mruggia/momav/README.md

# MOMAV

Codebase of the MOMAV omnidirectional drone. Further information can be found on the project website: 

[https://marcoruggia.ch/home?projects_momav](https://marcoruggia.ch/home?projects_momav)
