mruggia/momav/5_test/1_flight/overview.xlsx

date | place | type | nr | result | bag | prm | vid | changes | result
06.05.2022 | tivoli7 | static | 001 |  |  |  |  | with weights on legs, go to theoretical hover throttle and back | SUCCESS
 |  |  | 002 |  |  |  |  | with weights on legs, at min throttle, send all x,y,r,p,y commands, then do the same at hover throttle | SUCCESS
09.05.2022 | fhgr | manual | 003 |  |  |  |  | throttle up, no inputs | drifted -x +y
 |  |  | 004 |  |  |  |  | full stick +y,+x | drifted (y stick is flipped)
 |  |  | 005 |  |  |  |  | same as 004 | reacts to inputs
 |  |  | 006 |  |  |  |  | x+50%, y-50% trim | drift +y
 |  |  | 007 |  |  |  |  | x+50%, y-100% trim, flip y on remote | drift roughly correct
 |  |  | 008 |  |  |  |  | P_rot=0.4 | drift +y
 |  |  | 009 |  |  |  |  | y stick correction | SUCCESS
 |  |  | 010 |  |  |  |  | set ofset in remote instead of trim x:12,y:30, P_rot=0.6 | drift +y
 |  |  | 011 |  |  |  |  | remote offset y:-35 | ok, attitude not great
 |  |  | 012 |  |  |  |  | remote offset y:-30, P_rot=0.7,D_rot=0.1 | success?
 |  |  | 013 |  |  |  |  | P_rot=1.2,D_rot=0.15 | heavy oscilaltion at start but files ok
 |  |  | 014 |  |  |  |  | P_rot=2.0 | roll oscillations
 |  |  | 015 |  |  |  |  | P_rot=1.6,D_rot=0.2 | failed to save chages, redo
 |  |  | 016 |  |  |  |  | redo of 015 | slightly oscillating
 |  |  | 017 |  |  |  |  | P_rot=1.2,D_rot=0.15 | PD tuning "good"
 |  |  | 018 |  |  |  |  | try roll offset on remote | roll:-80 seems good
 |  |  | 019 |  |  |  |  | pretty flight for video | SUCCESS
16.05.2022 | fhgr | manual | 020 |  |  |  |  | redo previous, p=1.2,d=0.15 | SUCCESS
 |  |  | 021 |  |  |  |  | p=2.0,d=0.2 | oscillatin worse?
 |  |  | 022 | !! |  |  |  | p=4.0, d=0.4 | CRASH
27.06.2022 | fhgr | manual | 023 |  |  |  |  | p=1.2, d=0.15 | ok, not much drift
 |  |  | 024 |  |  |  |  | same, move roll setp | ok (pulled on tether)
 |  |  | 025 |  |  |  |  | same, move pitch setp | ok (pulled on tether)
 |  |  | 026 |  |  |  |  | p=1.6, d=0.15 | same?
 |  |  | 027 |  |  |  |  | p=1.6, d=0.10 | worse
 |  |  | 028 |  |  |  |  | p=1.2, d=0.20 | better, CRASH
 |  |  | 029 |  |  |  |  | p=1.2, d=0.25 | heavy drift from crash
 |  |  | 030 |  |  |  |  | p=1.2, d=0.15 | confirm heavy drift + fix arm up by eye
 |  |  | 031 |  |  |  |  | P=1.2, d=0.25 | better?
 |  |  | 032 |  |  |  |  | p=1.2, d=0.30 | same?
 |  |  | 033 |  |  |  |  | p=0.8, d=0.20 | worse
 |  |  | 034 |  |  |  |  | p=1.0, d=0.25 | better
 |  |  | 035 |  |  |  |  | same, move pitch setp | OK
19.11.2023 | tivoli11 | cam+man | 036 |  |  |  |  | state=cam, pos ctrl, ... | good, wobbly in orientation
 |  |  | 037 |  |  |  |  | d_rot=0.0 | unstable orientation
 |  |  | 038 |  |  |  |  | d_pos=0.0 | unstable position
 |  |  | 039 |  |  |  |  | d_rot=0.3 | feedback loop when on ground
 |  |  | 040 |  |  |  |  | p_rot=1.2 | better?
 |  |  | 041 |  |  |  |  | p_rot=1.5 | better
 |  |  | 042 |  |  |  |  | p_rot=1.8 | worse?
 |  |  | 043 |  |  |  |  | p_rot=2.2 | worse
 |  |  | 044 |  |  |  |  | p_rot=1.5 (keep), d_rot=0.25 | better, oscillation on ground
 |  |  | 045 |  |  |  |  | d_rot=0.3 + stable ground | sensible to oscillation
 |  |  | 046 |  |  |  |  | d_rot=0.25 (keep) + average cf,cm | hard to say
 |  |  | 047 |  |  |  |  | revert cf, cm | same
 |  |  | 048 |  |  |  |  | keep average cf,cm for simplicity p_rot=1.6 | worse
 |  |  | 049 |  |  |  |  | p_rot=1.4 | same?
 |  |  | 050 |  |  |  |  | p_rot=1.2 | sameish
 |  |  | 051 |  |  |  |  | p_rot=1.4 (keep), d_pos=10 | good
 |  | sim | 052 |  |  |  |  | state=sim | ok
 |  | cam+man | 053 |  |  |  |  | p_rot=1.4,d_rot=0.25,p_pos=50,d_pos=15 | ok
 |  |  | 054 |  |  |  |  | p_pos=60, d_pos=12 | too much oscillation
 |  |  | 055 |  |  |  |  | p_rot=1.4,d_rot=0.25, p_pos=40, d_pos=8 (keep) + fly xyz, rpy | GOOD
 |  |  | 056 |  |  |  |  | repeat | GOOD
 |  |  | 057 |  |  |  |  | check takeoff thrust | z_idle = -100mm, z_offset=-180mm
 |  |  | 058 |  |  |  |  | cf=18 | forgot to upload
 |  |  | 059 |  |  |  |  | cf=12 | forgot to upload
 |  |  | 060 |  |  |  |  | cf=14 repeat | better
 |  |  | 061 |  |  |  |  | cf=12 (keep) | no more z pos err
 |  |  | 062 |  |  |  |  | z_min=-0.1 avoid oscillation | wrench setpoint to high
 |  |  | 063 |  |  |  |  | arm_lim_fz=20, z_min=-0.25 | ok
 |  |  | 064 |  |  |  |  | i_pos=5, i_pos_lim=4 | OK
 |  |  | 065 |  |  |  |  | i_pos_lim=6 | no more pos static offset
 |  |  | 066 |  |  |  |  | i_rot=0.2, i_rot_lim=0.2 | still offset
 |  |  | 067 |  |  |  |  | i_rot_lim=0.5 | still offset
 |  |  | 068 |  |  |  |  | I_rot_lim=0.4 + fixed code bug | better
 |  |  | 069 |  |  |  |  | I_rot_lim=0.6, I_t_sat=5.0 | GOOD
 |  |  | 070 |  |  |  |  | repeat with moving setpoints | GOOD
 |  | sim | 071 |  |  |  |  | aph=6.28, state=sim | passed
 |  | cam+man | 072 |  |  |  |  | repeat irl | better?
 |  |  | 073 |  |  |  |  | aph=3.14 | works, maybe better..
 |  | slowmo | 074 |  |  |  |  | slow motion hover video | OK
 |  | free | 075 |  |  |  |  | tetherless | SUCCESS!
20.11.2023 | tivoli11 | cam+man | 076 |  |  |  |  | navigator acc/vel limit & aw=1e-4, apw=1e-2 | OK
 |  |  | 077 |  |  |  |  | repeat | OK
 |  |  | 078 |  |  |  |  | aw=1e-3, apw=1e-2 | weird thorttle spike heard. aborted.
 |  |  | 079 |  |  |  |  | vel_pos=0.6, acc_pos=0.3 | better
 |  |  | 080 |  |  |  |  | aw=5e-4, awp=5e-2 | same?
 |  |  | 081 |  |  |  |  | cm=0,0,0,... | same?
 |  |  | 082 |  |  |  |  | d_rot=0.3 | better
 |  |  | 083 |  |  |  |  | d_rot=0.35 | same?
 |  |  | 084 |  |  |  |  | d_rot=0.4 (keep) | same?
 |  |  | 085 |  |  |  |  | d_rot=0.5 | worse, twitchy on the ground
 |  |  | 086 |  |  |  |  | various pid params | better
 |  |  | 087 |  |  |  |  | hover screenshot | ok, but low battery
 |  |  | 088 |  |  |  |  | repeat with new battery | wobbly
 |  |  | 089 |  |  |  |  | revert to old pid | better?
 |  |  | 090 |  |  |  |  | back to new pid | worse
 |  |  | 091 |  |  |  |  | p_rot=1, d_rot=0.2 (weaken) | worse?
 |  |  | 092 |  |  |  |  | revert | ok
 |  |  | 093 |  |  |  |  | d_rot=0.3, d_pos=10 | worse?
 |  |  | 094 |  |  |  |  | revert | better
 |  |  | 095 |  |  |  |  | cf=14 | position offset
 |  |  | 096 |  |  |  |  | nice video | error on takeoff
 |  |  | 097 |  |  |  |  | nice video | OK
24.11.2023 | tivoli11 | cam+traj | 098 |  |  |  |  | test position setpoint trajectory for first time | wobbly orientation, aborted
 |  |  | 099 | ! |  |  |  | repeat | failed i2c error, aborted
 |  |  | 100 |  |  |  |  | repeat | success
 |  |  | 101 | ! |  |  |  | test orientation setpoint trajectory | wrench_controller failed. exceeded max iterations
 |  |  | 102 | ! |  |  |  | repeat | body_state_cam topic timed out
 |  |  | 103 | ! |  |  |  | repeat | wrench_controller failed. exceeded max iterations
 |  | cam+man | 104 |  |  |  |  | try manual setpoint changesn + more lights | OK (1x wrench_controller max iter.)
 |  | cam+traj | 105 | ! |  |  |  | orientation setpoint trajectory | oscillation + unstable before starting setpoint trajectory
 |  |  | 106 | ! |  |  |  | reset camera, max_iter=32 | at ~270° yaw: wrench_controller failed. exceeded max iterations
 |  | other | 107 |  |  |  |  | test spinning on chair | no problems
 |  | cam+traj | 108 |  |  |  |  | orientation setpoint trajectory (normalize quaternions in code) | oscillation again... abort
 |  |  | 109 | !! |  |  |  | reset camera + repeat | controller_wrench failed. throttle out of range -> broke landing gear
25.11.2023 | tivoli11 | cam+traj | 110 |  |  |  |  | fixed bugs -> redo pos. setp. traj. | oscillating
 |  |  | 111 |  |  |  |  | removed feedforward terms | same
 |  |  | 112 |  |  |  |  | try rot. set. traj. | no more crash! still oscillating
 |  |  | 113 |  |  |  |  | disable integral | still oscillating
 |  |  | 114 |  |  |  |  | p&d *0.75 | still oscillating
 |  | track+man | 115 | !! |  |  |  | try optitrack pose estim | same oscillation-> lost tracking -> CRASH
 |  |  | 116 | !! |  |  |  | repeat, hardcoded track hz | lost tracking, dropped packets -> CRASH
 |  | cam+man | 117 |  |  |  |  | revert back to camera, readjust motor zero | arm 6 not spinning -> defect brush ring!
 |  |  | 118 | ! |  |  |  | fixed brush ring | camera timeout -> CRASH
 |  |  | 119 |  |  |  |  | repeat | battery empty
 |  | cam+traj | 120 |  |  |  |  | pos. set. traj. | SUCCESS
 |  |  | 121 | !! |  |  |  | rot. set. traj. | noticed cam pos estim errors! i2c motor write/read error! -> CRASH
26.11.2023 | tivoli11 | cam+traj | 122 | !! |  |  |  | pos. set. traj. | arm 2 not spinning
 |  |  | 123 |  |  |  |  | repeat | arm 6 not spinning
 |  |  | 124 |  |  |  |  | repeat | SUCCESS
 |  |  | 125 |  |  |  |  | rot. set. traj. | SUCCESS
02.12.2023 | tivoli11 | cam+traj | 126 |  |  |  |  | pos. set. traj. + some bugfixes | ok, a bit wobbly
 |  |  | 127 |  |  |  |  | rot. set. traj. | ok, a bit wobbly + one motor starts spinning later than the others!
 |  | track | 128 |  |  |  |  | track without motors spinning | packet delays
 |  |  | 129 |  |  |  |  | repeat with code fixes | same. delay between camera and motive.
 |  |  | 130 |  |  |  |  | repeat with cameras on desk (shorter cables, official router) | same
 |  |  | 131 |  |  |  |  | fix code for mocap track (adds delay....) | same delay also on ros network packets...
 |  |  | 132 |  |  |  |  | repeat with laptop + momav_net hotspot | works. only minor packet delay/jitter
07.12.2023 | tivoli11 | track | 133 |  |  |  |  | new ground pc + marco_net: latency test | ok latency
 |  |  | 134 |  |  |  |  | new ground pc + drone_net hotspot 2.4ghz: latency test | spikes at end?
 |  |  | 135 |  |  |  |  | new ground pc + drone_net hotspot 5ghz: latency test | same, spikes at end -> ground pc hotspot no good!
11.12.2023 | tivoli11 | track+pos | 136 | !! |  |  |  | pos. set. traj with new ground pc & router | crash, lost wifi for 0.4sec
 |  |  | 137 |  |  |  |  | repeat, set wifi 2.5ghz | success, wobbly, body_setp_track timestamps offset!
 |  | track+rot | 138 |  |  |  |  | rot. set. traj. | aborted. weird sound, otherwise good start, still wobbly
 |  | track+pos | 139 |  |  |  |  | repeat set. traj with fixed timestamps | OK
 |  | track+rot | 140 |  |  |  |  | rot. set. traj. | remote_driver timeout?
 |  |  | 141 |  |  |  |  | repeat | OK
 |  |  | 142 |  |  |  |  | rever cf, cm to calibrated data (corrected for hover) | same
 |  |  | 143 |  |  |  |  | double integral I_pos=10, I_rot=0.4
 |  |  | 144 |  |  |  |  | increase integral I_pos=15, I_rot=0.6 (keep) | aborted. battery
 |  |  | 145 |  |  |  |  | repeat | slightly unstable
 |  |  | 146 | ! |  |  |  | increase derivative D_pos=10, D_rot=0.35 | oscillating in orientation, crash
 |  |  | 147 |  |  |  |  | D_pos=12, D_rot=0.25 (keep)
 |  |  | 148 |  |  |  |  | I_pos=20, I_rot=0.8 | better pos, oscillating a bit in rot
 |  |  | 149 |  |  |  |  | I_pos=30, I_rot=0.6
 |  |  | 150 |  |  |  |  | I_pos=40, I_rot=1.2
 |  |  | 151 |  |  |  |  | I_pos=60, I_rot=1.0
 |  |  | 152 |  |  |  |  | I_pos=80, I_rot=1.2
 |  |  | 153 |  |  |  |  | I_pos=100, I_rot=1.6 | loads of oscillation
 |  |  | 154 |  |  |  |  | I_pos=120, I_rot=1.0
 |  |  | 155 |  |  |  |  | I_pos=140, I_rot=0.8
 |  |  | 156 | ! |  |  |  | I_pos=120, I_rot=0.8, P_pos=60, D_pos=18 | crash
 |  |  | 157 |  |  |  |  | P_pos=60, D_pos=12 | ok, oscillation on ground, aborted for battery
 |  |  | 158 |  |  |  |  | P_pos=80 | oscillating
 |  | track+free | 159 |  |  |  |  | P_pos=100, D_pos=8 | oscillating heavily
 |  |  | 160 |  |  |  |  | P_pos=80, D_pos=8 | still oscillating in position
 |  | track+rot | 161 |  |  |  |  | P_pos=80, D_pos=12 (keep)
 |  |  | 162 |  |  |  |  | I_rot=1.2
 |  |  | 163 |  |  |  |  | I_rot=1.6, D_rot=0.20 | worse
 |  |  | 164 |  |  |  |  | ???
 |  |  | 165 |  |  |  |  | P_rot=1.4, I_rot=1.2, D_rot=0.3
 |  |  | 166 |  |  |  |  | P_rot=1.2
 |  |  | 167 |  |  |  |  | P_rot=1.0, D_rot=0.25
 |  |  | 168 |  |  |  |  | P_rot=1.2, D_rot=0.25
 |  |  | 169 |  |  |  |  | P_rot=1.4, D_rot=0.25
 |  |  | 170 |  |  |  |  | P_rot=1.6, D_rot=0.25
 |  |  | 171 |  |  |  |  | P_rot=1.6, D_rot=0.30
 |  |  | 172 |  |  |  |  | P_rot=1.4, D_rot=0.30
 |  |  | 173 |  |  |  |  | P_rot=1.4, D_rot=0.25 (keep)
 |  |  | 174 |  |  |  |  | I_rot=1.6 (keep) | battery empty
 |  |  | 175 | ! |  |  |  | upl=0.02, uph=0.98, aph=1.57 | crash
 |  |  | 176 |  |  |  |  | revert
 |  |  | 177 |  |  |  |  | repeat
 |  |  | 178 |  |  |  |  | repeat
 |  |  | 179 |  |  |  |  | upl=0.02, uph=0.98, aph=6.28
 |  |  | 180 |  |  |  |  | upl=0.5, uph=0.95
 |  |  | 181 |  |  |  |  | repeat
 |  | track+pos | 182 |  |  |  |  | track+pos (aph=3.14) | battery empty
 |  | track+rot | 183 |  |  |  |  | track+rot repeat | bad config at takeoff
 |  |  | 184 |  |  |  |  | repeat
 |  |  | 185 |  |  |  |  | D_rot=0.3 | worse, revert.
 |  |  | 186 |  |  |  |  | repeat, revert D_rot=0.25
 |  |  | 187 | ! |  |  |  | repeat
 |  | track+pos | 188 | ! |  |  |  | track+pos
 |  |  | 189 |  |  |  |  | repeat
 |  |  | 190 |  |  |  |  | repeat | battery empty
13.12.2023 | tivoli11 | track+rot | 191 |  |  |  |  | track+rot like before | ok
 |  |  | 192 |  |  |  |  | drive_track filter=0.15 | crash, lost tracking
 |  |  | 193 |  |  |  |  | repeat | much worse oscillation
 |  |  | 194 |  |  |  |  | drive_track filter=0.5 | very stable takeoff, then flips out, track cam 1 disconnected!
 |  |  | 195 |  |  |  |  | repeat | WAY WAY WAY less oscillation!!
 |  | track+free | 196 |  |  |  |  | move arround to test free mode | ok
 |  |  | 197 |  |  |  |  | vel_pos=1.0, acc_pos=0.5
 |  | cam+free | 198 |  |  |  |  |  | ok, position estimate juming, room dark?
14.12.2023 | fhgr | cam+free | 199 |  |  |  |  | demo | very jumpy + wobbly
 |  |  | 200 |  |  |  |  | D_rot=0.2 | very jumpy + wobbly
 |  |  | 201 |  |  |  |  | z_min=-0.05 to avoid oscillation.. | very jumpy + wobbly
 |  | cam+pos | 202 |  |  |  |  | pos traj | very jumpy + wobbly
 |  |  | 203 |  |  |  |  | pos traj + added more features on walls + covered windows | a bit better
 |  | cam+free | 204 |  |  |  |  | demo | ok, not great
 |  |  | 205 |  |  |  |  | demo | ok, not great
 |  |  | 206 |  |  |  |  | demo | ok, not great
17.12.2023 | tivoli11 | track+free | 207 | ! |  |  |  | test changes to driver_track (les latency?) | crash. unstable
 |  |  | 208 |  |  |  |  | D_rot=0.15, D_pos=8 | better
 |  |  | 209 |  |  |  |  | D_rot=0.20, D_pos=12 | worse. jerks
 |  |  | 210 |  |  |  |  | driver_track flt_lat=0.0 | better?
 |  |  | 211 |  |  |  |  | driver_track flt_lat=-0.005 | worse?
 |  |  | 212 |  |  |  |  | reorient axes in optitrack, flt_lat=0.0
 |  |  | 213 |  |  |  |  | d_rot=0.25 | too much oscillation
 |  |  | 214 | !! |  |  |  | d_rot=0.4 | crash
 |  |  | 215 |  |  |  |  | d_rot=0.2, d_pos=10 | ok, bit wobbly
 |  | track+rot | 216 |  |  |  |  | flt_win=12 | ok, wobbly in position
 |  |  | 217 |  |  |  |  | flt_win=24, bugfix driver_track | better?
 |  | track+free | 218 | !! |  |  |  | d_rot=0.25 | crash (ripped of antenna....)
 |  |  | 219 | ! |  |  |  | d_rot=0.2, d_pos=10, remove latency predict from driver_track | drift, uncontrolled??
 |  |  | 220 |  |  |  |  | retry | same
 |  |  | 221 |  |  |  |  | fix bug in driver_track | ok, wobbly in position
 |  |  | 222 |  |  |  |  | d_pos=8 | worse?
 |  |  | 223 |  |  |  |  | d_pos=6 | worse
 |  | track+pos | 224 |  |  |  |  | d_pos=16 | better. much better pos ctrl
 |  | track+rot | 225 |  |  |  |  | d_rot=0.25 (revert) | worse
 |  |  | 226 |  |  |  |  | p_rot=1.2 | worse
 |  |  | 227 | ! |  |  |  | p_rot=1.6 | worse. abort
 |  |  | 228 |  |  |  |  | d_rot=0.15 | wobbly
 |  |  | 229 |  |  |  |  | p_rot=1.2, d_rot=0.15 | wobbly
 |  |  | 230 |  |  |  |  | p_rot=1.4, d_rot=0.2 (original) | OK
 |  |  | 231 |  |  |  |  | p_rot=1.6, d_rot=0.25 | better. high freq wobble
 |  |  | 232 |  |  |  |  | i_rot=2.0 | better? more!
 |  |  | 233 |  |  |  |  | i_rot=3.0 | unstable
 |  |  | 234 |  |  |  |  | i_rot=2.4 | unstable
 |  |  | 235 |  |  |  |  | i_rot=2.0 | unstable??? was stable before.. cause: new battery?
 |  |  | 236 |  |  |  |  | i_rot=1.6 | still unstable. not the cause..
 |  |  | 237 |  |  |  |  | p_rot=1.4, d_rot=0.2 | OK
 |  |  | 238 |  |  |  |  | i_rot=3.0
 |  |  | 239 |  |  |  |  | i_rot=4.0
 |  |  | 240 |  |  |  |  | i_rot=6.0
 |  |  | 241 |  |  |  |  | i_rot=8.0, i_t_sat=3 | worse?
 |  |  | 242 |  |  |  |  | revert i_t_sat | takeoff problems
 |  |  | 243 |  |  |  |  | repeat | worse
 |  |  | 244 |  |  |  |  | i_rot=6.0 (repeat of 240) | OK
 |  |  | 245 |  |  |  |  | p_rot=1.6, d_rot=0.25 | battery empty, but worked!
 |  |  | 246 |  |  |  |  | cf=14, cm=0.21 | GOOD
 |  |  | 247 |  |  |  |  | cf=16 (revert) | invalid wrench setpoint
 |  |  | 248 |  |  |  |  | cm=0.31 | worse?
 |  |  | 249 |  |  |  |  | cm=0.15 | worse
 |  |  | 250 | ! |  |  |  | cm=0.22, d_rot=0.3 | invalid wrench setpoint
 |  |  | 251 |  |  |  |  | d_rot=0.25, p_rot=1.8 | ok
 |  |  | 252 |  |  |  |  | p_rot=2.0 | worse
 |  |  | 253 |  |  |  |  | I_t_sat=4.0, I_rot=8 (revert) | worse
 |  |  | 254 |  |  |  |  | p_pos=100, I_pos=150, d_pos=18 | invalid wrench setpoint
 |  |  | 255 |  |  |  |  | cf=13 | barely stable
 |  |  | 256 |  |  |  |  | d_rot=0.2 | worse
 |  |  | 257 |  |  |  |  | d_rot=0.25, p_rot=1.8 | GOOD
 |  |  | 258 | ! |  |  |  | p_rot=2.0 | unstable
 |  |  | 259 | ! |  |  |  | p_pos=120 | unstable
 |  |  | 260 |  |  |  |  | d_pos=20 | ok
 |  |  | 261 |  |  |  |  | p_pos=120, d_pos=20 | ok
 |  |  | 262 |  |  |  |  | i_pos=300 | battery empty. no change. i_t_sat limiting?
 |  |  | 263 |  |  |  |  | i_t_sat=4.0, I_rot=1.6, i_pos=120
 |  |  | 264 |  |  |  |  | var... integral
 |  |  | 265 |  |  |  |  | rot: 1.6, 3.6, 0.2 | more wobbly
 |  |  | 266 |  |  |  |  | rot: 1.9, 3.6, 0.25 | bit better
 |  |  | 267 |  |  |  |  | rot: 2.0, 3.6, 0.25 | unstable
 |  |  | 268 |  |  |  |  | rot:1.8,3.6,0.25 (standard) | GOOD
 |  | track+pos | 269 | rev1 |  |  |  | eval
 |  | track+rot | 270 |  |  |  |  | eval | battery empty
 |  |  | 271 |  |  |  |  | eval | a bit wobbly
 |  |  | 272 |  |  |  |  | eval | wobbly. incomplete
 |  |  | 273 |  |  |  |  | eval | wobbly. incomplete
 |  |  | 274 | rev1 |  |  |  | eval | GOOD
05.04.24 | tivoli11 | track+rot | 275 |  |  |  |  | first manual flight | verry wobbly..
 |  |  | 276 |  |  |  |  | contact cleaner on brushes -> repeat | same. possibly no video. crash. very laggy wifi....
 |  |  | 277 |  |  |  |  | changed some wifi settings to default -> repeat | less laggy wifi. same wobbly
 |  |  | 278 |  |  |  |  | cf=16 | better
 |  |  | 279 |  |  |  |  | cf=20 | invalid wrench setpoint
 |  |  | 280 |  |  |  |  | cf=18 | invalid wrench setpoint
 |  |  | 281 |  |  |  |  | cf=15 | ok
 |  |  | 282 |  |  |  |  | cf=15, cm=0.18, rot sweep | ok
 |  |  | 283 |  |  |  |  | continuous rotation | wrong rotation axis + invalid wrench setpoint
 |  | track+cnt | 284 |  |  |  |  | cf=14 + bugfix, continuous rotation | GOOD
 |  | track+rot | 285 |  |  |  |  | orientation sweep | GOOD
 |  |  | 286 |  |  |  |  | orientation sweep | VERY GOOD
 |  | track+cnt | 287 | rev2 |  |  |  | continuous rotation | GOOD
 |  | track+rot | 288 |  |  |  |  | aw=apw=aph=0, continuous rotation | better than with weights......
 |  | track+pos | 289 |  |  |  |  | position sweep | aborted. loose marker
 |  |  | 290 | rev2 |  |  |  | repeat | GOOD
 |  | track+rot | 291 |  |  |  |  | orientation sweep | controller_wrench failed
 |  |  | 292 |  |  |  |  | removed sqp entirely.. repeat | GOOD
 |  |  | 293 |  |  |  |  | cf=16, aw=1e-6,apw=1e-4,aph=2pi
 |  |  | 294 |  |  |  |  | aw=1e-5, I_pos=400 | worse
 |  |  | 295 |  |  |  |  | P_pos=50, I_pos=100 | worse pos, no improvement in rot
 |  |  | 296 |  |  |  |  | aw=1e-4, revert rest | crash, remote topic timed out.
 |  |  | 297 |  |  |  |  | aw=1e-5, apw=1e-3, aph=2pi,cf=14 | good pos, but still spikes
 |  |  | 298 |  |  |  |  | aph=pi | slightly shorter spikes?
 |  |  | 299 |  |  |  |  | apw=1e-2 | better?
 |  |  | 300 |  |  |  |  | repeat with fresh battery | no change?
 |  |  | 301 |  |  |  |  | apw=1e-1 | no change?
 |  |  | 302 |  |  |  |  | apw=1e1 | no change?
 |  |  | 303 |  |  |  |  | aw=1e-3, apw=1e1 | no changes still...
 |  |  | 304 |  |  |  |  | build clean, aw=1e-2, apw=1e2 | wrench control fails
 |  |  | 305 |  |  |  |  | aw=1e-3, apw=1e1 | wrench control fails
 |  |  | 306 |  |  |  |  | aw=1e-4, apw=1e0 | wrench control fails
 |  |  | 307 |  |  |  |  | aw=1e-5, apw=1e-1 | wrench control fails
 |  |  | 308 |  |  |  |  | aw=0 | wrench control fails... 293 to 308 sqp wrench controller was broken
06.04.2024 | tivoli11 | yes sqp | 309 |  |  |  |  | rese to 286 state | a bit wobbly. maybe high voltage?
 |  |  | 310 |  |  |  |  | cf=15 | worse
 |  |  | 311 |  |  |  |  | cf=13 | better
 |  |  | 312 |  |  |  |  | cf=12 | worse. abort
 |  |  | 313 |  |  |  |  | cf=13 repeat | GOOD
 |  |  | 314 |  |  |  |  | aw=0.5e-5, apw=0.5e-3 | remote topic timed out
 |  |  | 315 |  |  |  |  | repeat | motor 3 not spinning
 |  |  | 316 |  |  |  |  | repeat | motor 3 not spinning, repaired
 |  |  | 317 |  |  |  |  | repeat | GOOD, no more spikes!
 |  |  | 318 |  |  |  |  | aw=0.8e-5, apw=0.8e-3 | GOOD
 |  |  | 319 | ! |  |  |  | repeat with new battery | unstable?!
 |  |  | 320 |  |  |  |  | cf=14 | OK
 |  |  | 321 |  |  |  |  | cf,cm from calb. avg cf=14, km=0.013 | worse rot error
 |  |  | 322 |  |  |  |  | cf=13 | OK
 |  |  | 323 | ! |  |  |  | p_rot=2.15, d_rot=0.3 | unstable
 |  |  | 324 |  |  |  |  | p_rot=2.0, d_rot=0.25 | oscillating more in rot
 |  | no sqp | 325 |  |  |  |  | revert pid tuning, disable sqp | OK
 |  |  | 326 | rev2 |  |  |  | repeat | OK
 |  | yes sqp | 327 |  |  |  |  | enable sqp | aborted, low battery
 |  |  | 328 | ! |  |  |  | repeat with new battery | unstable
 |  |  | 329 |  |  |  |  | cf=15 | ok
 |  |  | 330 | ! |  |  |  | cf=14 | auto abort???!
 |  |  | 331 |  |  |  |  | repeat | ok
 |  |  | 332 |  |  |  |  | cf=13 | ok
 |  |  | 333 |  |  |  |  | repeat | ok
 |  |  | 334 |  |  |  |  | aw=0.6e-5, apw=0.6e-3 | ok
 |  |  | 335 |  |  |  |  | aw=0.5e-5, apw=0.5e-3 | ok
 |  |  | 336 |  |  |  |  | aw=0.4e-5, apw=0.4e-3 | low battery
 |  |  | 337 |  |  |  |  | aw=0.2e-5, apw=0.2e-3 | ok
 |  |  | 338 |  |  |  |  | aw=1e-6, apw=1e-4 | ok
 |  |  | 339 | rev2 |  |  |  | aw=5e-6, apw=5e-4 | ok. leave it like this ffs..
 |  | no sqp | 340 |  |  |  |  | no sqp | ok
 |  |  | 341 |  |  |  |  | repeat | abort, low bat
