mruggia/momav/9_docs/2_hardware/optitrack_13w/optitrack_latency.xlsx

 | https://docs.optitrack.com/developer-tools/natnet-sdk/latency-measurements
 | A->B | B->D | D->E | E'->E
0 | 4.52452 | 0.312532 | 0.223628 | 0.001
1 | 4.538164 | 0.334832 | 2.2831 | 6.262
2 | 4.53062 | 0.389632 | 0.136344 | 2.067
3 | 4.571808 | 0.375432 | 0.134356 | 4.191
4 | 4.500308 | 0.366232 | 0.057716 | 4.008
5 | 4.498864 | 0.329132 | 0.14972 | 4.22
6 | 4.529696 | 0.361832 | 0.140016 | 4.22
7 | 4.49952 | 0.287332 | 0.131284 | 4.053
8 | 4.512708 | 0.267232 | 0.125808 | 4.154
9 | 16.622352 | 0.373432 | 0.154392 | 16.411
10 | 13.01812 | 0.288632 | 0.135264 | 0.459
11 | 9.291264 | 0.299976 | 0.080364 | 0.396
12 | 5.62462 | 0.269276 | 0.193252 | 0.582
13 | 4.511664 | 0.327276 | 0.108964 | 3.026
14 | 4.512052 | 0.372532 | 0.13214 | 4.235
15 | 4.51112 | 0.309232 | 0.159052 | 4.129
16 | 4.50632 | 0.287576 | 0.129656 | 4.111
17 | 4.514164 | 0.344076 | 0.184664 | 4.285
18 | 4.525364 | 0.304632 | 0.133248 | 4.087
19 | 4.47062 | 0.300232 | 0.116572 | 4.09
20 | 4.51652 | 0.317132 | 0.12474 | 4.237
21 | 4.493864 | 0.318232 | 0.078368 | 4.098
22 | 4.51482 | 0.304032 | 0.085336 | 4.18
23 | 4.53562 | 0.290932 | 0.134888 | 4.209
24 | 4.500164 | 0.289376 | 0.07176 | 4.065
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
