mruggia/momav/9_docs/0_report/other/momav_old1.pdf

# MOMAV Marco’s Omnidirectional Micro Aerial Vehicle

Marco Ruggia

Abstract—This paper presents a number of developments related to omnidirectional aerial vehicles, meaning vehicles with decoupled translational and rotational dynamics. In particular it concerns itself with multicopters that actively rotate their arms to achieve omnidirectionality. Proposed are, a highly symmetrical placement of rotor-arms, a small-scale rotating arm assembly that allows for continuous rotation, and a SQP based control allocation algorithm. These approaches are implemented in a purpose-built drone and results of testflights are presented.

I. INTRODUCTION

Omnidirectional aerial vehicles are able to exert forces and torques independently, enabling them to decouple translational and rotational dynamics. This characteristic has been found to be particularly useful in the many manipulation tasks, when aerial vehicles need to be in contact with the environment [3, 7]. Less commonly they can also be used as an alternative to gimbals for visual inspection and surveying applications. Omnidirectional aerial vehicles are most commonly of the multicopter kind and come in mainly two designs. Fixed-tilt designs where the rotors are fixedly tilted in a nonparallel fashion [4, 5], and variable-tilt designs where the rotor arms can be actively rotated [2]. This paper proposes possible improvements to the existing variable-tilt designs. In particular three contributions are presented:
‚ A highly symmetrical rotor-arm configuration in the shape of an octahedron, including its practical implementation.
‚ A small-scale rotating arm assembly providing continuous rotation by use of a modified hobbyist servo motor and a custom slip ring.
‚ A control allocation algorithm based on Sequential Quadratic Programming (SQP), allowing for the use of easily tunable objective functions.
These contributions are implemented in a purpose-built drone (Fig. 1) and testflights are performed to showcase its capabilities. Since this is a hobbyist project, a special emphasis was placed on keeping overall cost of the drone low and on limiting the required tools and materials to commonly available ones. As a result, the drone is relatively simple and easy to build.

II. BODY GEOMETRY

One commonality of the current generation of variable-tilt omnidirectional aerial vehicles, is that they use rotating arms that are all coplanar. In this configuration the load carrying capacity and efficiency depend highly on the orientation,

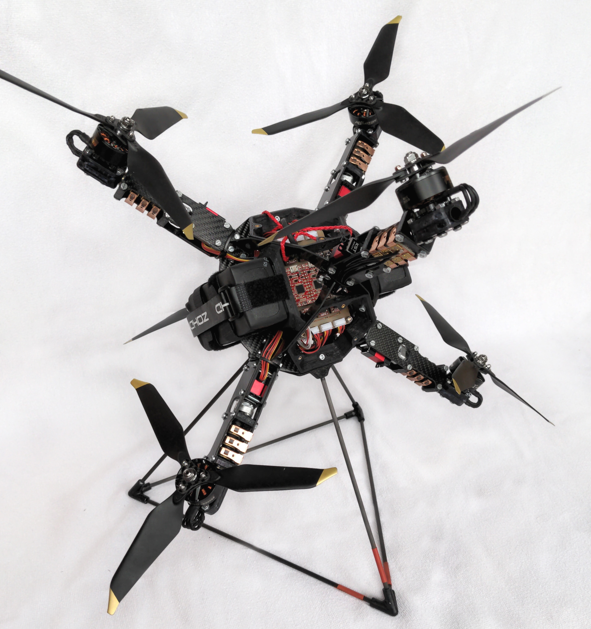
[picture p2: figure]

Fig. 1: Prototype drone MOMAV, used to evaluate proposals

which can be an undesirable trait. Instead, this project proposes a more symmetrical placement of the arms.
To compare various geometries, the maximum load carrying efficiency is used, meaning the fraction of total available thrust that can be applied upwards for any given orientation. This value is not a particularly good metric, as multicopter rarely operate at or near maximum load, but it’s thought to be roughly comparable to efficiency under more reasonable conditions.

xi

: rot. axis of arm i, q: body orientation

ni “ normalize p pqxi ˆ p0, 0, 1q

T
q ˆ qxi q

effic. “

1
N

ÿ

N

i“1

ni

¨ p0, 0, 1q

T
(1)

A natural starting point for choosing symmetrical arm placements are the vertices of the platonic solids. The options with a reasonable number of arms are: a tetrahedron (4), an octahedron (6) or a cube (8). All of these provide more than than the 6 degrees of freedom required for omnidirectionality, providing two per arm (angle & throttle). Out of these three the octahedron is chosen as a project specific trade-off between manufacturability, cost and efficiency (Fig. 2).

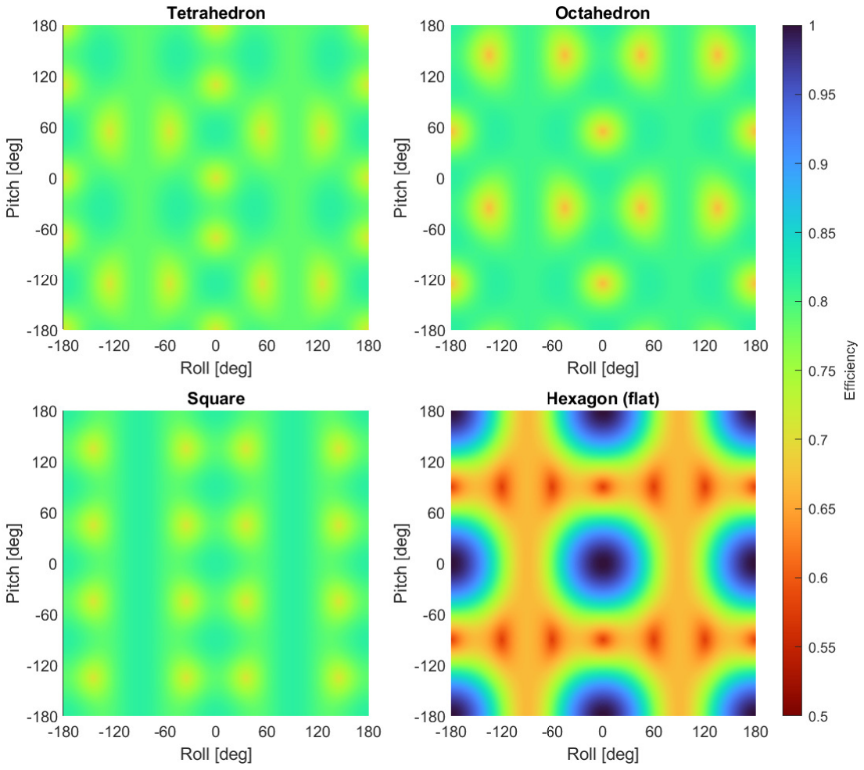
[picture p3: figure]

Fig. 2: Maximum load carrying efficiency vs. orientation

The octahedral body (Fig. 3) is constructed using six flat half-rings where each one follows two consecutive edges of the octahedron. Each vertex is then at a meeting point of one center and two ends of the half-rings. The arms are made with two parallel sheets placed perpendicularly to the passing half-ring at each vertex. Two halved joints on the passing half-ring prevent the arm from moving up-down, while the two half-ring ends prevent it from moving left-right. Twisting is addressed by connecting the three edges of each face of the octahedron with hexagons, creating a truncated octahedron shape. Relying mainly on interlocking contacts for connections instead of friction from screws was found to lead to a more rigid construction with no noticeable play.

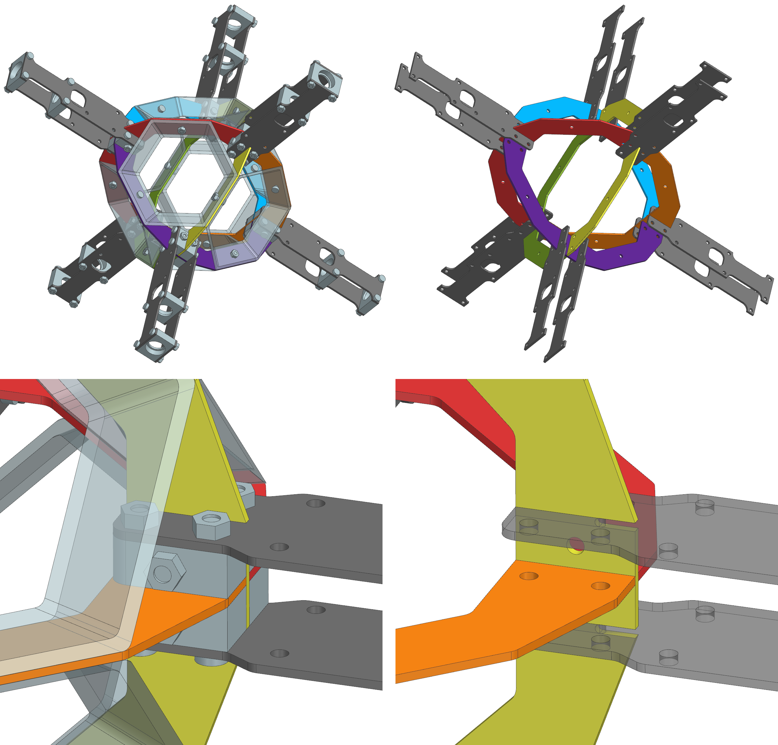
[picture p4: figure]

Fig. 3: Detailed views of the octahedral body implementation

III. ROTATING ARM ASSEMBLY
A second noteworthy part of this project is the rotating arm assembly. It’s function is to position the propellers at any given angle around the arms. To maintain the high degree of symmetry, a requirement of this assembly is to allow for continuous rotation. This decision has the added benefit of simplifying the flight controller. In return, two challenges appear. How can the continuous angular positioning be achieved and how can power then be transmitted to the propellers.
A. Arm Actuator
The proposed solution for the arm actuators is largely driven by the low-cost constraint. While suitable small-scale and high-accuracy actuators are available, none are particularly affordable. To overcome this challenge a ~100° limited servo,

commonly found in model aircraft, is modified to support continuous rotation.
The servo used is the KST MS325. Unlike most servos of this type it uses a magnetic encoder as feedback for position control, instead of a potentiometer. This gives the servo the mechanical ability to be rotated continuously. The encoder used is the AMS AS5600, configured by default to output an analog voltage emulating a potentiometer. The stock feedback control circuit is then the same as in potentiometer based servos. To achieve continuous rotation this control circuit is replaced by an ATSAMD21 microcontroller and a TI DRV8870 motor driver. The encoder is then connected trough its I2C interface, to unlock the full 360° measuring range and to provide the many well known advantages over an analog interface. Feedback control is implemented with a PID loop running on the microcontroller in a way that allows for setpoints outside the 0°-360° range. To avoid overshoots a proportional on measurement [1] approach is used. Tuning is performed manually by trial and error.

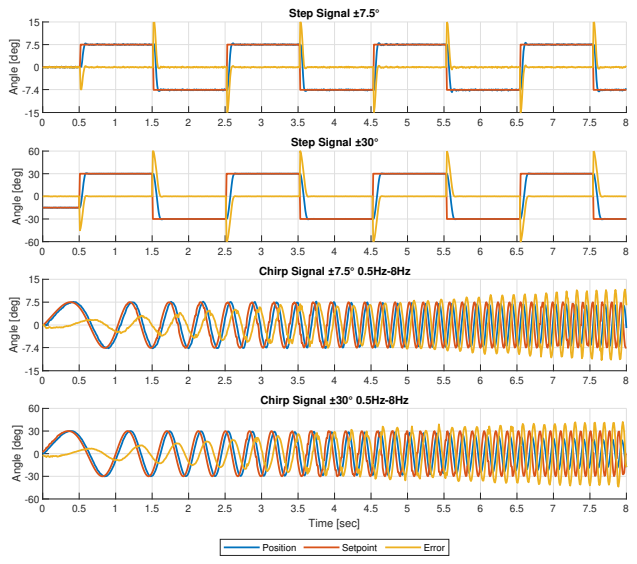
[picture p5: figure]
Angle [deg]; Step Signal ±7.5°; Step Signal ±30°; Chirp Signal ±7.5° 0.5Hz-8Hz; Time [sec]; Chirp Signal ±30° 0.5Hz-8Hz; Position; Setpoint; Error

Fig. 4: Servo arm responses to step and chirp signals with propeller spinning at 80% throttle (~15N thrust)

Parameter | Value
Proportional gain (on measurement) | 7.6 / rad
Integral gain | 220.0 / (rad¨sec)
Derivative gain | 0.05 / (rad/sec)
PID loop rate | 1 kHz
Encoder polling rate | 4 kHz
Encoder exp. smoothing constant | 0.2
Output range | ±1.0

TABLE I: Parameters of arm servo control loop

This approach to arm actuation has produced very satisfactory results, considering the relatively low cost and small size. Some key figures are a peak velocity of 2.5 rev/sec, peak torque of 0.51 Nm and the fast dynamic behaviour as shown in Figure 5. It appears that the main contributor to tracking error is the maximum velocity, as there are no significant time delays and the acceleration is comparatively fast.

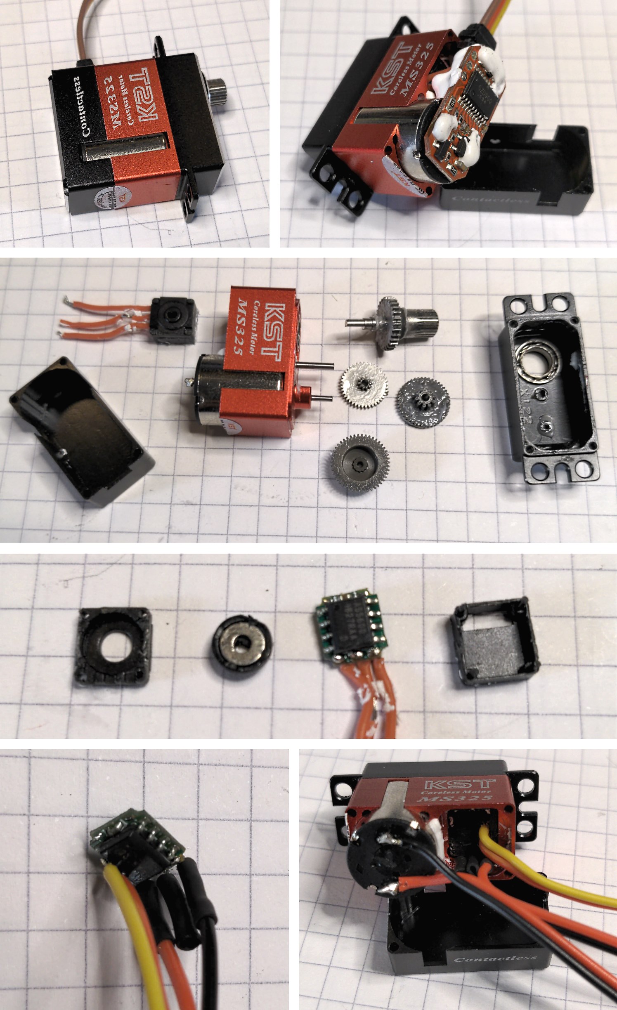
[picture p6: figure]

Fig. 5: Modification steps of the KST MS325 servo for continuous rotation, not including the new control board

B. Slip Ring
The other challenge of the rotating arm assembly is to transmit electrical power from the stationary part of the arm to the rotating part for the propeller motor. Such a component is commonly called a slip-ring. Like for the arm actuators, it is difficult to find one in the correct size, cost & power rating range. This project proposes a solution using brushes harvested from the ubiquitous RS550 DC motors (Fig. 6).

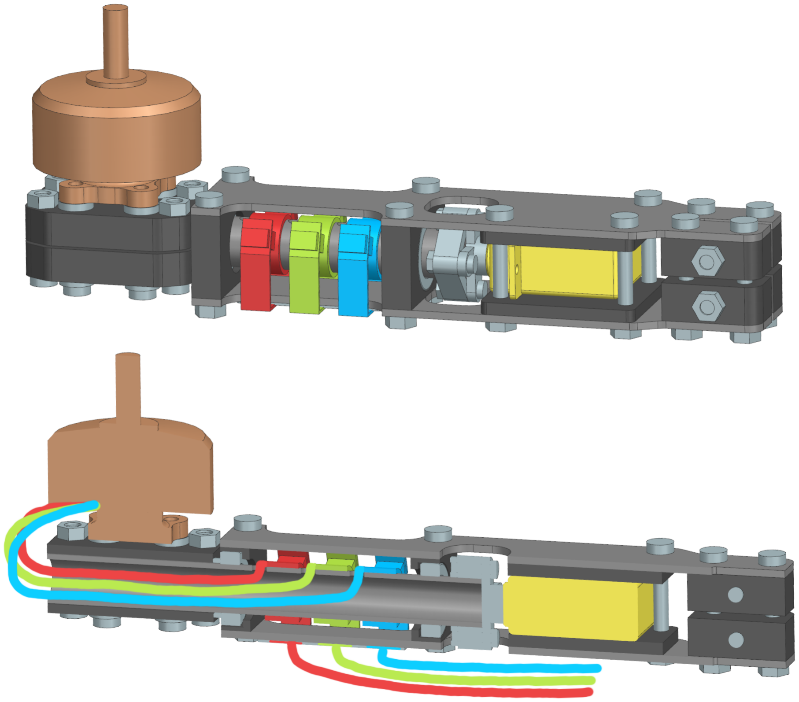
[picture p7: figure]

Fig. 6: Rotating arm assembly with a section view showing internal wiring of the slip-rings
In practice three slip-rings are built for each phase of the propeller motors, as this makes packaging easier than the alternative of having slip rings on the other side of the motor controllers. Each phase has two brushes soldered to a carrier circuit board such that their contacts push against a rotating tube. The tube is isolated by electrical tape and under the contact patches three copper rings are glued. Next to each ring a hole is drilled into the tube through which an electrical wire is routed and soldered to the side of the copper ring. These wires connect to the propeller motor, while the carrier board goes on to connects to the motor controller.
A test is performed to determine what the capabilities of this assembly are. For this purpose six slip-rings are individually subjected to constant currents ranging from 1 A to 5 A and the voltage drop-off is measured to calculate power loss. The low maximum tested current is due to limits of the used power supply. During all tests a small USB fan is used to cool the slip-rings, similarly to how the propeller would.
Results of these tests are plotted in Figure 7. For the here discussed drone, 5A current per motor is roughly what’s needed for hover. That current over two slip-rings at a time induces a loss of about 4 W, which is 3.2% of total power. This result is acceptable for the given drone, but is probably improvable with shorter brushes and more care in producing consistent contact patches.
Concerns on heat dissipation at higher currents are recognized but could not be easily tested.

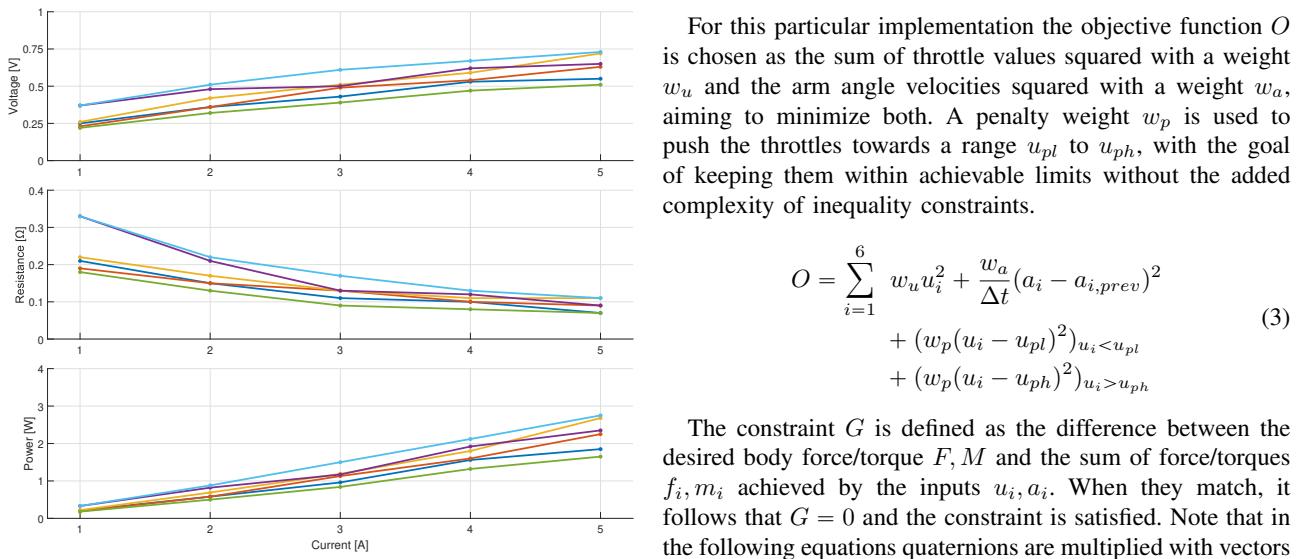
[picture p8: figure]
Voltage [V]; Current [A]; Power [W]; complexity of inequality constraints.; wuu; pai ´ ai,prevq; ` pwppui ´ uplq; quiăupl; ` pwppui ´ uphq; quiąuph; , mi achieved by the inputs ui; . When they match, it

Fig. 7: Results of the slip-ring power loss tests on six samples

IV. CONTROL ALLOCATION
The last aspect of this project that is presented is the control allocation algorithm. It’s goal is to calculate the target arm angles and throttle values, such that some total force and torque setpoint is met. This system is highly overactuated with 12 variables (6 arm angles & 6 throttles) and only 6 constraints (3 forces & 3 torques). For this reason a numerical optimization approach is use where the constraints have to be satisfied (G “ 0) and the remaining degrees of freedom are chosen such that they minimize some objective function (O).

pu

˚

, a˚
q “ argmin Opu, aq s.t. Gpu, a, q, F, Mq “ 0 (2)
Name | Description | Type

Inputs:
q | body orientation quaternion | P H
F | desired body force | P R
| | 3 ,rNs
M | desired body torque | P R
| | 3 ,rNms

Outputs:
ai | angle of arm i | P R,rrads
ui | motor throttle of arm i | P R,p0, 1q

Constants:
ri | arm endpoint | P R
| | 3 ,rms
xi | arm rotation axis | P R
| | 3 , ∥¨∥ “ 1
zi | arm zero angle thrust direction | P R
| | 3 , ∥¨∥ “ 1
si | motor spin direction | P t´1, 1u
µ | motor thrust constant | P R,rN{1s
τ | motor torque constant | P R,rNm{1s

Intermediaries:
ni | arm thrust direction | P R
| | 3 , ∥¨∥ “ 1
fi | arm force | P R
| | 3 ,rNs
mi | arm torque | P R
| | 3 ,rNms

TABLE II: Variable names and descriptions

For this particular implementation the objective function O is chosen as the sum of throttle values squared with a weight wu and the arm angle velocities squared with a weight wa, aiming to minimize both. A penalty weight wp is used to push the throttles towards a range upl to uph, with the goal of keeping them within achievable limits without the added

2

(3)

The constraint G is defined as the difference between the desired body force/torque F, M and the sum of force/torques

follows that G “ 0 and the constraint is satisfied. Note that in the following equations quaternions are multiplied with vectors and the result is defined to be the rotated vector.

ni “

„
sinpai{2q
xi cospai{2q

ȷ

PH

zi | (4)
fi “ µuini | (5)
mi “ µuipri ˆ niq ` τuisini | (6)

G “

„ ř6
i“1

pfiq ´ q

´1F
ř6
i“1

pmiq ´ q

´1M

ȷ
(7)

Now that the optimization problem is fully defined, a few characteristics can be noted:
‚ The problem is nonlinear due to the trigonometric functions in the constraint G, suggesting an iterative solving approach.
‚ The objective O is a convex function, meaning there is no risk of converging to a maximum instead of a minimum. ‚ The constraint G is not convex, meaning a solver could converge to a suboptimal solution that e.g. asks an arm to rotate more than half a turn. Sensibly limiting the stepsize is in practice enough to avoid this problem.
The method chosen to calculate an iterative improvement on u, a is sequential quadratic programming (SQP) [6]. In an effort to make the resulting equation more understandable, it is derived by applying Newton’s method to the optimality conditions, instead of directly trough the quadratic programming subproblem. These optimality conditions are the here relevant parts of the Karush-Kuhn-Tucker (KKT) conditions, namely: ‚ Primal Feasibility: G “ 0, stating that the constraint must be satisfied at the solution.
‚ Stationarity: ∇O `∇GT λ “ 0, stating that the gradient of the objective must be a linear combination of the gradients of every constraint at the solution. This ensures that there is no direction that is orthogonal to every constraint gradient and at the same time is not orthogonal to the objective gradient, which would allow the objective to be lowered while maintaining constraint satisfaction.

These two equations are packed into one and the derivatives split into parts with respect to u and a.
»
–

Ou ` Gu

T λ
Oa ` Ga

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
“ 0 | (8)

This equation is then solved iteratively with Newton’s method, by taking the linear approximation at the current best guess pu, a, λq to find an improvement step pδu, δa, δλq which solves the approximated equation.

H “

»
–

Ouu ` Guu : λ Oua ` Gua : λ Gu

T
Oau ` Gau : λ Oaa ` Gaa : λ Ga

T
Gu | Ga | 0

fi
fl (9)

p pG‹‚ : λqij “ pB²G{B ‹i B ‚j q

T λ q

K “

»
–

Ou ` Gu

T λ
Oa ` Ga

T λ
G

fi
fl | (10)

ë

»
–

δu
δa
δλ

fi
fl “ H´1K | (11)

Usually at this point a line-search method is required to determine how much of the step should be taken, as to not leave the region where the linear approximation is accurate. In this use-case it’s found to be sufficient to simply scale the step by α P p0, 1q such that no single angle nor throttle step exceeds a fixed limit.

α “ minp1.0,

δalim
maxpδaq

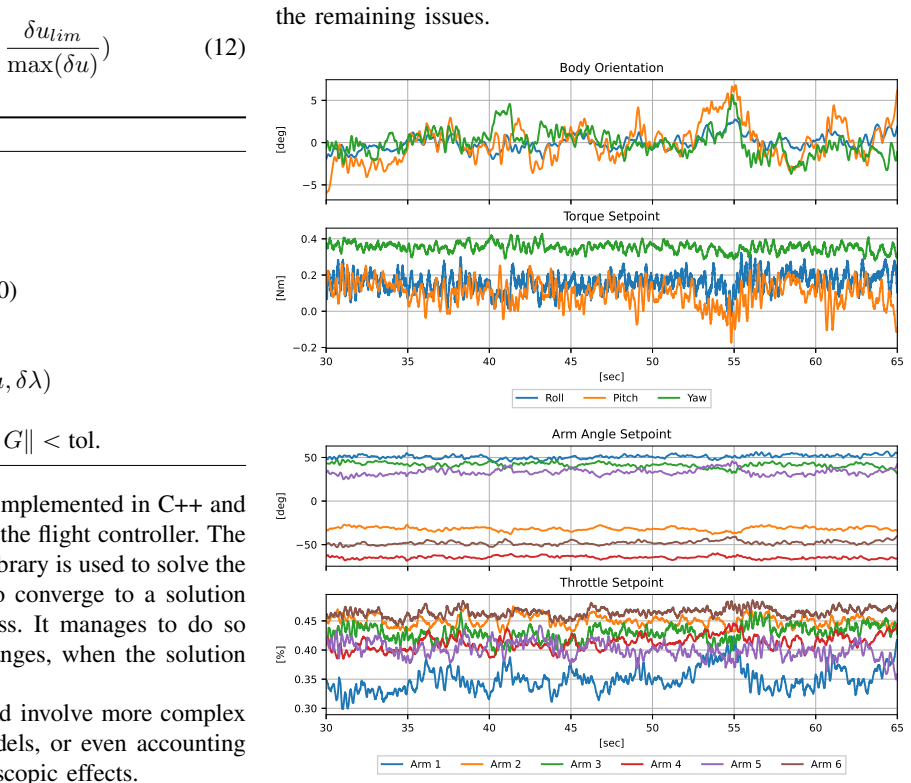
[picture p9: figure]
δulim maxpδuq; the remaining issues.

,

Algorithm 1 SQP algorithm
Input: q, F, M
Output: u, a, λ
u, a, λ Ð result from previous run repeat
H, K Ð calculate with (9), (10) pδu, δa, δλq Ð solve H´1K
α Ð calculate with (12)
pu, a, λq Ð pu, a, λq ` αpδu, δa, δλq
O, G Ð calculate with (3), (7)
until |O ´ Oprev| { O ă tol. and ∥G∥ ă tol.

In practice, the entire algorithm is implemented in C++ and run on a Raspberry Pi 4B, serving as the flight controller. The PartialPivLU solver from the Eigen library is used to solve the linear system. This setup manages to converge to a solution reliably within 5 ms (200 Hz) or less. It manages to do so even during very fast orientation changes, when the solution is furthest from the initial guess.
Proposed future developments could involve more complex objective terms, nonlinear motor models, or even accounting for arm & motor dynamics and gyroscopic effects.
V. TESTFLIGHTS
The three approaches presented in this paper are all tested together in a purpose built drone. The goal of the testflights is neither to quantify the effects of these approaches, nor to compare them to other existing solutions. Instead, the flights are simply used to show that these approaches can in principle produce a drone capable of stable flight. There are a few reasons for this very conservative objective. All are related to the inability of the author to continue working on this project. ‚ For safety reasons a tether is needed on the drone. It’s current implementation greatly limits the achievable orientations, as it would intersect the propellers. For this reason only level flight is tested.
‚ No high-level translation control is implemented, as the drone does not have any means to measure its position. Instead, translation is controlled manually with a RC radio transmitter acting directly on the force setpoint. This causes large drifts in position of 1-2 m.
‚ A simple PD controller is implemented for high-level orientation control, which uses the current/desired orientation to calculate a torque setpoint. A PID controller or other more sophisticated control methods could prove beneficial.
‚ A limited amount of effort is put into the tuning and identification of all the various parameters in the low and high-level controllers.
The results of a hover test (Fig. 8) show acceptable orientation tracking and stable flight. Concluding, the author hopes to soon be able to resume work on this project and to solve

Fig. 8: Results of a hover test flight

REFERENCES

[1] Brett | Beauregard. | Introducing | proportional | on
measurement. | http://brettbeauregard.com/blog/2017/
06/introducing-proportional-on-measurement/, (http://brettbeauregard.com/blog/2017/06/introducing-proportional-on-measurement/) 2017.
[2] Karen Bodie, Maximilian Brunner, Michael Pantic, Stefan Walser, Patrick Pfandler, Ueli Angst, Roland Siegwart, and ¨ Juan Nieto. Active interaction force control for contactbased inspection with a fully actuated aerial vehicle. IEEE Transactions on Robotics, 37(3):709–722, 2021. doi: 10. 1109/TRO.2020.3036623.
[3] Fabio Ruggiero, Vincenzo Lippiello, and Anibal Ollero. Aerial manipulation: A literature review. IEEE Robotics and Automation Letters, 3(3):1957–1964, 2018. doi: 10. 1109/LRA.2018.2808541.
[4] Marco Tognon, Hermes A. Tello Chavez, Enrico Gas- ´ parin, Quentin Sable, Davide Bicego, Anthony Mallet, ´ Marc Lany, Gilles Santi, Bernard Revaz, Juan Cortes, and ´ Antonio Franchi. A truly-redundant aerial manipulator system with application to push-and-slide inspection in industrial plants. IEEE Robotics and Automation Letters, 4(2):1846–1851, 2019. doi: 10.1109/LRA.2019.2895880.
[5] Miguel Angel Trujillo, Jose Ramiro Mart ´ | ´ınez-de Dios,
Carlos Mart´ın, Antidio Viguria, and An´ıbal Ollero. Novel aerial manipulator for accurate and robust industrial ndt contact inspection: A new tool for the oil and gas inspection industry. Sensors, 19(6), 2019. ISSN 1424-8220. doi: 10.3390/s19061305.
[6] Stephen Wright, Jorge Nocedal, et al. Numerical optimization. Springer Science, 35(67-68):7, 1999.
[7] DING Xilun, GUO Pin, XU Kun, and YU Yushu. A review of aerial manipulation of small-scale rotorcraft unmanned robotic systems. Chinese Journal of Aeronautics, 32(1):200–214, 2019.

APPENDIX

A. Drone Components

Core:
CPU | Raspberry Pi 4B
IMU | XSens MTi-3
Battery | 2x Swaytronic 6S 2800mAh

Arm Assembly:
Servo | KST MS325
MCU | Microchip ATSAMD21
H-Bridge | TI DRV8870
Brushes | RS550 DC Motor Brushes

Propulsion:
Motor | T-Motor F100
ESC | T-Motor MINI F45A 6S 4In1
Propeller | DJI Mavic Pro 8331 (3-blade-mod)

Structural:
Sheets | Swiss-Composite 1.5mm CFRP Sheet
Arm Tubes | Swiss-Composite 8x10mm CFRP Tube
3D Parts | Dutch Filament PET-G with Carbon
B. Drone Characteristics
Weight (with battery) | 2.35 kg
Weight (without battery) | 1.55 kg
Diagonal (with propellers) | 590 mm
Diagonal (without propellers) | 412 mm
Thrust (abs. max. up) | 8.21 kg
Flight Time (hover) | 14 min
C. Derivatives Required in SQP

BO
Bui

“ 2wuui ` 2wpppui ´ uplquiăupl ` pui ´ uphquiąuph q

B

2O
BuiBuj

B

2O
BuiBuj

B

2O
BuiBuj

“

i “ j : 2wu ` p2wpquiăupl ` p2wpquiąuph i ‰ j : 0

BO
Bai

“

2wa
∆t

pai ´ ai,prevq

B

| 2O
BaiBaj

B

| 2O
BaiBaj

B

| 2O
BaiBaj
| “
| i “ j :

2wa
∆t
| i ‰ j : 0
B

2O
BuiBaj

B

2O
BuiBaj

B

2O
BuiBaj

“

B

2O
BajBui

B

2O
BajBui

B

2O
BajBui

“ 0

BG
Bui

“

„
Bfi{Bui
Bmi{Bui

ȷ
B

2G
BuiBuj

B

2G
BuiBuj

B

2G
BuiBuj

“

$

’&

’%

i “ j :

«
B

2fi{Bui

2
B

2mi{Bui

2

ff

i ‰ j : 0

BG
Bai

“

„
Bfi{Bai
Bmi{Bai

ȷ
B

2G
BaiBaj

B

2G
BaiBaj

B

2G
BaiBaj

“

$

’&

’%

i “ j :

«
B

2fi{Bai

2
B

2mi{Bai

2

ff

i ‰ j : 0

B

2G
BuiBaj

B

2G
BuiBaj

B

2G
BuiBaj

“

B

2G
BajBui

B

2G
BajBui

B

2G
BajBui

“

$

’&

’%

i “ j :

«
B

2fi{BuiBai
B

2mi{BuiBai

ff

i ‰ j : 0

Bfi
Bui

Bfi
Bui

Bfi
Bui

“ µni

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
“ µui

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
“ µui

B

2ni
Bai

2

B

2fi
BuiBai

B

2fi
BuiBai

B

2fi
BuiBai

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
“ µpri ˆ niq ` τsini

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
“ µuipri ˆ

Bni
Bai

q ` τuisi

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
“ µuipri ˆ

B

2ni
Bai

2

q ` τuisi

B

2ni
Bai

2
B

2mi
BuiBai

B

2mi
BuiBai

B

2mi
BuiBai

“ µpri ˆ

Bni
Bai

q ` τsi

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
“ xi ˆ ni

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
“ xi ˆ pxi ˆ niq
