mruggia/momav/5_test/2_arms/0_old/old_wrench_calib/overview.xlsx

date | type | nr | info
23.05.2022 | static | 001 | static: throttle 10:10:40 -> OK, 0.6 delay too short?
 | gyro | 002 | gyro: throttle 40, rpm 2 -> OK
 | static | 003 | static: throttle 10:20:70 -> ABORT, vibrations
 | static | 004 | static: throttle 50:0:50, delay 1.2s -> FAIL, wrong prop dir mounted
 | static | 005 | redo of 004 -> OK
 | gyro | 006 | gyro: throttle 50, rpm 2 -> OK
 | vicon | 007 | no throttle, move drone to compare imu to vicon -> vicon data did not record..
13.06.2022 | cont | 008 | cont: throttle 30 -> OK
 | cont | 009 | cont: throttle 50 -> OK
 | cont | 010 | cont: throttle 70 -> OK
 | cont | 011 | cont: throttle 30 -> OK
 | cont | 012 | cont: throttle 50 -> OK
 | cont | 013 | cont: throttle 70 -> OK
