mruggia/momav/5_test/2_arms/0_old/old_slipring_test_1/overview_slipring.xlsx

5sec per measurement
1C has copper paste!
id | phase1 | phase2 | current
001 | 1A | 1B | 2
002 | 1B | 1C | 2
003 | 1C | 1A | 2
004 | 1A | 1B | 4
005 | 1B | 1C | 4
006 | 1C | 1A | 4
007 | 1A | 1B | 6
008 | 1B | 1C | 6
009 | 1C | 1A | 6
010 | 1A | 1B | 8
011 | 1B | 1C | 8
012 | 1C | 1A | 8
013 | 1A | 1B | 10
014 | 1B | 1C | 10
015 | 1C | 1A | 10
016 | 1A | 1B | 12
017 | 1B | 1C | 12
018 | 1C | 1A | 12
019 | 1A | 1B | 14
020 | 1B | 1C | 14
021 | 1C | 1A | 14
022 | 1A | 1B | 16 | brush damage on 1B
023 | 1B | 1C | 16
024 | 1C | 1A | 16
025 | 1A | 1B | 18
026 | 1B | 1C | 18
027 | 1C | 1A | 18
028 | 1A | 1B | 20
029 | 1B | 1C | 20
030 | 1C | 1A | 20
031 | 1A | 1B | 22 | smoke brush 1A
032 | 1B | 1C | 22
033 | 1C | 1A | 22 | more smoke 1A, brush broke
034 | 1A | 1B | 24
035 | 1B | 1C | 24
036 | 1C | 1A | 24
