mruggia/momav/2_pcb/servo/info/mcu_info.png

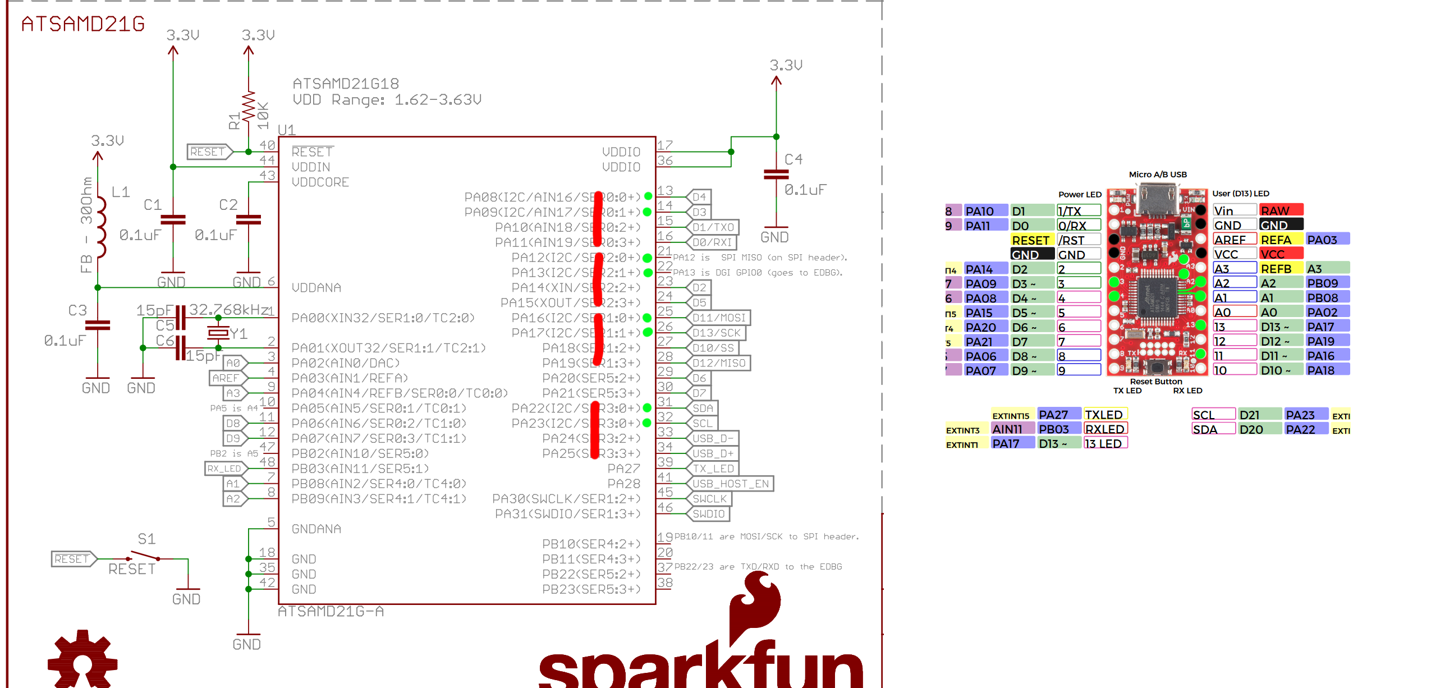
2_pcb/servo/info/mcu_info.png
