mruggia/momav/8_img/fhgr_flight_2022/20220627_114851.jpg

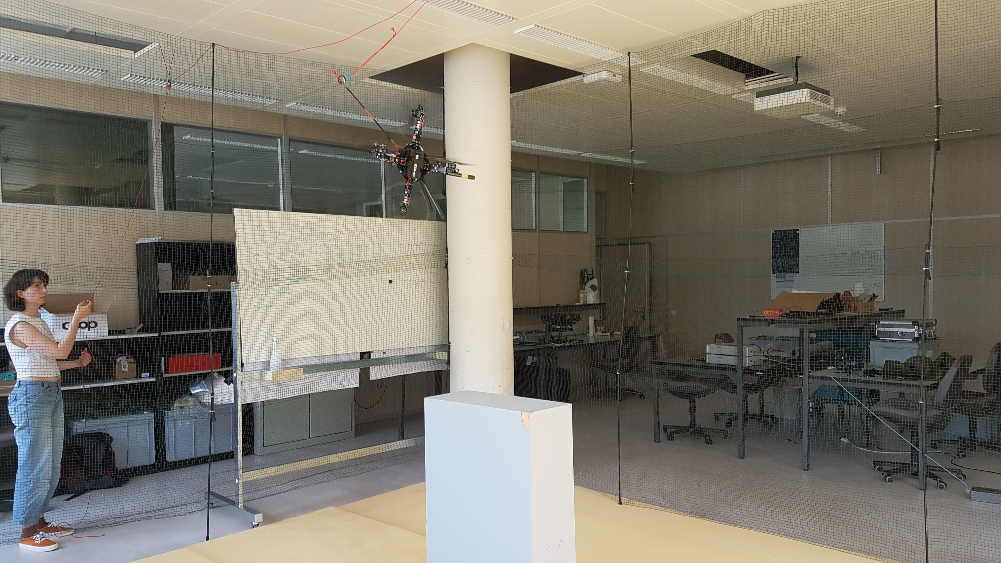
8_img/fhgr_flight_2022/20220627_114851.jpg
