mruggia/momav/8_img/fhgr_flight_2022/20220627_114907.jpg

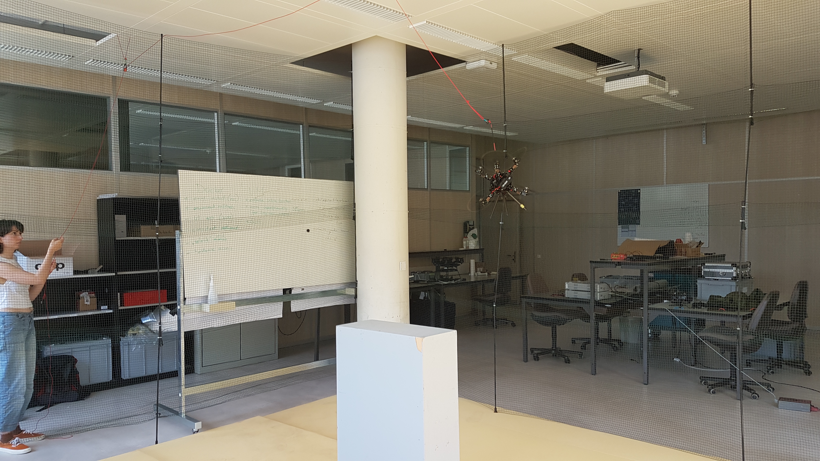
8_img/fhgr_flight_2022/20220627_114907.jpg
