mruggia/momav/8_img/final/1_orig/IMG_20220430_091835.jpg

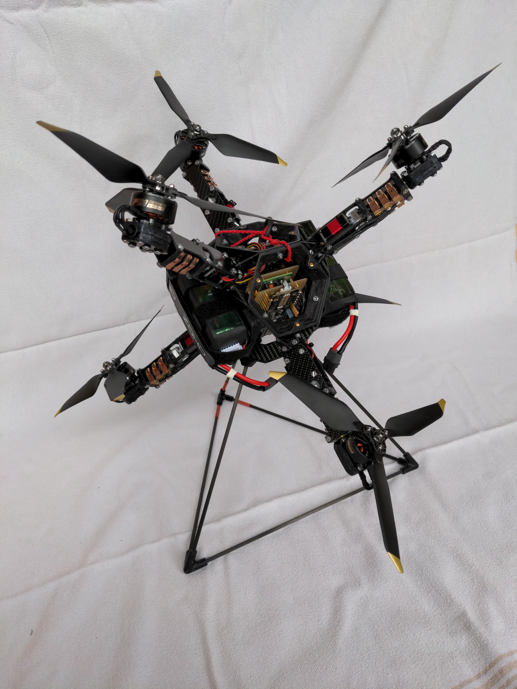
8_img/final/1_orig/IMG_20220430_091835.jpg
