mruggia/momav/8_img/final/IMG_20220430_091742.jpg

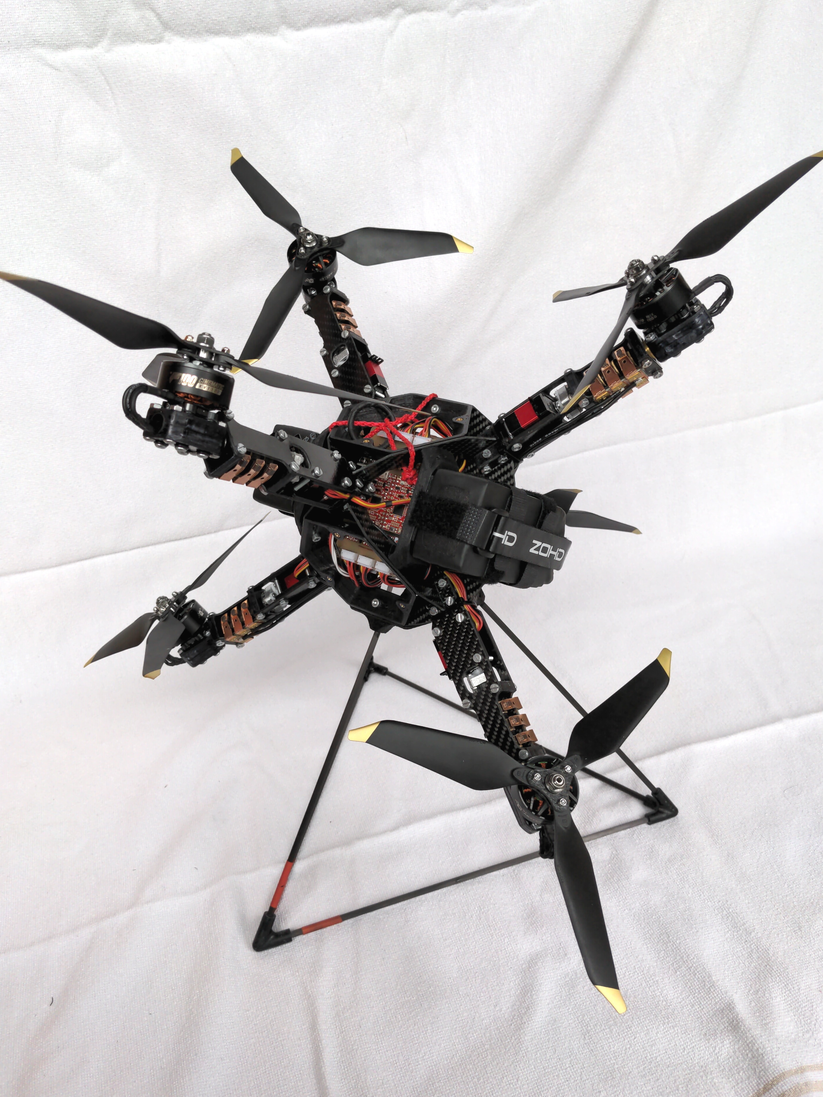
8_img/final/IMG_20220430_091742.jpg
