mruggia/momav/8_img/final/IMG_20220430_092001.jpg

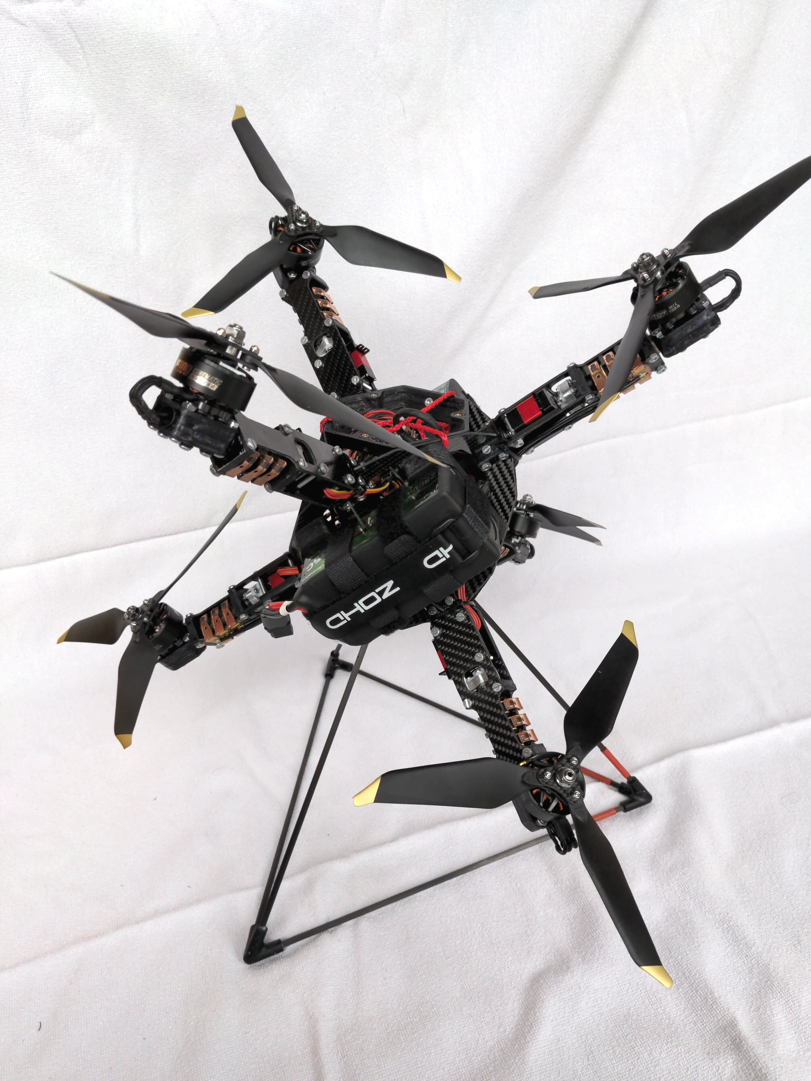
8_img/final/IMG_20220430_092001.jpg
