mruggia/momav/8_img/final/IMG_20220430_092405.jpg

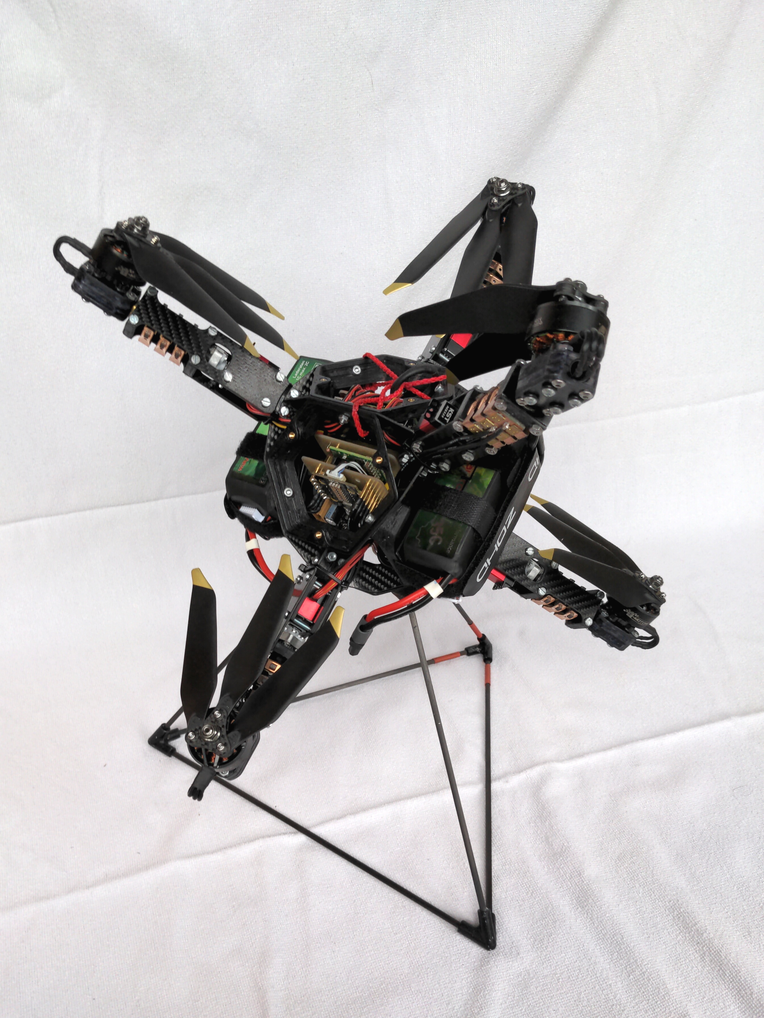
8_img/final/IMG_20220430_092405.jpg
