mruggia/momav/8_img/final/IMG_20220430_092442.jpg

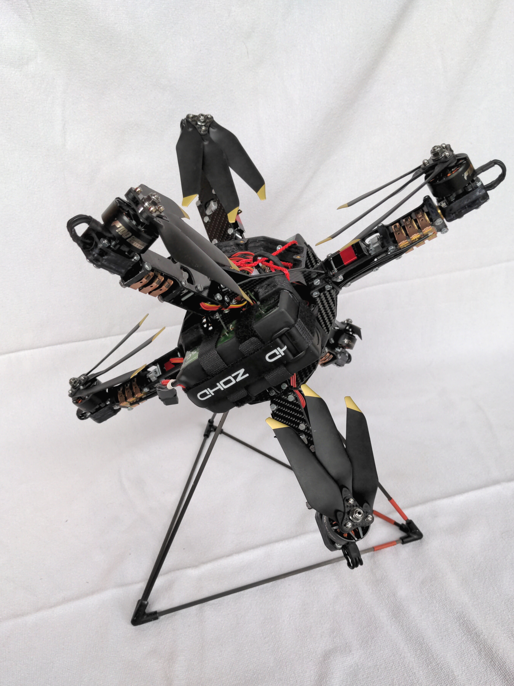
8_img/final/IMG_20220430_092442.jpg
