mruggia/momav/8_img/final/IMG_20220430_092842.jpg

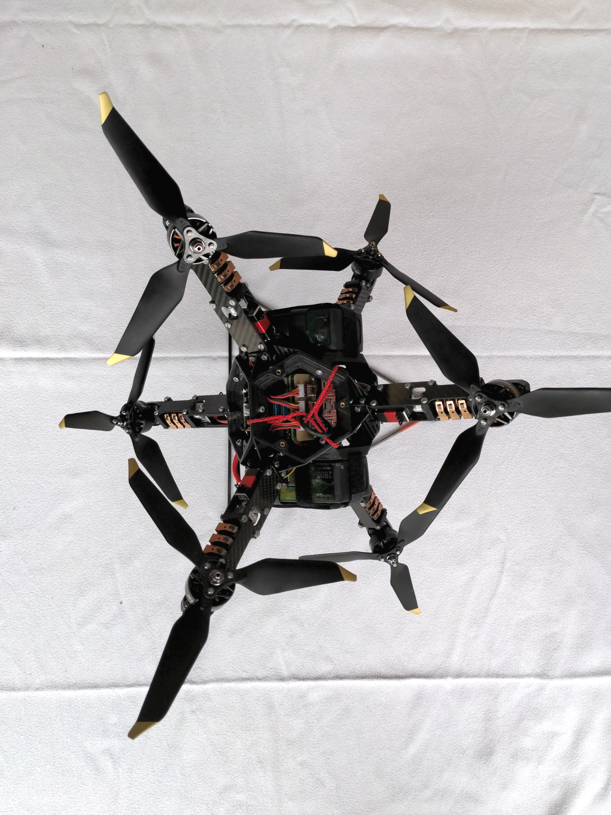
8_img/final/IMG_20220430_092842.jpg
