mruggia/momav/8_img/IMG_20220205_150917.jpg

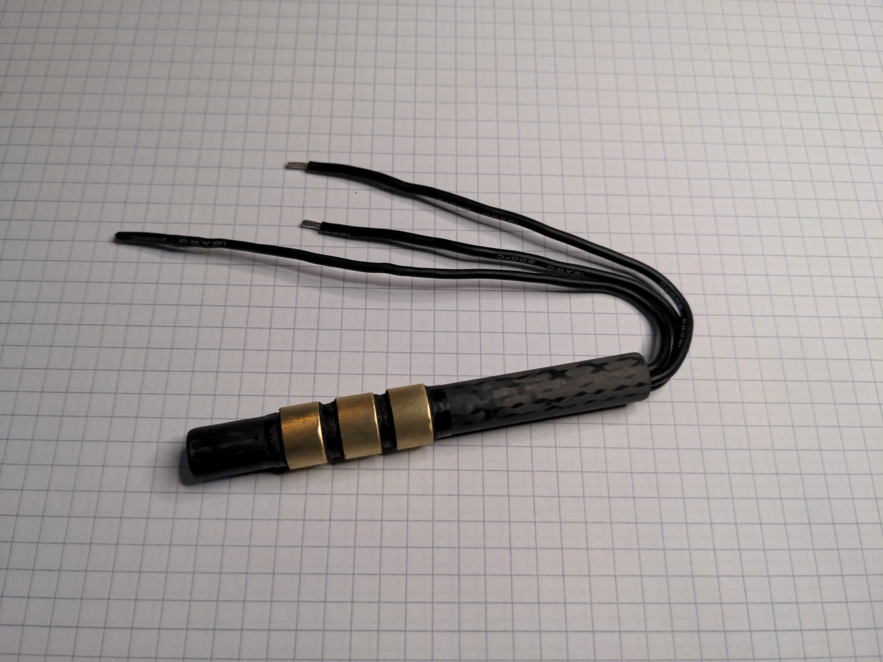
8_img/IMG_20220205_150917.jpg
