mruggia/momav/8_img/IMG_20220205_150944.jpg

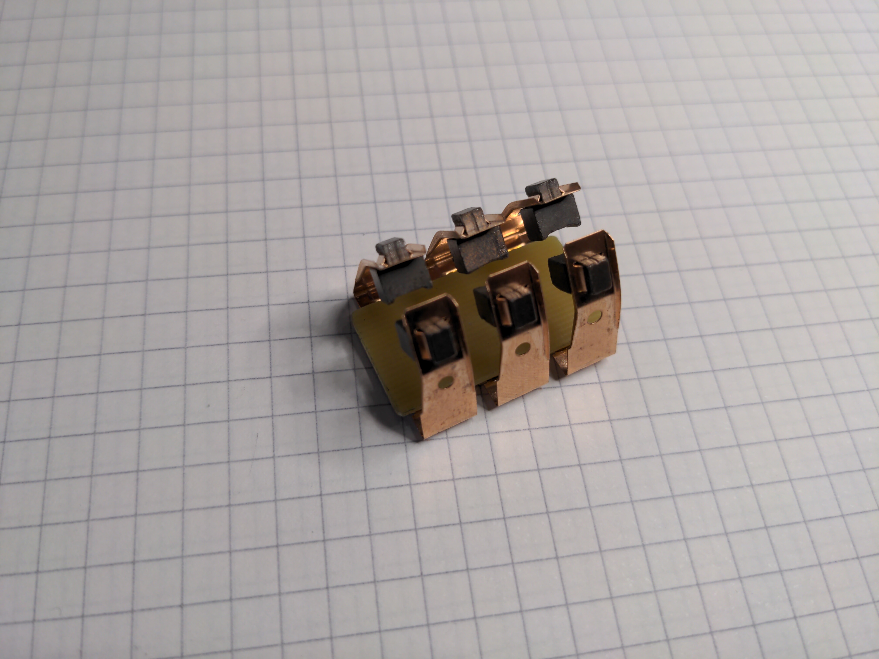
8_img/IMG_20220205_150944.jpg
