mruggia/momav/8_img/IMG_20220205_151724.jpg

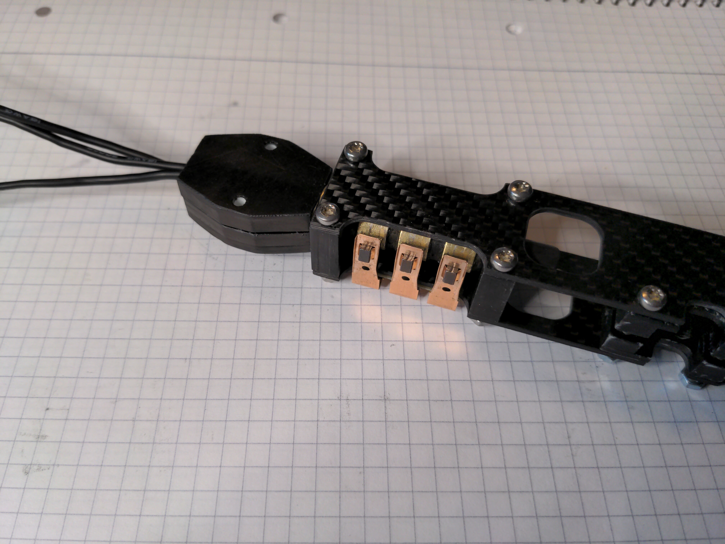
8_img/IMG_20220205_151724.jpg
