mruggia/momav/8_img/IMG_20220207_182706.jpg

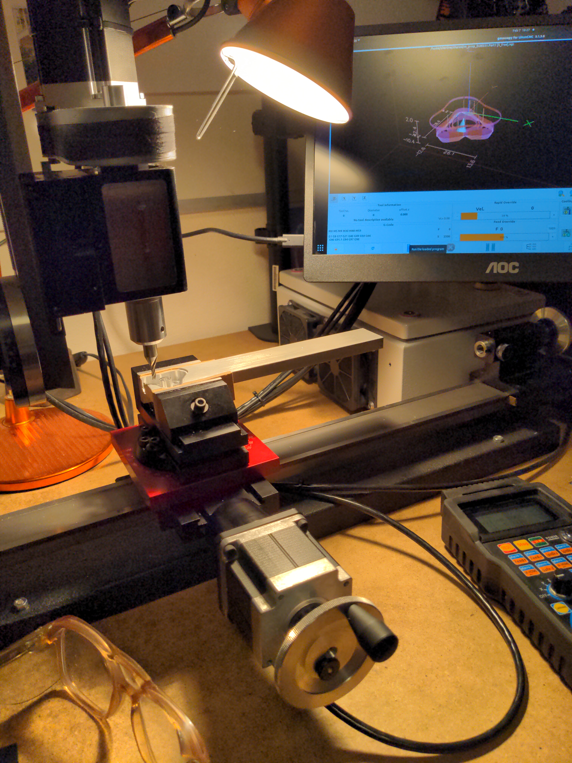
8_img/IMG_20220207_182706.jpg
