mruggia/momav/8_img/IMG_20220207_202255.jpg

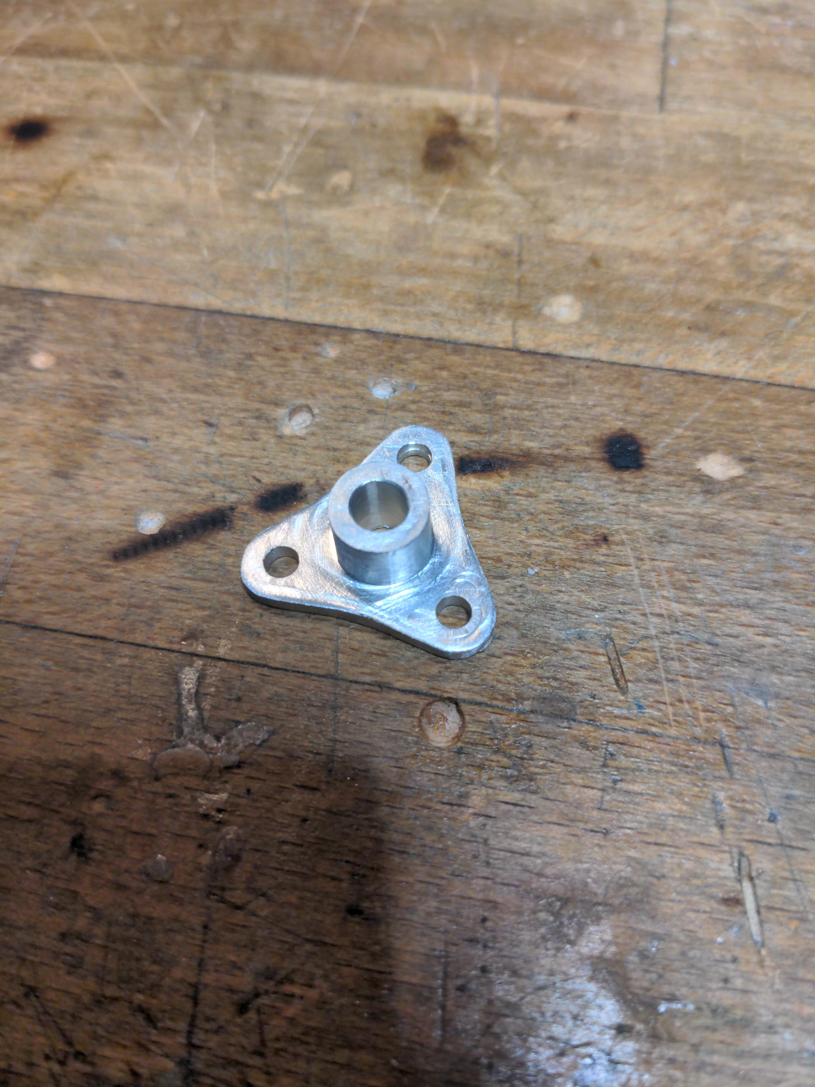
8_img/IMG_20220207_202255.jpg
