mruggia/momav/8_img/IMG_20220210_200233.jpg

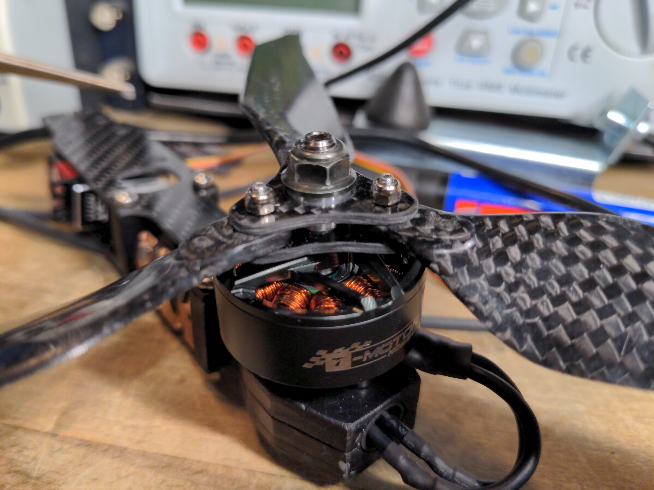
8_img/IMG_20220210_200233.jpg
