mruggia/momav/8_img/IMG_20220222_192517.jpg

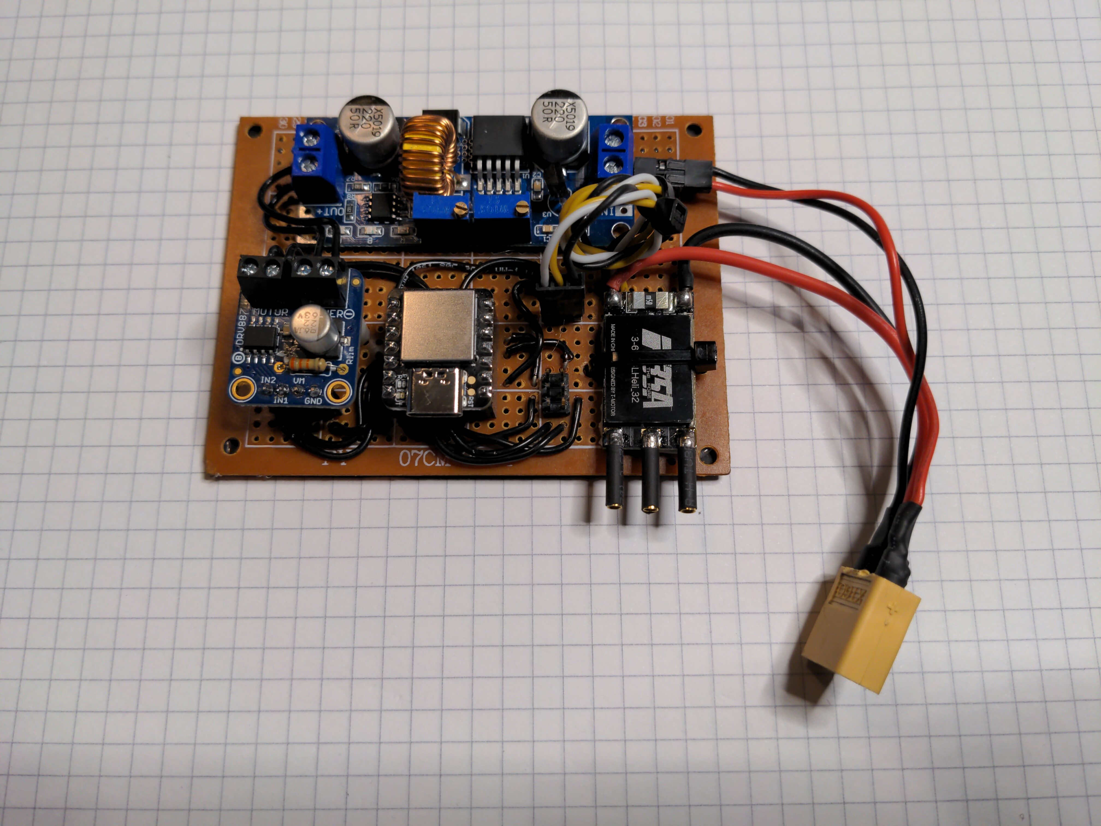
8_img/IMG_20220222_192517.jpg
