mruggia/momav/8_img/IMG_20220303_152858.jpg

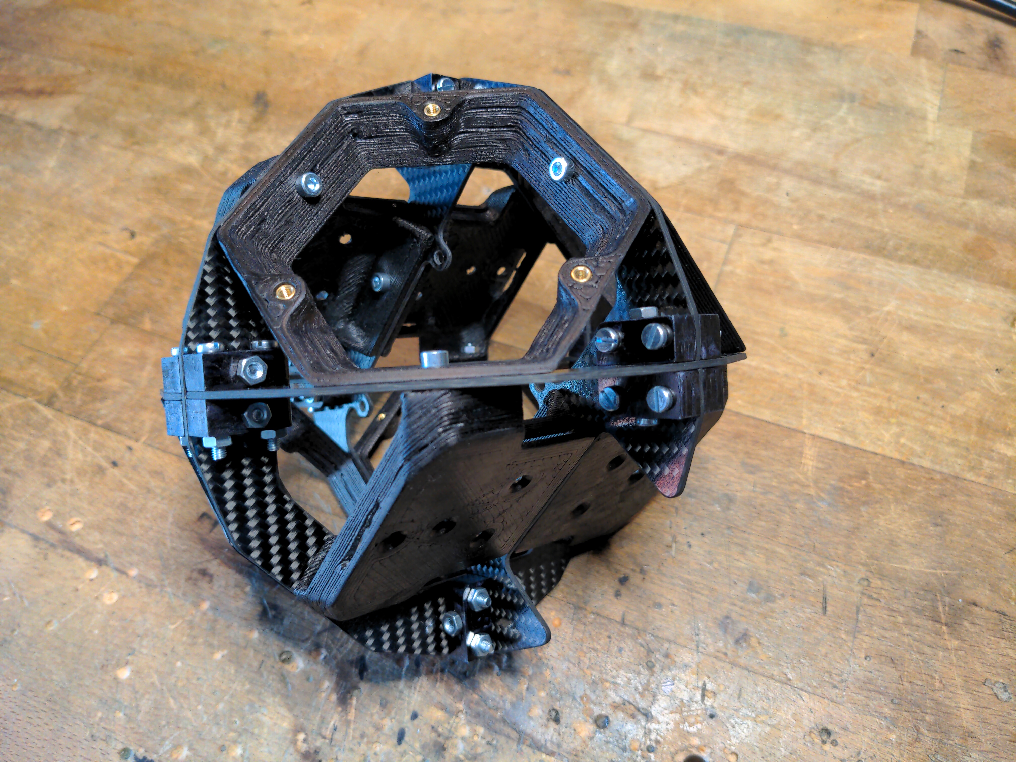
8_img/IMG_20220303_152858.jpg
