mruggia/momav/8_img/IMG_20220316_203056.jpg

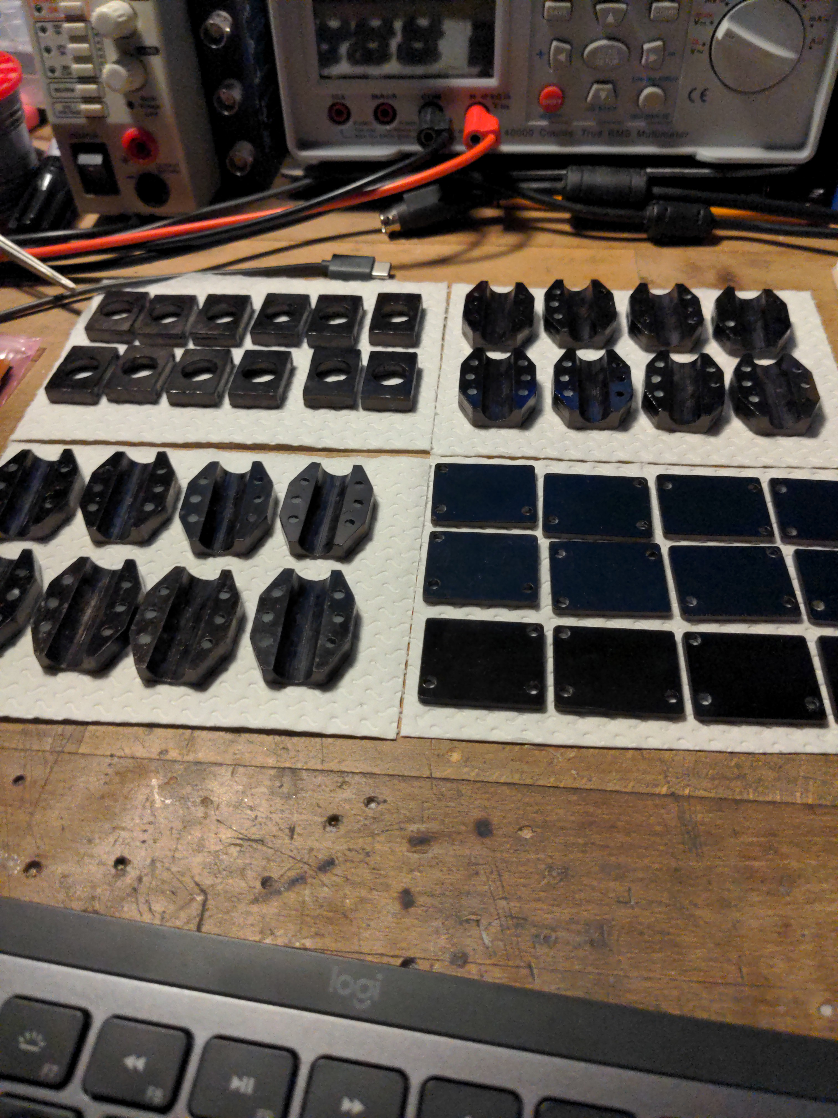
8_img/IMG_20220316_203056.jpg
