mruggia/momav/8_img/IMG_20220322_084927.jpg

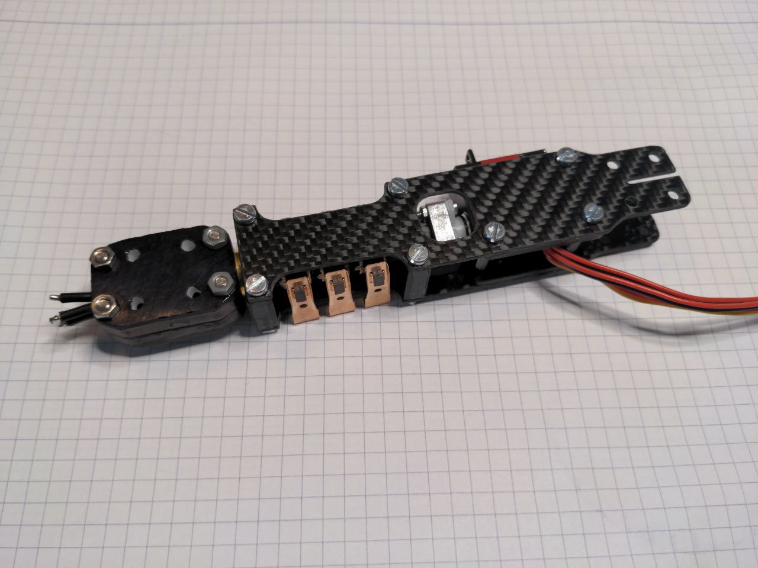
8_img/IMG_20220322_084927.jpg
