mruggia/momav/8_img/IMG_20220325_144005.jpg

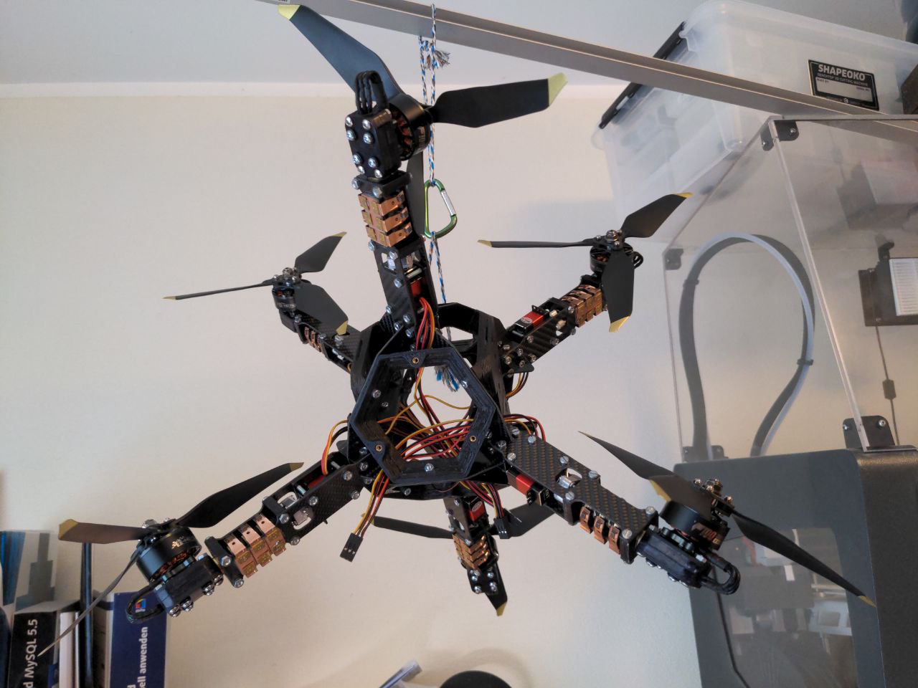
8_img/IMG_20220325_144005.jpg
