mruggia/momav/8_img/IMG_20220326_113754.jpg

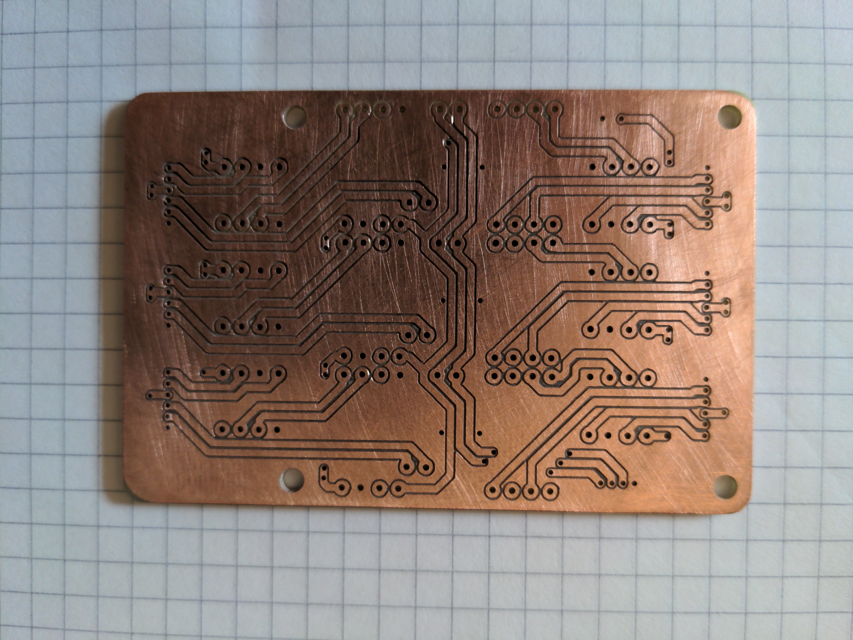
8_img/IMG_20220326_113754.jpg
