mruggia/momav/8_img/IMG_20220406_103548.jpg

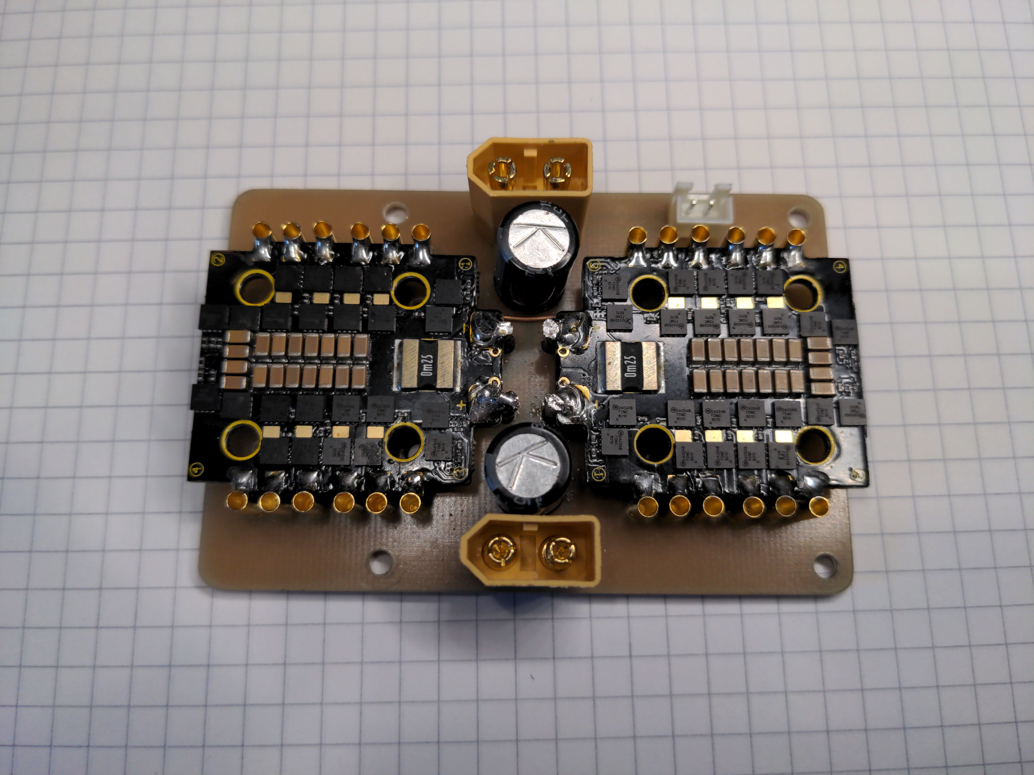
8_img/IMG_20220406_103548.jpg
