mruggia/momav/8_img/IMG_20220406_103754.jpg

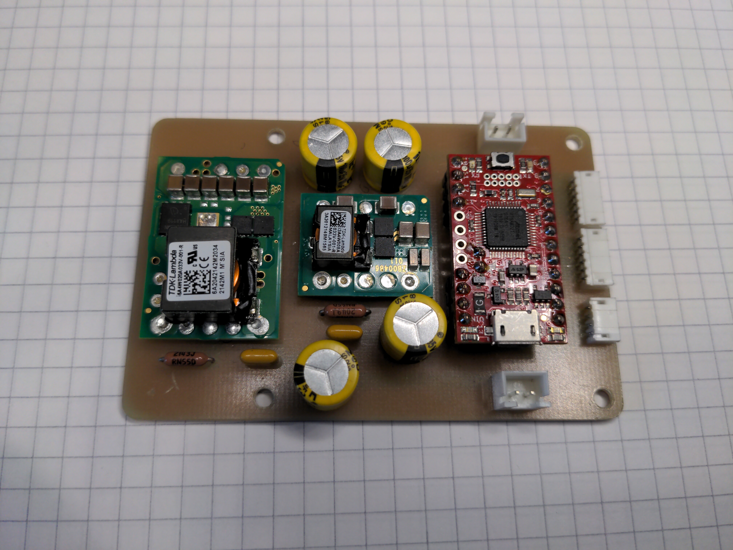
8_img/IMG_20220406_103754.jpg
