mruggia/momav/8_img/IMG_20220407_085721.jpg

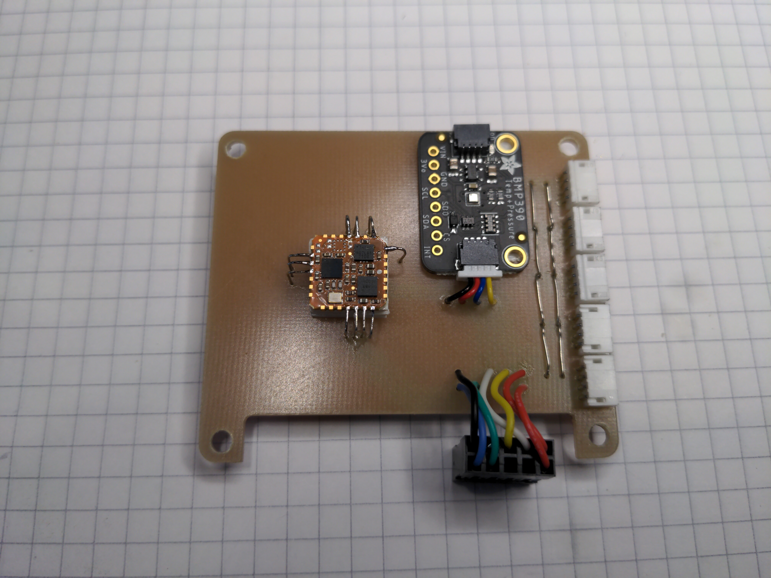
8_img/IMG_20220407_085721.jpg
