mruggia/momav/8_img/IMG_20220408_195018.jpg

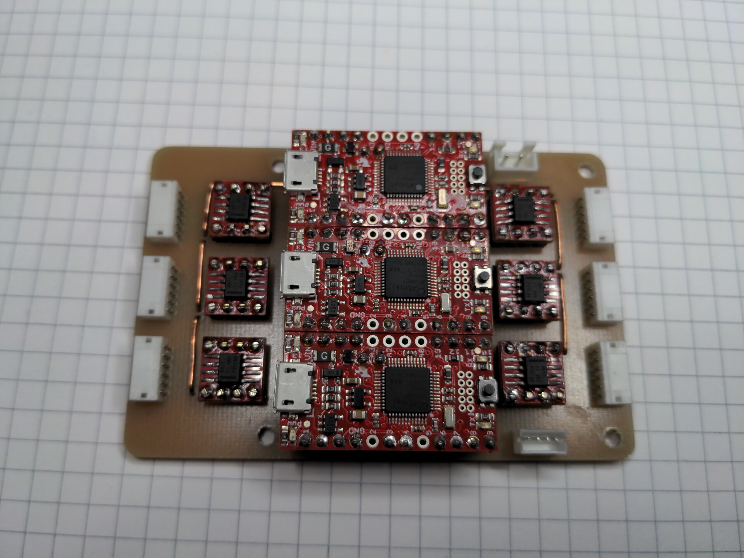
8_img/IMG_20220408_195018.jpg
