mruggia/momav/8_img/IMG_20220430_091656.jpg

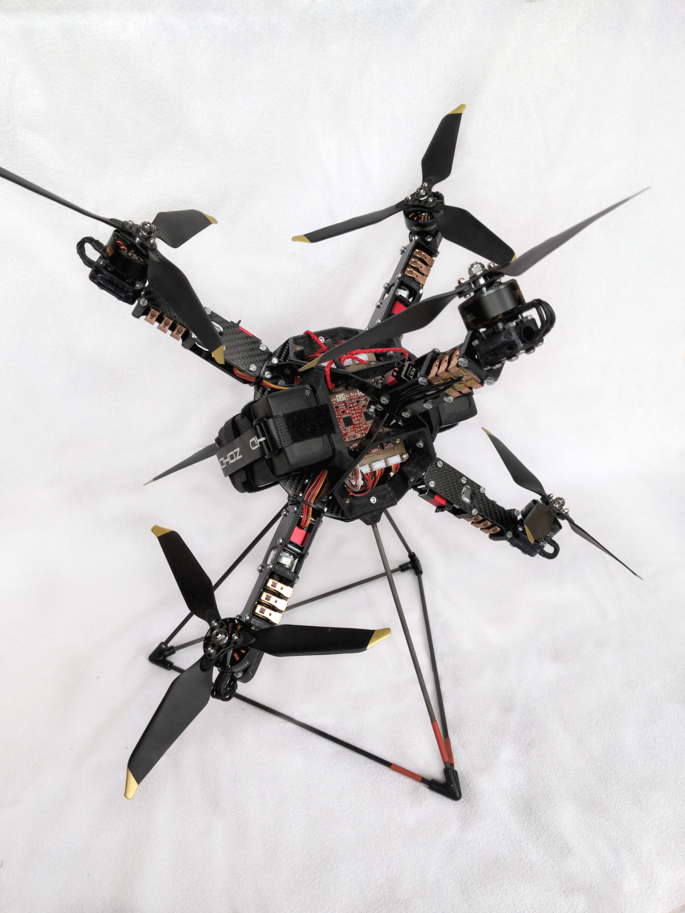
8_img/IMG_20220430_091656.jpg
