mruggia/momav/8_img/IMG_20220513_134838.jpg

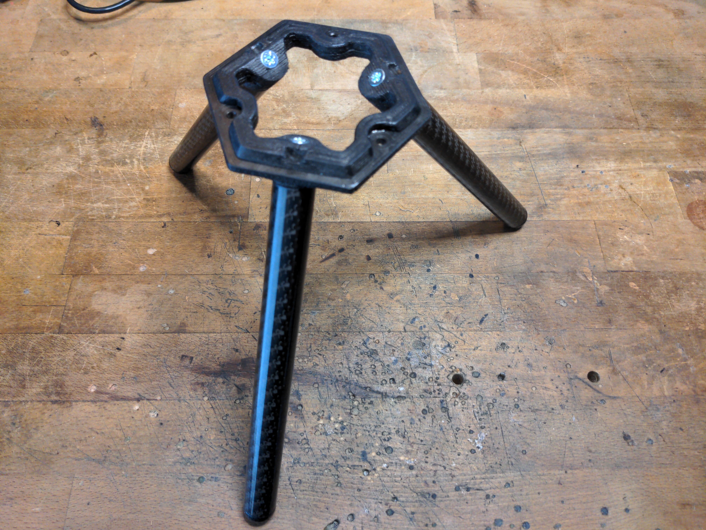
8_img/IMG_20220513_134838.jpg
