mruggia/momav/8_img/IMG_20220518_195141.jpg

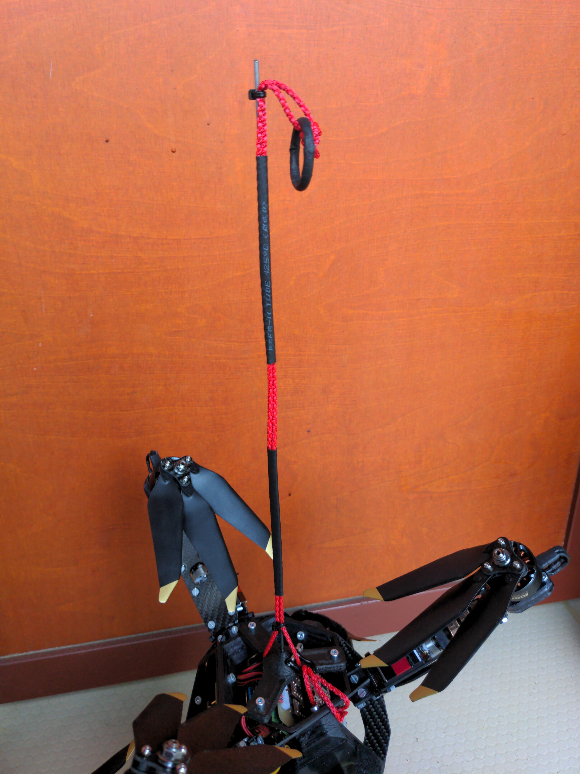
8_img/IMG_20220518_195141.jpg
