mruggia/momav/8_img/IMG_20231022_193420.png

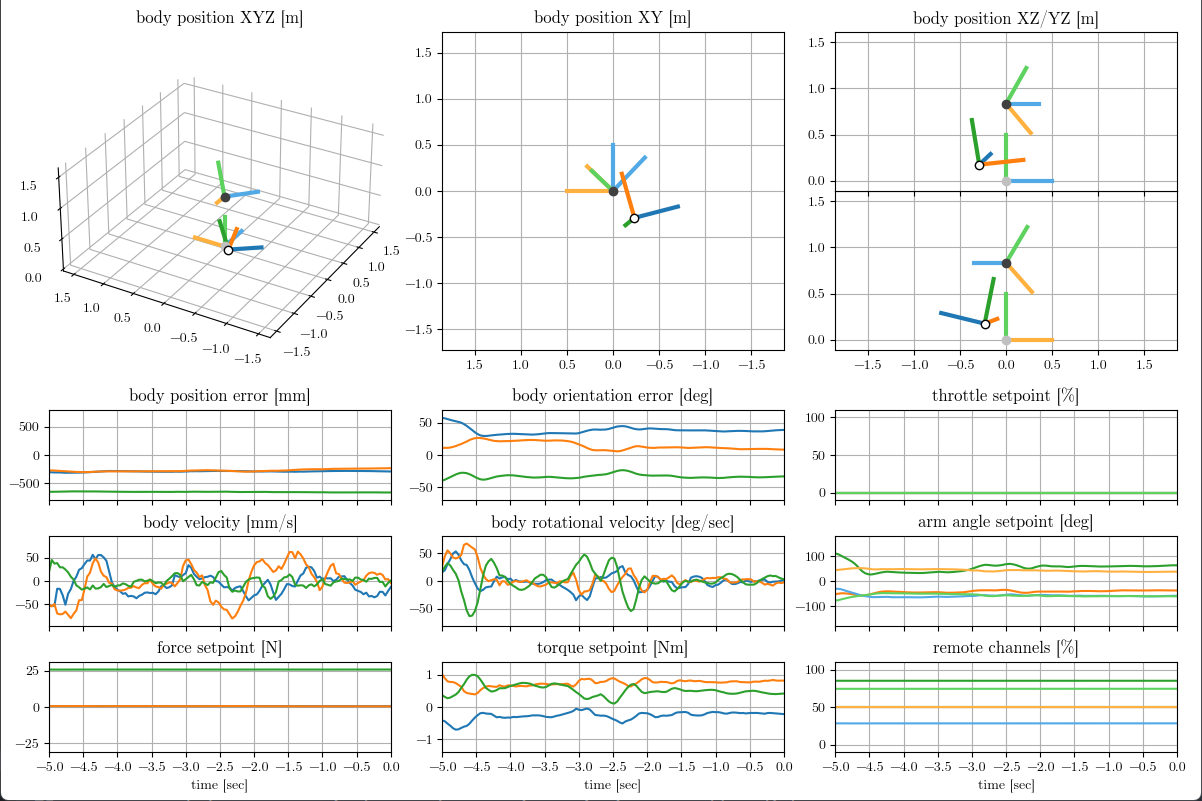
8_img/IMG_20231022_193420.png
