mruggia/momav/8_img/IMG_20231108_191059.jpg

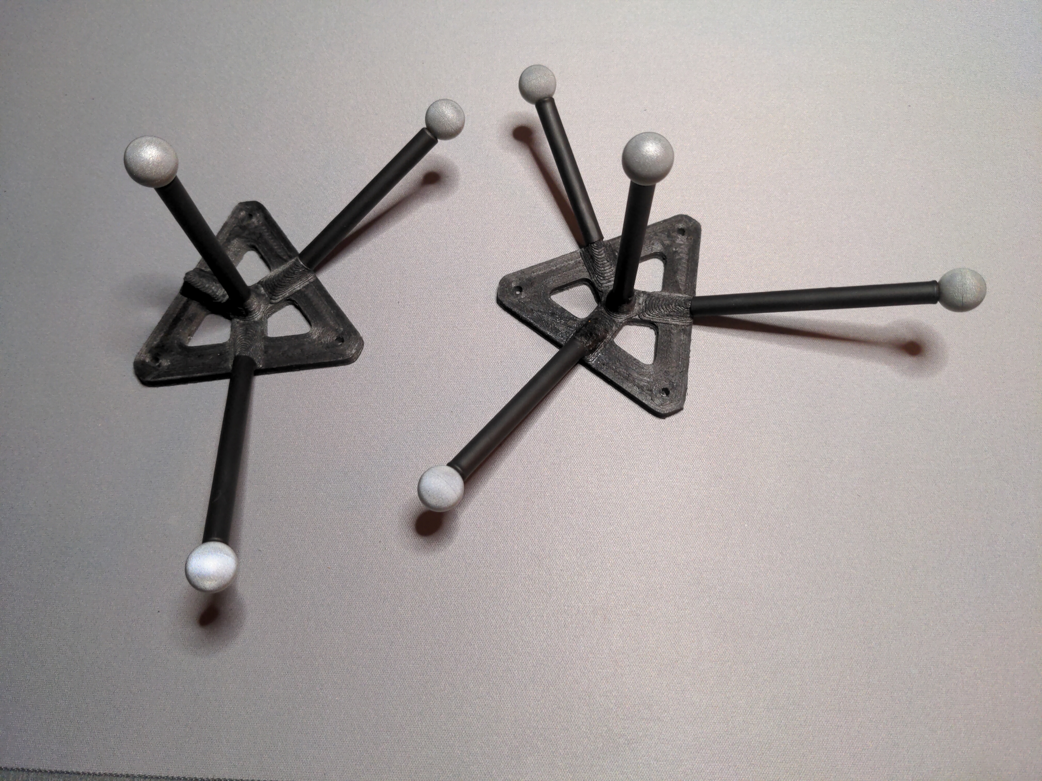
8_img/IMG_20231108_191059.jpg
