mruggia/momav/8_img/IMG_20231127_165242.jpg

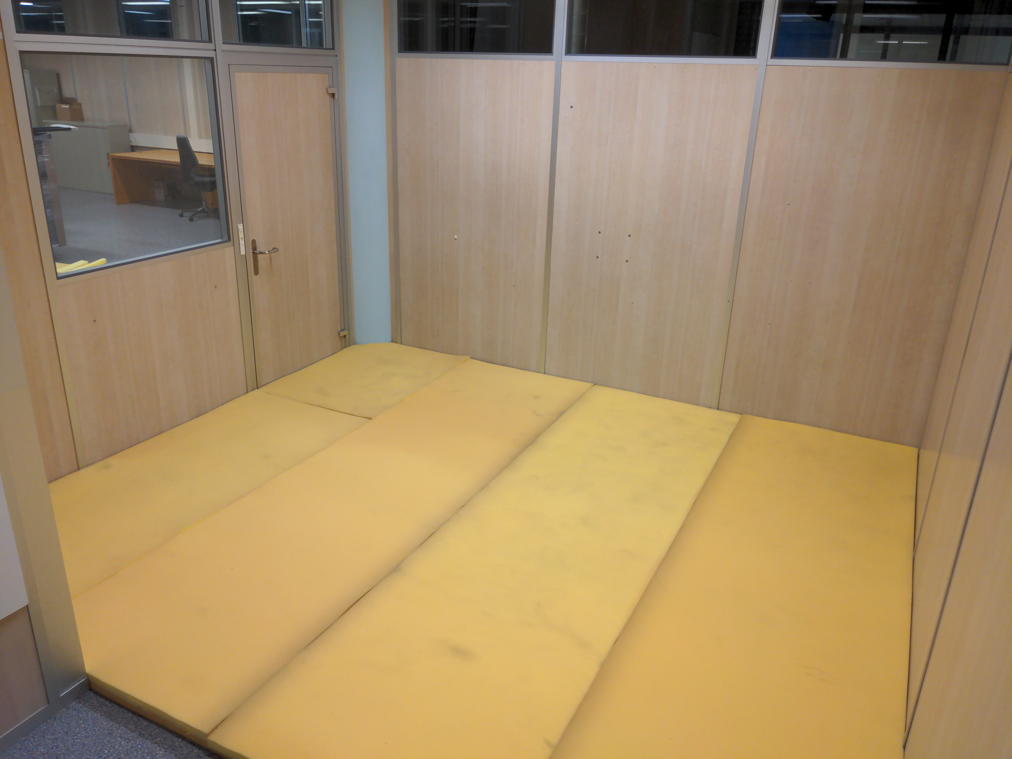
8_img/IMG_20231127_165242.jpg
