mruggia/momav/8_img/IMG_20231221_135843.jpg

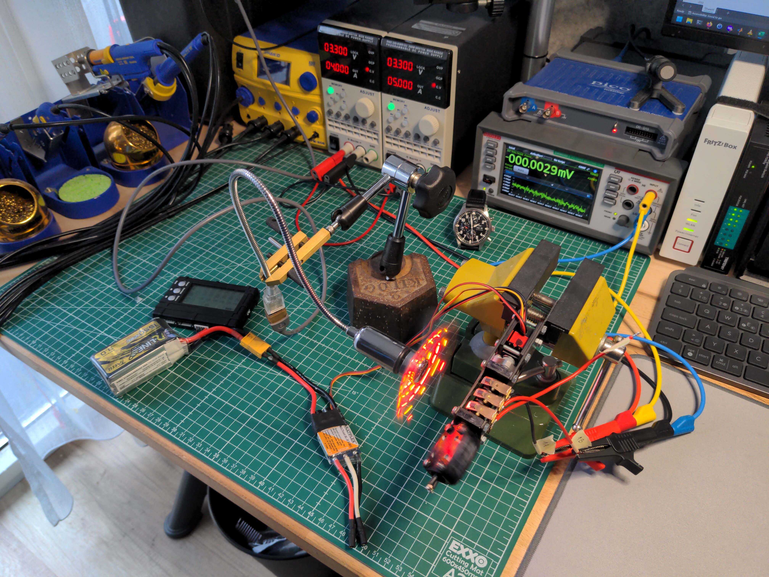
8_img/IMG_20231221_135843.jpg
