mruggia/momav/8_img/IMG_20240408_174038.jpg

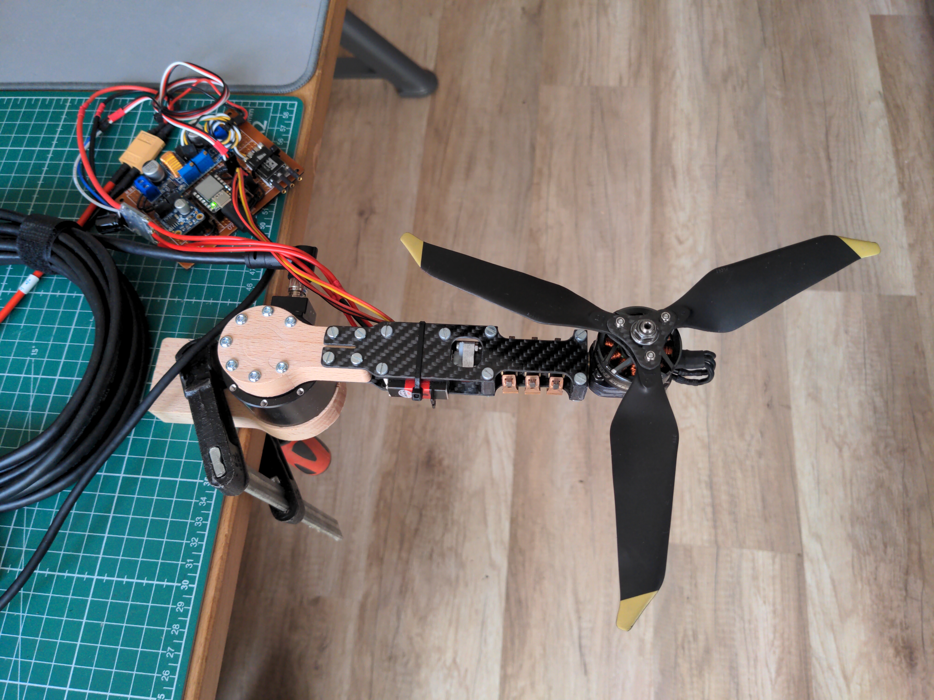
8_img/IMG_20240408_174038.jpg
