mruggia/momav/8_img/IMG_20240409_161037.jpg

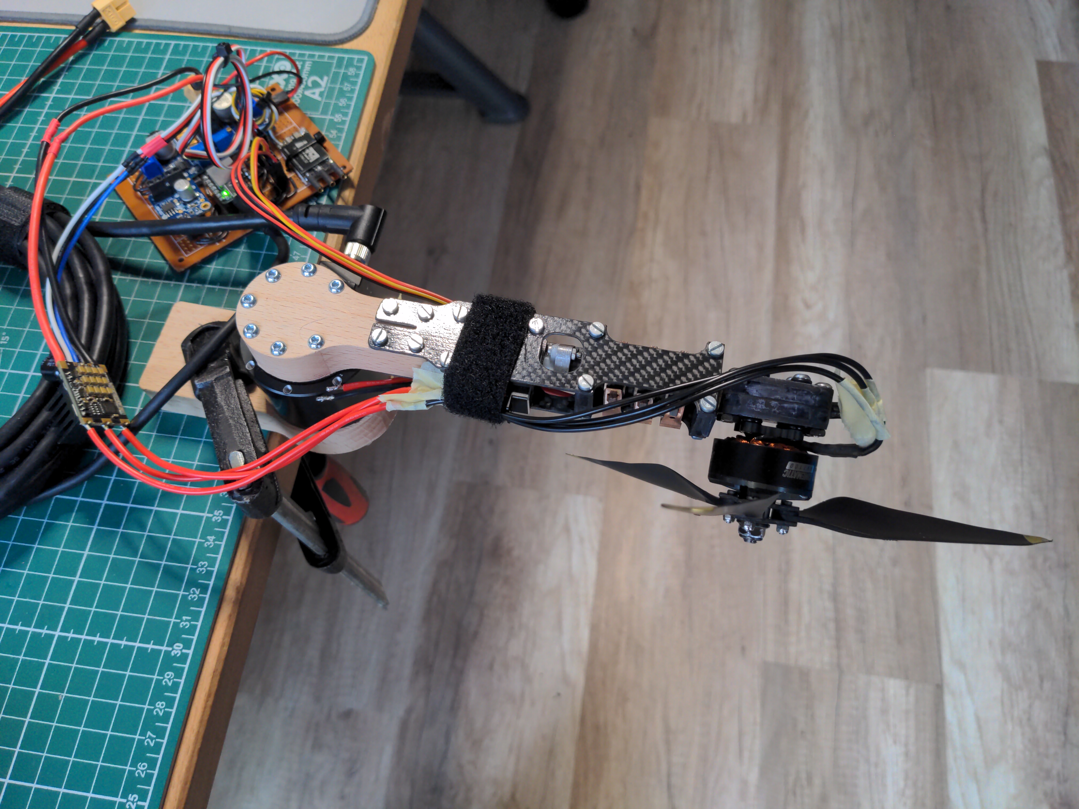
8_img/IMG_20240409_161037.jpg
