mruggia/momav/8_img/IMG_20240409_173726.jpg

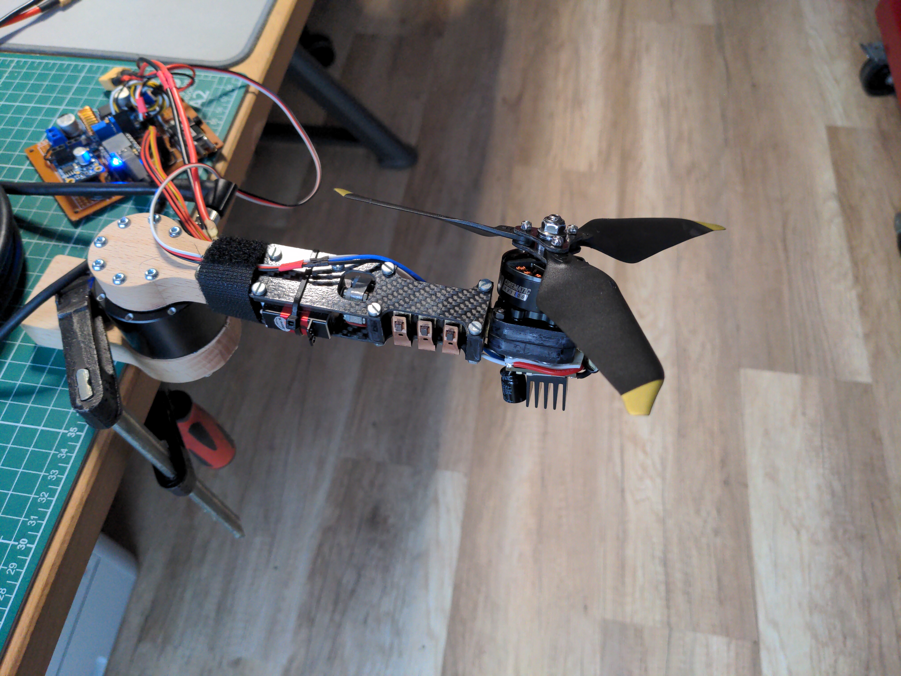
8_img/IMG_20240409_173726.jpg
