mruggia/momav/9_docs/2_hardware/optitrack_13w/optitrack_latency.png

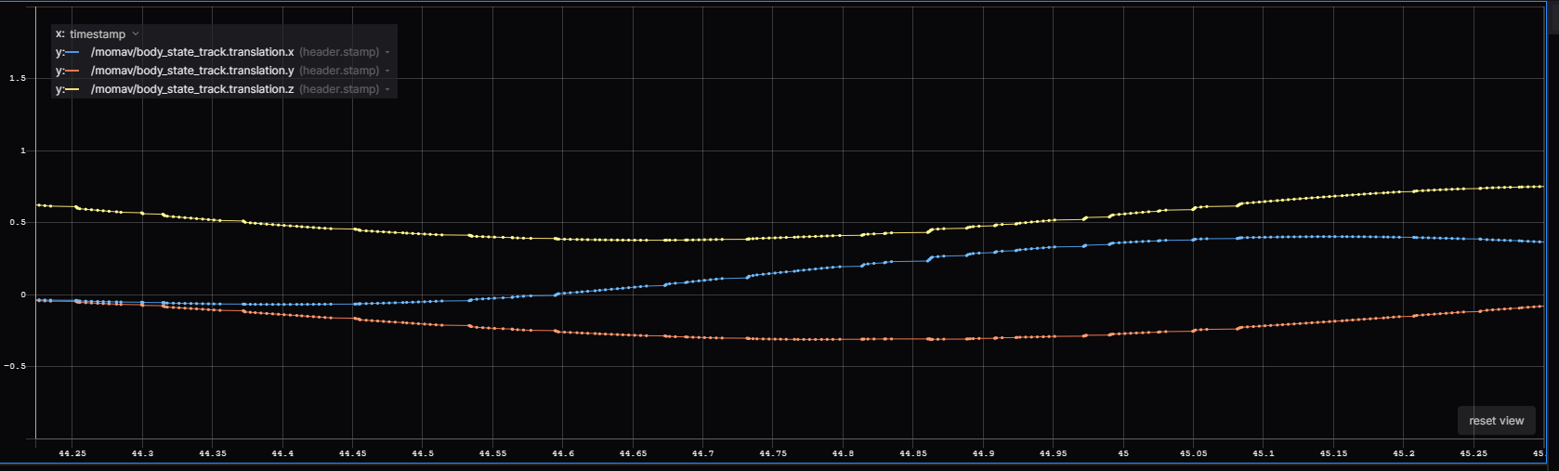
9_docs/2_hardware/optitrack_13w/optitrack_latency.png
