mruggia/momav/9_docs/2_hardware/realsense_t265/t265_jumps.png

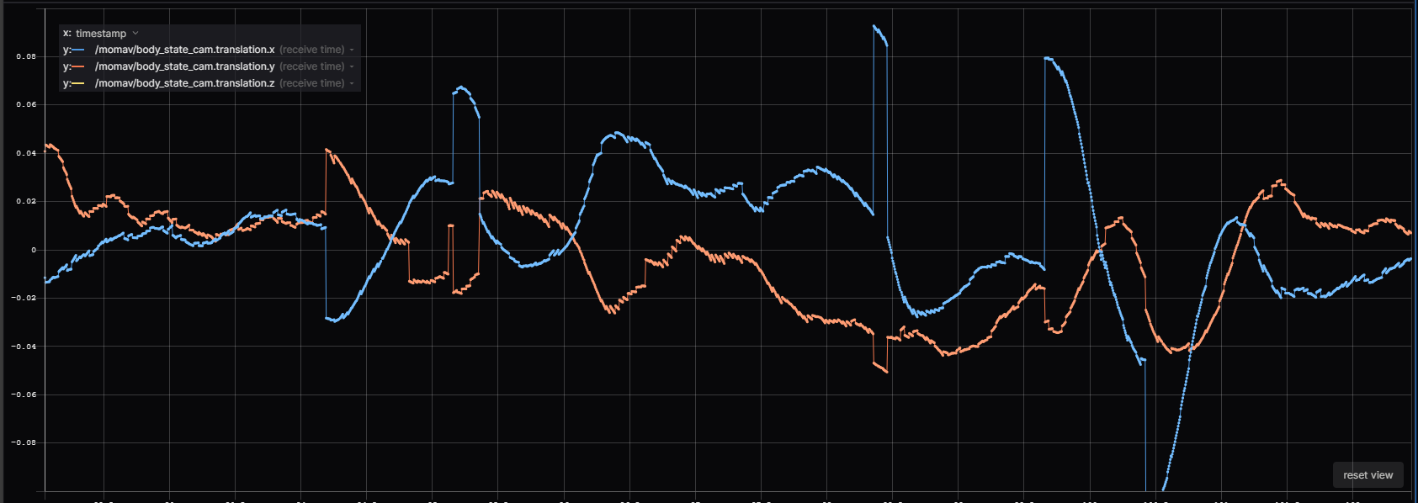
9_docs/2_hardware/realsense_t265/t265_jumps.png
