mruggia/momav/9_docs/2_hardware/xsense_mti3/1.png

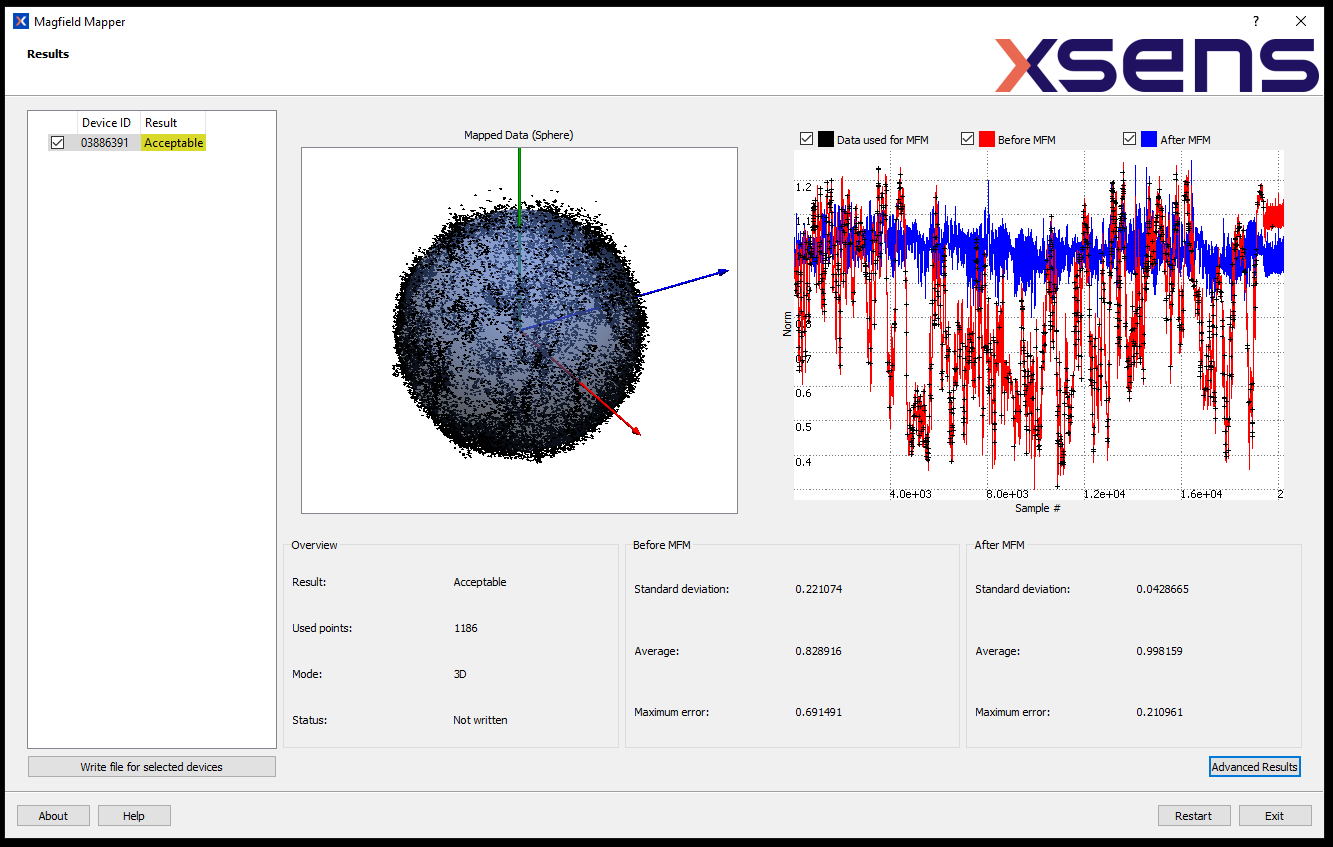
9_docs/2_hardware/xsense_mti3/1.png
