mruggia/momav/9_docs/2_hardware/xsense_mti3/2.png

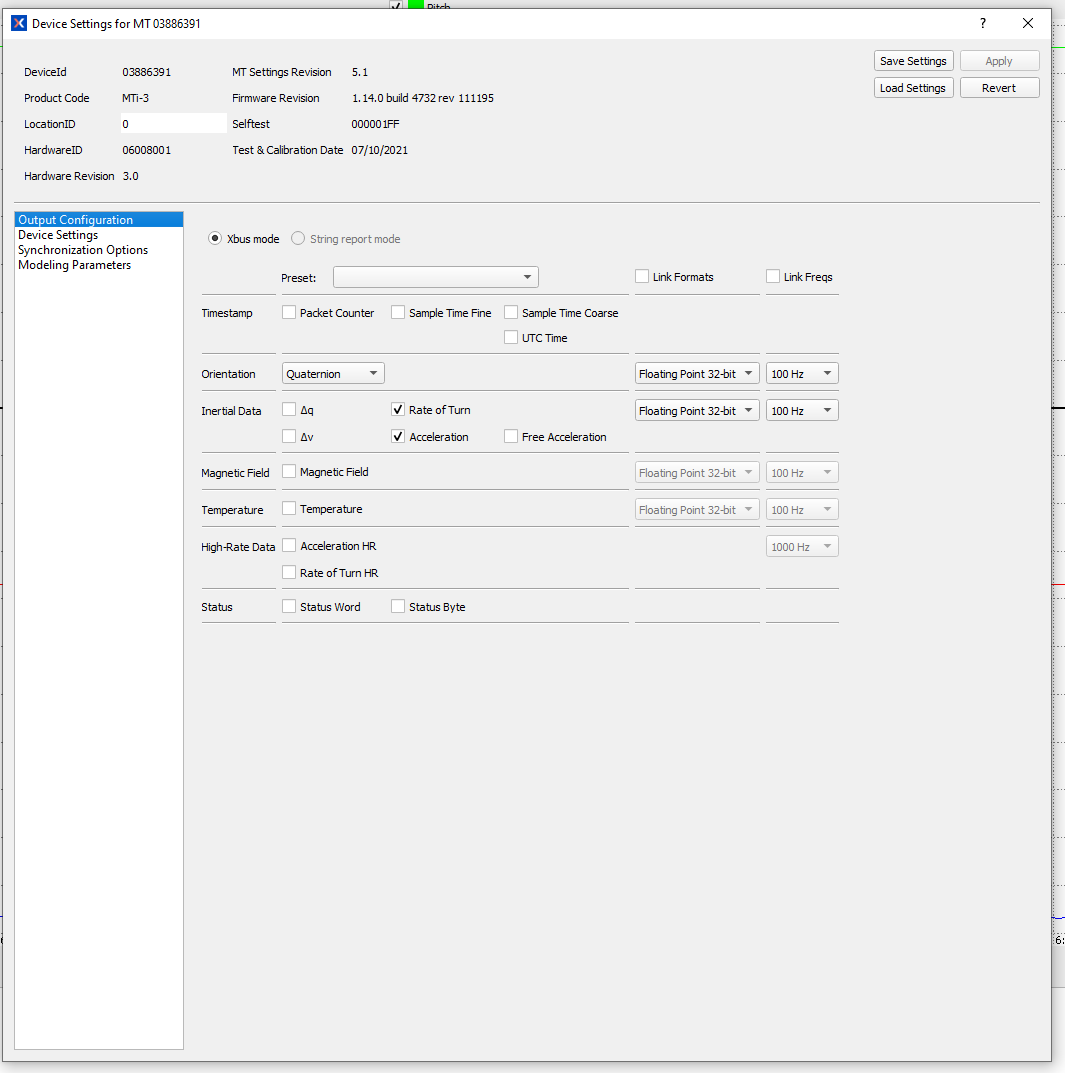
9_docs/2_hardware/xsense_mti3/2.png
