mruggia/momav/parts.xlsx

 |  |  |  | TOTAL | 1977.34
ORD | type | name | pcs | unit | price | link
 | PCB
 | standoffs | m3 various lengths | 0 | 0.00 | 0.00
 | pwr conn | JST XH | 0 | 0.00 | 0.00
 | sig conn | JST ZH | 0 | 0.00 | 0.00 | https://www.aliexpress.com/item/32869680262.html?spm=a2g0o.order_list.0.0.21ef1802GXjQ5h
 | board conn | 0.1'' machined header F | 4 | 1.90 | 7.60 | https://www.play-zone.ch/en/bauteile/stift-buchsenleisten/prazisions-buchsenleiste-1x40pin-rastermass-2-54mm.html
 | board conn | 0.1'' machined header M | 4 | 2.50 | 10.00 | https://www.play-zone.ch/en/bauteile/stift-buchsenleisten/prazisions-stiftleiste-1x40-pin-rm-2-54.html
 | jumper wire | 20 AWG solid core | 0 | 0.00 | 0.00 | https://www.doitgarden.ch/de/p/613227400000/max-hauri-0-5mm2-20-m
 | jumper wire | 26 AWG solid core | 0 | 0.00 | 0.00 | https://www.digikey.be/en/products/detail/alpha-wire/422601-BK001/6003185
 | clad board | MG Chemicals 512 | 1 | 11.30 | 11.30 | https://www.digikey.ch/en/products/detail/mg-chemicals/512/559721
 | CPU | Raspberry Pi 4 (4GB) | 0 | 64.90 | 0.00 | https://www.pi-shop.ch/raspberry-pi-4-model-b-4gb
 |  | Radxa Rock 5A (4GB/32GB/WIFI) | 1 | 181.00 | 181.00 | https://www.aliexpress.com/item/1005005727456179.html
 | imu | MTI-3-0I | 0 | 298.5 | 0.00 | https://www.digikey.ch/en/products/detail/xsens-technologies-bv/MTI-3-0I/14834329
 | baro | BMP390 | 0 | 10.1 | 0.00 | https://www.digikey.ch/en/products/detail/adafruit-industries-llc/4816/13543385
 | heatsinks | 110991328 | 1 | 1.8 | 1.80 | https://www.digikey.ch/en/products/detail/seeed-technology-co-ltd/110991328/10451864
 | fan | DB200303H1A-3T0 | 1 | 25.1 | 25.10 | https://www.digikey.ch/de/products/detail/wakefield-vette/DB200303H1A-3T0/12619936
 | camera SLAM | Intel T265 | 1 | 422.00 | 422.00 | https://www.aliexpress.com/item/1005002604739457.html?spm=a2g0o.order_list.0.0.21ef1802Odx4Cg
 | ESC | T-Motor MINI F45A 6S 4IN1 | 2 | 54.90 | 109.80 | https://www.hebu-shop.ch/shop/t-motor-mini-f45a-6s-blheli32-4-in-1-esc-20mm-x-20mm/
 | bat conn | XT60 | 2 | 6.90 | 13.80 | https://www.hebu-shop.ch/shop/xt60u-hochstrom-stecksystem-amass-bis-60a-5-paar/
 | motor conn | 2mm gold contact | 24 | 0.75 | 18.00 | https://www.hebu-shop.ch/shop/goldkontaktstecker-goldstecker-und-buchse-kurz-2-0mm-1-paar/
 | mcu | SparkFun SAMD21 Mini | 4 | 19.30 | 77.20 | https://www.digikey.ch/en/products/detail/sparkfun-electronics/DEV-13664/5766914
 | h bridge | DRV8871 | 6 | 2.90 | 17.40 | https://www.digikey.ch/en/products/detail/texas-instruments/DRV8871DDA/6110574
 | breakout | BOB-13655 | 1.5 | 2.70 | 4.05 | https://www.digikey.ch/en/products/detail/sparkfun-electronics/BOB-13655/5528943
 | pullup & ilim res | 330Ohm & 1.5kOhm resistors | 24 | 0.05 | 1.20 | https://www.conrad.ch/de/o/smd-widerstaende-0241260.html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
 | dc-dc 8.4V | I6A4W020A033V | 1 | 31.50 | 31.50 | https://www.digikey.ch/en/products/detail/tdk-lambda-americas-inc/I6A4W020A033V-001-R/5878834
 | dc-dc 5V | I3A4W008A033V | 1 | 21.30 | 21.30 | https://www.digikey.ch/en/products/detail/tdk-lambda-americas-inc/I3A4W008A033V-001-R/7321113
 | trim res (8.4V) | 3.24 kOhm 1/8W | 1 | 1.90 | 1.90 | https://www.digikey.ch/en/products/detail/vishay-dale/RN55D3241FB14/3338290
 | trim res (5V) | 8.45 kOhm 1/8W | 1 | 1.90 | 1.90 | https://www.digikey.ch/en/products/detail/vishay-dale/RN55D8451FB14/3336552
 | filter cap (out) | 0.1 uF ceramic | 2 | 0.50 | 1.00 | https://www.digikey.ch/en/products/detail/kyocera-avx/AR215F104K4R/1532242
 | filter cap (out) | 22uF alum | 2 | 0.40 | 0.80 | https://www.digikey.ch/en/products/detail/panasonic-electronic-components/EEA-GA1H220B/2513348
 | filter cap (in) | 100uF alum | 2 | 0.40 | 0.80 | https://www.digikey.ch/en/products/detail/illinois-capacitor/107RSS035M/5410778
 | Body
 | fdm filament | petg+carbon | 0.25 | 37.00 | 9.25 | https://www.3dware.ch/Filament-PET-G-mit-Carbon-Dunkelgrau-3mm-500g-De.htm
 | inserts | m3 | 22 | 0.40 | 8.80 | https://www.3dware.ch/Thread-insert-for-plastic-M3-En.htm
 | carbon sheet | 1.5mm Prepreg | 1.5 | 33.25 | 49.88 | https://shop.swiss-composite.ch/pi/Halbfabrikate/Plattenmaterial/CFK-Prepreg-Platten/Carbon-Prepreg-Platten-15mm.html
 | hardware | various m3 screws & nuts | 0 | 0.00 | 0.00
 | battery | swaytronic 6S 2800mAh | 2 | 82.30 | 164.60 | https://www.swaytronic.ch/SWAYTRONIC-LiPo-6S-22.2V-2800mAh-35C-70C-XT60
 | velcro | 20x280 & 20x190 set | 1 | 9.90 | 9.90 | https://www.hebu-shop.ch/shop/zohd-klettbaender-velcro-2x-20x280mm-4x-20x190mm-6er-set/
 | anti skid | adhesive silicone mat | 2 | 2.90 | 5.80 | https://www.hebu-shop.ch/shop/anti-rutschmatte-zur-akkusicherung-10x3-5cm-selbstklebend-3m/#
 | leg tubes | tube cfrp 16x17 | 0.6 | 43.50 | 26.10 | https://shop.swiss-composite.ch/pi/Halbfabrikate/Rohre/CFK-Rohre-USL/UltraSuperLite-CFK-Rohr-16-x-17mm.html
 | Arm
6x | motor | T-Motor F100 | 6 | 33.00 | 198.00 | https://store.tmotor.com/goods.php?id=1177
6x | propeller | DJI Mavic Pro Prop 8331 | 5 | 8.50 | 42.50 | https://www.hebu-shop.ch/shop/folding-propellers-klapp-propeller-8331-low-noise-zu-dji-mavic-pro-platinum/
6x | servo | KST Servo MS325 | 6 | 43.90 | 263.40 | https://www.hebu-shop.ch/shop/kst-servo-ms325-digital-metall-hv-12mm-stellkraft-5-2kg-cm/
6x | prop spacer | alu 10mm rod | 6 | 0.00 | 0.00
6x | carbon sheet | 1.5mm Prepreg | 1.5 | 33.25 | 49.88 | https://shop.swiss-composite.ch/pi/Halbfabrikate/Plattenmaterial/CFK-Prepreg-Platten/Carbon-Prepreg-Platten-15mm.html
6x | carbon rod | 8x10 USL Prepreg | 0.6 | 36.70 | 22.02 | https://shop.swiss-composite.ch/pi/Halbfabrikate/Rohre/CFK-Rohre-Prepreg/Prepreg-CFK-Rohr-8-x-10mm.html
6x | 2.5mm board | Epoxyd-Platte Carbotec | 0.5 | 17.95 | 8.97 | https://www.conrad.ch/de/p/epoxyd-platte-carbotec-l-x-b-350-mm-x-150-mm-2-5-mm-295795.html
6x | servo connector | alu stock 5mm | 0.1 | 6.95 | 0.70 | https://www.conrad.ch/de/p/aluminium-flach-profil-l-x-b-x-h-200-x-20-x-5-mm-1-st-229811.html
6x | bearing | 10x15x4 | 12 | 2.60 | 31.20 | https://www.kugellagerking.com/de/duennring-rillenkugellager-6700-zz-10x15x4-mm-3
6x | contact brushes | RS550 motor brush holder | 36 | 1.90 | 68.40 | https://www.ebay.ch/itm/184802088458?hash=item2b0710160a:g:vowAAOSwdHdgi64F#shpCntId
6x | contact tube | 12x10 brass tube | 0.2 | 14.95 | 2.99 | https://www.conrad.ch/de/p/messing-rohr-profil-x-l-12-mm-x-500-mm-innen-durchmesser-10-mm-222383.html
6x | copper clad | 1.6mm copper pcb clad | 0.2 | 6.30 | 1.26 | https://www.digikey.ch/en/products/detail/mg-chemicals/503/559704
6x | motor wire | 18AWG elastomer wire | 3 | 5.30 | 15.90 | https://fpvracing.ch/de/bauelemente/449-1m-silikondraht-18awg-rot-schwarz.html?search_query=silikon&results=69
6x | servo wire | 26AWG servo wire | 1 | 7.90 | 7.90 | https://www.hebu-shop.ch/shop/servokabel-26awg-0-13mm%c2%b2-10m/
6x | body fix screw | m3x22 | 78 | 0.02 | 1.31 | https://www.conrad.ch/de/p/toolcraft-104172-zylinderschrauben-m3-22-mm-schlitz-din-84-stahl-galvanisch-verzinkt-200-st-104172.html
6x | tube fix screw | m3x16 | 24 | 0.00 | 0.00
6x | motor fix screw | m3x20 | 24 | 0.00 | 0.00
6x | m3 nuts | m3 nut | 126 | 0.00 | 0.00
6x | prop+servo screw | m2x10 | 1.4 | 2.95 | 4.13 | https://www.brack.ch/oem-zylinderkopfschrauben-m2x10-mm-stahl-711245
6x | m2 nuts | m2 stopnut | 4.5 | 2.95 | 13.28 | https://www.brack.ch/oem-stopmutter-m2-711258
6x | anti vibration oring | 2x2mm oring | 48 | 0.24 | 11.74 | https://shop.maagtechnic.ch/de/dichtungen-o-ringe-und-zubehoer-o-ringe/o-ring-nbr-70-36624-2x2mm-10372089-de/
 | Addons
 | remote | Taranis X9D Plus | 1 | 300 |  | https://www.hebu-shop.ch/shop/frsky-taranis-x9d-plus-2019-se-accst-access-mode2-eu-version/
 | mocap + ground pc | Optitrack PrimeX 13W | 1 | 13000 |  | https://optitrack.com/cameras/prime-13w/
 | GNSS | ZED-F9P |  |  |  | https://www.gnss.store/gnss-gps-modules/105-ublox-zed-f9p-rtk-gnss-receiver-board-with-sma-base-or-rover.html
 | cellular link
 | long range radio
