mruggia/momav/9_docs/2_hardware/imu_picker.xlsx

 | price | avail | freq | AHRS | INS | r/p | y | comment | link
BNO055 | 49 | yes | 100 | yes | no | 2 | 5 |  | https://www.play-zone.ch/en/adafruit-9-dof-absolute-orientation-imu-fusion-breakout-bno055.html
BNO085 | 24 | no | 400 | yes | no | 2 | 5 |  | https://www.adafruit.com/product/4754
VN-100 SMD | 540 | yes | 400 | yes | no | 0.5 | 2 |  | https://www.vectornav.com/products/detail/vn-100
VN-200 SMD | 2430 | yes | 400 | yes | yes | 0.03 | 0.2 |  | https://www.vectornav.com/products/detail/vn-200
VN-300 SMD | 3030 | yes | 400 | yes | yes | 0.03 | 0.2 | 2x gps | https://www.vectornav.com/products/detail/vn-300
3DMCV5-AHRS | 676 | no | 500 | yes | no | 0.8 | 2 |  | https://www.microstrain.com/inertial-sensors/3dm-cv5-25
3DMXXX | ? | no | 500 | opt | opt | ? | ? |  | https://www.microstrain.com/inertial-sensors/all-sensors
InertialSense uIMU | 550 | yes | ? | no | no | no | no |  | https://inertialsense.com/product/imu/
InertialSense uAHRS | 800 | yes | ? | yes | no | 0.05 | 2 | has gps | https://inertialsense.com/product/ahrs/
InertialSense uINS | 1500 | yes | ? | yes | yes | 0.05 | 2 | rtk | https://inertialsense.com/product/ins/
Ellipse 2 Micro IMU | ? | no | 200 | no | no | no | no |  | https://www.sbg-systems.com/products/ellipse-micro-series/
Ellipse 2 Micro AHRS | ? | no | 200 | yes | no | 0.1 | 0.8
Ellipse 2 Micro INS | ? | no | 200 | yes | yes | 0.1 | 0.8
Adis16448 | 600 | no | ? | no | no | no | no | used at asl | https://www.analog.com/media/en/technical-documentation/data-sheets/adis16448.pdf
MPU6050 | ? | no | ? | yes | no | ? | ? | no mag | https://www.sparkfun.com/products/11028
MPU9150 | ? | no | ? | yes | no | ? | ?
Pluto N1 | 260 | no | 200 | yes | no | 0.5 | 0.8
OS3D-FG | 1200 | yes | 500 | yes | no | 0.1 | 0.8 |  | https://ozrobotics.com/shop/high-precision-3d-orientation-sensor-os3d-fg/
OS3DM | 554 | yes | 500 | yes | no | 0.5 | 0.5 |  | https://ozrobotics.com/shop/sub-miniature-3d-orientation-sensor-os3dm/
OS3D | ? | no | 500 | yes | no | 0.2 | 1
UM7 | 230 | yes | 500 | yes | no | 1 | 3 |  | https://www.pololu.com/product/2763
Intel ZR300 | ? | no |  |  |  |  |  | camera SLAM
Intel T265 | 370 | yes | 200 | yes | yes | ? | ? | camera SLAM | https://www.digitec.ch/de/s1/product/intel-realsense-t265-kamera-diverse-drohne-zubehoer-14594092
Intel T261
MTi-1 IMU | 150 | no | 100 | no | no | 0.5 | 2 |  | https://shop.spezial.com/sensorik/1643-mti-1-t.html
MTi-2 VRU | 230 | yes | 100 | no | no | 0.5 | 2 |  | https://shop.spezial.com/sensorik/1646-mti-2-t.html
MTi-3 AHRS | 310 | yes | 100 | yes | no | 0.5 | 2 |  | https://shop.spezial.com/sensorik/1649-mti-3-t.html
MTi-7 GNSS | 420 | yes | 100 | yes | yes | 0.5 | 1.5 |  | https://shop.spezial.com/sensorik/1652-mti-7-t.html
pixhawk 4
Pixhawk 4 mini
navio2
