mruggia/momav/3_cam/fdm/battery_holder/a_assembly.stl

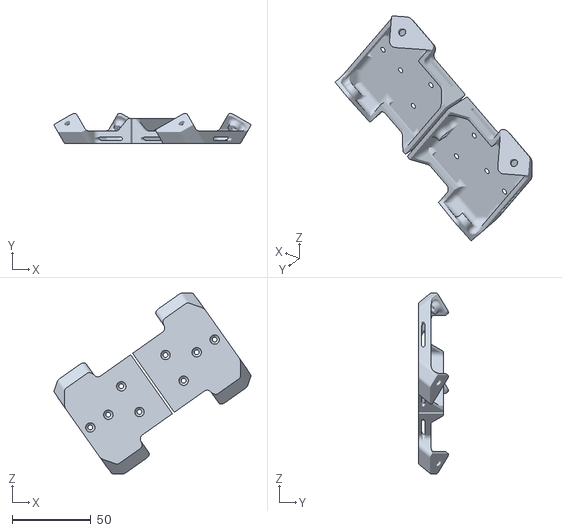
[picture p79: CAD file, 2024-05-27]
3_cam/fdm/battery_holder/a_assembly.stl
125.4 x 19.1 x 115.1
