mruggia/momav/3_cam/router/pcb_brush/m_brush.dxf

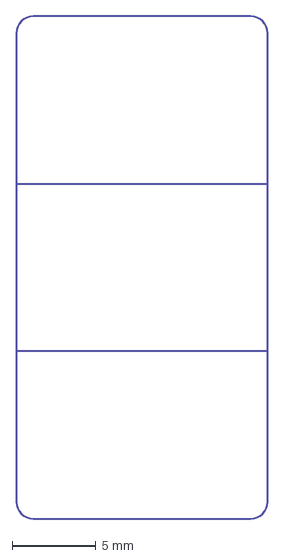
[picture p80: CAD file, 2024-05-27]
3_cam/router/pcb_brush/m_brush.dxf
15.0 x 30.0 mm
