mruggia/momav/3_cam/router/resin_servo/m_mount_servo.dxf

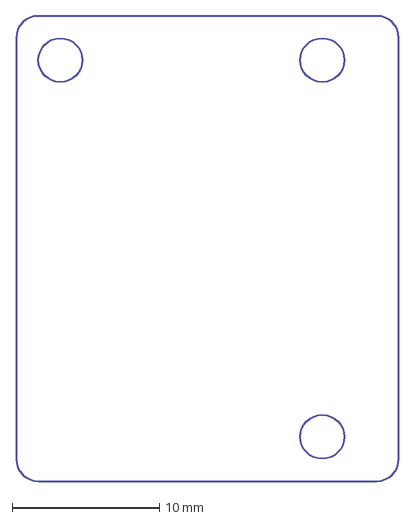
[picture p81: CAD file, 2024-05-27]
3_cam/router/resin_servo/m_mount_servo.dxf
26.0 x 31.6 mm
