mruggia/momav/3_cam/router/servo_tube_adapter/m_mount_tube.dxf

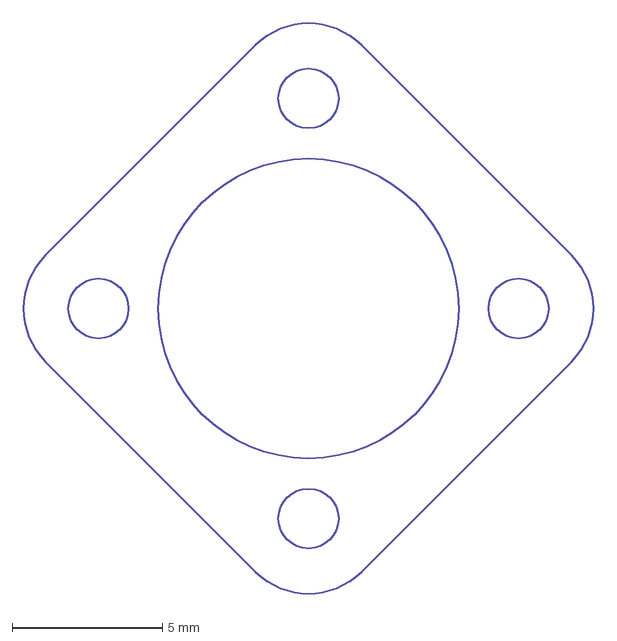
[picture p82: CAD file, 2024-05-27]
3_cam/router/servo_tube_adapter/m_mount_tube.dxf
19.5 x 19.5 mm
