mruggia/momav/(list of files, cad)

Other CAD files:
1_cad/arm/a_arm.prt
1_cad/arm/m_bearing_6700.prt
1_cad/arm/m_board_esc.prt
1_cad/arm/m_board_mcu.prt
1_cad/arm/m_board_servo.prt
1_cad/arm/m_brush.prt
1_cad/arm/m_cfrp_frame.prt
1_cad/arm/m_cfrp_tube.prt
1_cad/arm/m_motor_f100.prt
1_cad/arm/m_mount_bearing.prt
1_cad/arm/m_mount_body.prt
1_cad/arm/m_mount_motor.prt
1_cad/arm/m_mount_servo.prt
1_cad/arm/m_mount_tube.prt
1_cad/arm/m_prop_DJI8331.prt
1_cad/arm/m_screw_m3x22.prt
1_cad/arm/m_servo_MS325.prt
1_cad/body/a_assembly.prt
1_cad/body/m_arm.prt
1_cad/body/m_board_esc.prt
1_cad/body/m_board_pwr.prt
1_cad/body/m_board_servo.prt
1_cad/body/m_frame.prt
1_cad/body/m_legs_calib.prt
1_cad/body/m_legs_light.prt
1_cad/body/m_legs_rigid.prt
1_cad/body/m_lipo.prt
1_cad/body/m_optitrack.prt
1_cad/body/m_raspberry.prt
1_cad/body/m_realsense.prt
1_cad/body/m_screw_m3x8.prt
1_cad/body/m_tether.prt
5_test/2_arms/2_code/testarm_interface/motor_mount.prt
5_test/5_geometry/efficiency/icons/cub_fix.prt
5_test/5_geometry/efficiency/icons/cub_rot.prt
5_test/5_geometry/efficiency/icons/hex_fix.prt
5_test/5_geometry/efficiency/icons/hex_rot.prt
5_test/5_geometry/efficiency/icons/o7p_fix.prt
5_test/5_geometry/efficiency/icons/oct_fix.prt
5_test/5_geometry/efficiency/icons/oct_rot.prt
5_test/5_geometry/efficiency/icons/odar_fix.prt
5_test/5_geometry/efficiency/icons/sqr_rot.prt
5_test/5_geometry/efficiency/icons/tet_rot.prt
5_test/5_geometry/geometry/shape.prt
5_test/5_geometry/geometry/shape2.prt
9_docs/0_report/img/partial/cad_arm.prt
