mruggia/momav/9_docs/0_report/img/2_arm_assembly-eps-converted-to.pdf

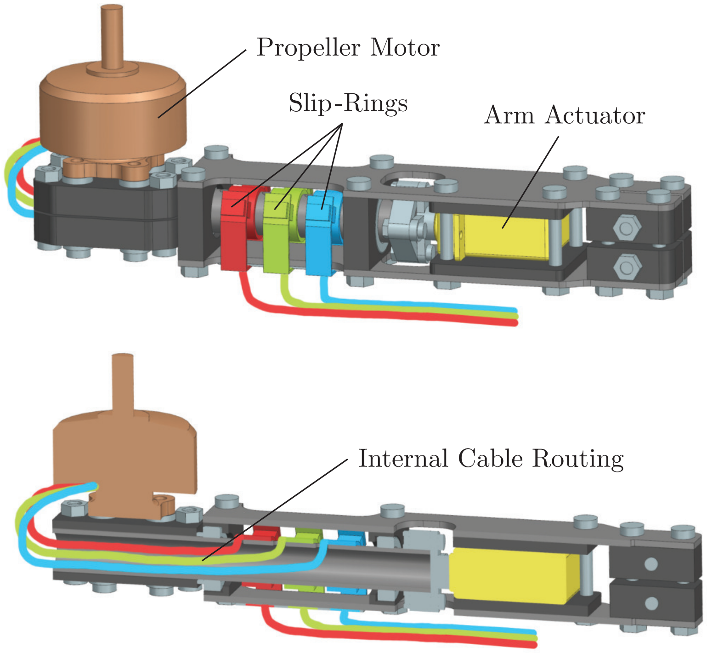
[picture p83: page 1]

Propeller Motor

Slip-Rings | Arm Actuator

Internal Cable Routing
