mruggia/momav/2_pcb/servo/info/bottom_wiring - Copy.png

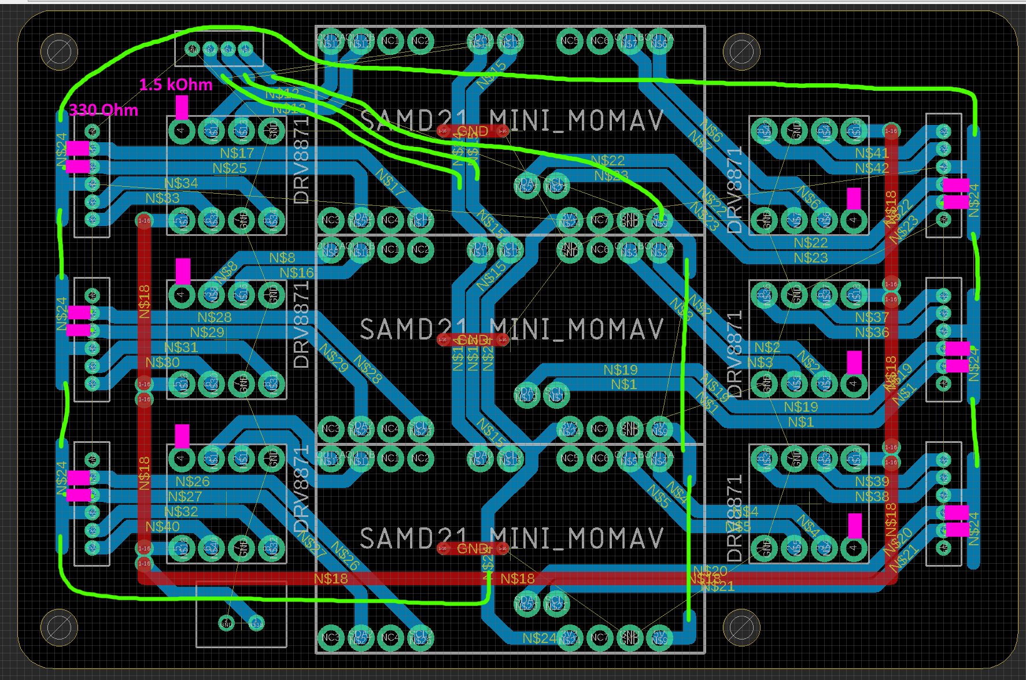
2_pcb/servo/info/bottom_wiring - Copy.png
