mruggia/momav/9_docs/0_report/img/partial/2_arm_assembly.png

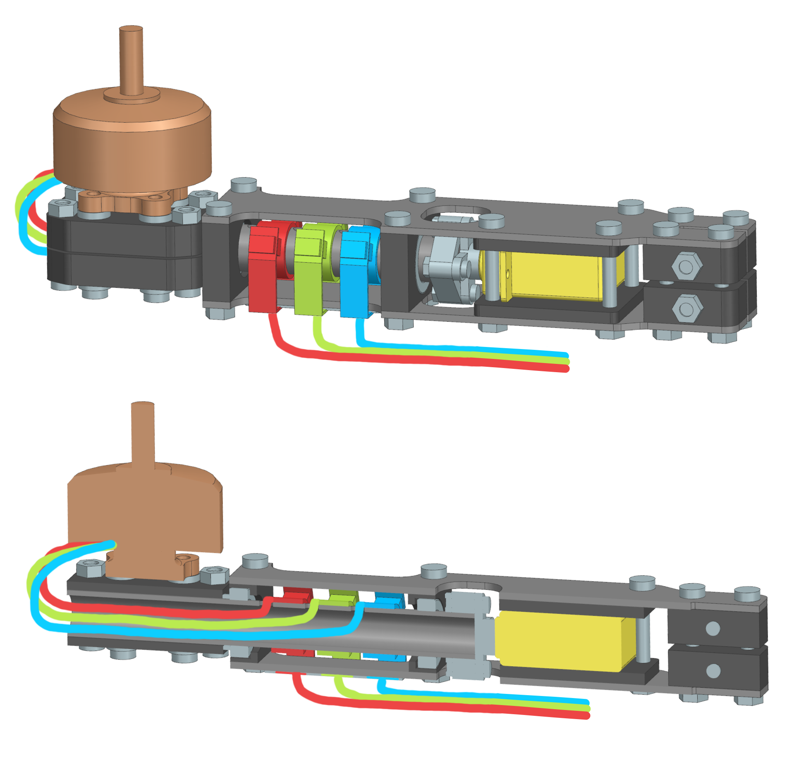
9_docs/0_report/img/partial/2_arm_assembly.png
