mruggia/momav/5_test/2_arms/1_img/servo_info.txt

SERVO (KST MS352)
	datasheet:	https://www.kst-servos.com/produkte/kst-ms-serie/ms-325/

	power:	0.32A (nominal) 1.2A (stall) >1.8A (peak)(for psu)
	vel:	~2.5rev/sec
	torque:	0.51Nm
	
	controller:	SZD900 (NOT USED)
	
	encoder: 	AS5600	https://ams.com/documents/20143/36005/AS5600_DS000365_5-00.pdf/649ee61c-8f9a-20df-9e10-43173a3eb323
	  analog:	Vin = 3.3V, Sig = 0V-3.3V <-> 0°-360° (NOT USED! USE I2C INSTEAD)
	  i2c:		330Ohm pull up for fast-mode plus (with SAMD21)
