mruggia/momav/5_test/6_ctrl_param_ident/estim_body_param.xlsx

MASS | kg | INERTIA | kg*m^2
empty | 1.57 | Ixx | 0.0201
battery | 0.78 | Iyy | 0.0177
arm | 0.16 | Izz | 0.0202
core | 0.61
full | 2.35
