mruggia/momav/5_test/6_ctrl_param_ident/estim_motor_param.xlsx

F-100
throttle | thrust | current | voltage | rpm | power |  | F_corr | c_f | F_lin | M_calc | M_corr | c_m | M_lin
0.3 | 401 | 2.45 | 25.16 | 9515 | 61.66 |  | 3.93381 | 13.1127 | 4.694291857 | 0.06188225197 | 0.04331757638 | 0.1443919213 | 0.05314553092
0.35 | 474 | 3.26 | 25.14 | 10387 | 82.04 |  | 4.64994 | 13.28554286 | 5.476673833 | 0.07542353826 | 0.05279647678 | 0.1508470765 | 0.06200311941
0.4 | 557 | 4.08 | 25.133 | 11099 | 102.6 |  | 5.46417 | 13.660425 | 6.259055809 | 0.08827442379 | 0.06179209665 | 0.1544802416 | 0.0708607079
0.45 | 627 | 4.96 | 25.11 | 11846 | 124.58 |  | 6.15087 | 13.6686 | 7.041437785 | 0.1004264198 | 0.07029849384 | 0.1562188752 | 0.07971829638
0.5 | 714 | 5.95 | 25.09 | 12541 | 149.2 |  | 7.00434 | 14.00868 | 7.823819762 | 0.1136077706 | 0.07952543939 | 0.1590508788 | 0.08857588487
0.55 | 786 | 6.95 | 25.07 | 13259 | 174.17 |  | 7.71066 | 14.01938182 | 8.606201738 | 0.1254393986 | 0.08780757903 | 0.1596501437 | 0.09743347336
0.6 | 870 | 7.83 | 25.05 | 13890 | 196.22 |  | 8.5347 | 14.2245 | 9.388583714 | 0.1349001423 | 0.09443009958 | 0.1573834993 | 0.1062910618
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
