mruggia/momav/5_test/6_ctrl_param_ident/estim_pd_param.xlsx

P | 4 | t | r | dr | ddr | e | u
D | 0.4 | 0 | 0 | 0 | 0 | -1 | 4
 |  | 0.002 | 0.0008 | 0.4 | 200 | -0.9992 | 3.8368
dt | 0.002 | 0.004 | 0.00236736 | 0.78368 | 191.84 | -0.99763264 | 3.67705856
m | 0.02 | 0.006 | 0.004670131712 | 1.151385856 | 183.852928 | -0.9953298683 | 3.520765131
setp | 1 | 0.008 | 0.00767705645 | 1.503462369 | 176.0382565 | -0.9923229435 | 3.367906827
 |  | 0.01 | 0.01135756255 | 1.840253052 | 168.3953413 | -0.9886424374 | 3.218468529
 |  | 0.012 | 0.01568176236 | 2.162099905 | 160.9234265 | -0.9843182376 | 3.072432989
 |  | 0.014 | 0.02062044877 | 2.469343204 | 153.6216494 | -0.9793795512 | 2.929780924
 |  | 0.016 | 0.02614509136 | 2.762321296 | 146.4890462 | -0.9738549086 | 2.790491116
 |  | 0.018 | 0.03222783218 | 3.041370407 | 139.5245558 | -0.9677721678 | 2.654540508
 |  | 0.02 | 0.03884148109 | 3.306824458 | 132.7270254 | -0.9611585189 | 2.521904292
 |  | 0.022 | 0.04595951087 | 3.559014888 | 126.0952146 | -0.9540404891 | 2.392556002
 |  | 0.024 | 0.05355605184 | 3.798270488 | 119.6278001 | -0.9464439482 | 2.266467598
 |  | 0.026 | 0.06160588634 | 4.024917247 | 113.3233799 | -0.9383941137 | 2.143609556
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
