mruggia/momav/5_test/6_ctrl_param_ident/estim_throttle_penalty.xlsx

upl | 0.05
uph | 0.9
wp | 400
0 | 0 | 1 | 0 | 1
0.005 | 2.5e-05 | 0.81 | 0 | 0.810025
0.01 | 0.0001 | 0.64 | 0 | 0.6401
0.015 | 0.000225 | 0.49 | 0 | 0.490225
0.02 | 0.0004 | 0.36 | 0 | 0.3604
0.025 | 0.000625 | 0.25 | 0 | 0.250625
0.03 | 0.0009 | 0.16 | 0 | 0.1609
0.035 | 0.001225 | 0.09 | 0 | 0.091225
0.04 | 0.0016 | 0.04 | 0 | 0.0416
0.045 | 0.002025 | 0.01 | 0 | 0.012025
0.05 | 0.0025 | 0 | 0 | 0.0025
0.055 | 0.003025 | 0 | 0 | 0.003025
0.06 | 0.0036 | 0 | 0 | 0.0036
0.065 | 0.004225 | 0 | 0 | 0.004225
0.07 | 0.0049 | 0 | 0 | 0.0049
0.075 | 0.005625 | 0 | 0 | 0.005625
0.08 | 0.0064 | 0 | 0 | 0.0064
0.085 | 0.007225 | 0 | 0 | 0.007225
0.09 | 0.0081 | 0 | 0 | 0.0081
0.095 | 0.009025 | 0 | 0 | 0.009025
0.1 | 0.01 | 0 | 0 | 0.01
0.105 | 0.011025 | 0 | 0 | 0.011025
0.11 | 0.0121 | 0 | 0 | 0.0121
0.115 | 0.013225 | 0 | 0 | 0.013225
0.12 | 0.0144 | 0 | 0 | 0.0144
0.125 | 0.015625 | 0 | 0 | 0.015625
0.13 | 0.0169 | 0 | 0 | 0.0169
0.135 | 0.018225 | 0 | 0 | 0.018225
0.14 | 0.0196 | 0 | 0 | 0.0196
0.145 | 0.021025 | 0 | 0 | 0.021025
0.15 | 0.0225 | 0 | 0 | 0.0225
0.155 | 0.024025 | 0 | 0 | 0.024025
0.16 | 0.0256 | 0 | 0 | 0.0256
0.165 | 0.027225 | 0 | 0 | 0.027225
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
