mruggia/momav/5_test/2_arms/3_plot/testarm_plot_servo/data.csv

com_ts | srv_pos | srv_setp | srv_volt | esc_setp | esc_volt | esc_curr | esc_rpm
1176098290 | -0.000192 | 0.000000 | 0.001602 | 0.000000 | 25.000000 | 0.070000 | 0.000000
1176108277 | 0.000192 | 0.000000 | -0.020340 | 0.000000 | 25.000000 | 0.070000 | 0.000000
1176118278 | -0.000671 | 0.000000 | 0.029488 | 0.000000 | 25.000000 | 0.070000 | 0.000000
1176128339 | -0.000575 | 0.000000 | 0.006373 | 0.000000 | 25.000000 | 0.070000 | 0.000000
1176138281 | -0.000575 | 0.000000 | 0.007891 | 0.000000 | 25.000000 | 0.070000 | 0.000000
1176148296 | 0.000288 | 0.000000 | 0.010520 | 0.000000 | 25.000000 | 0.070000 | 0.000000
1176158338 | -0.000192 | 0.000000 | 0.004871 | 0.000000 | 25.000000 | 0.070000 | 0.000000
1176168326 | 0.000192 | 0.000000 | -0.017197 | 0.000000 | 25.000000 | 0.070000 | 0.000000
1176178304 | 0.000288 | 0.000000 | 0.015651 | 0.000000 | 25.000000 | 0.070000 | 0.000000
1176188316 | 0.000288 | 0.000000 | -0.012837 | 0.000000 | 25.000000 | 0.070000 | 0.000000
1176198295 | 0.000575 | 0.000000 | -0.001443 | 0.000000 | 25.000000 | 0.070000 | 0.000000
1176208279 | -0.000192 | 0.000000 | 0.003901 | 0.000000 | 25.000000 | 0.070000 | 0.000000
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
