mruggia/momav/5_test/2_arms/0_old/old_wrench_calib/result.xlsx

 | force
motor | 50% (1) | 70% (1) | 50% (2) | 70% (2)
1 | 6.5491 | 10.628 | 5.6319 | 9.6063 | 13.0982 | 15.18285714 | 11.2638 | 13.72328571 | 13.3
2 | 9.2073 | 14.5334 | 8.0588 | 13.3797 | 18.4146 | 20.762 | 16.1176 | 19.11385714 | 18.6
3 | 7.8253 | 12.4877 | 6.8734 | 11.6144 | 15.6506 | 17.83957143 | 13.7468 | 16.592 | 16.0
4 | 8.5228 | 13.6982 | 7.5771 | 12.5453 | 17.0456 | 19.56885714 | 15.1542 | 17.92185714 | 17.4
5 | 7.7159 | 12.1744 | 6.7887 | 11.4162 | 15.4318 | 17.392 | 13.5774 | 16.30885714 | 15.7
6 | 6.8716 | 11.1019 | 6.26 | 10.4741 | 13.7432 | 15.85985714 | 12.52 | 14.963 | 14.3
 | torque
1 |  |  |  |  |  |  |  |  | 0.151
2 |  |  |  |  |  |  |  |  | 0.211
3 |  |  |  |  |  |  |  |  | 0.181
4 |  |  |  |  |  |  |  |  | 0.197
5 |  |  |  |  |  |  |  |  | 0.177
6 |  |  |  |  |  |  |  |  | 0.162
 |  |  |  |  |  |  |  | old cf | 15.6
 |  |  |  |  |  |  |  | old cm | 0.177
