mruggia/momav/5_test/1_flight/0_other/screenshots/060.png

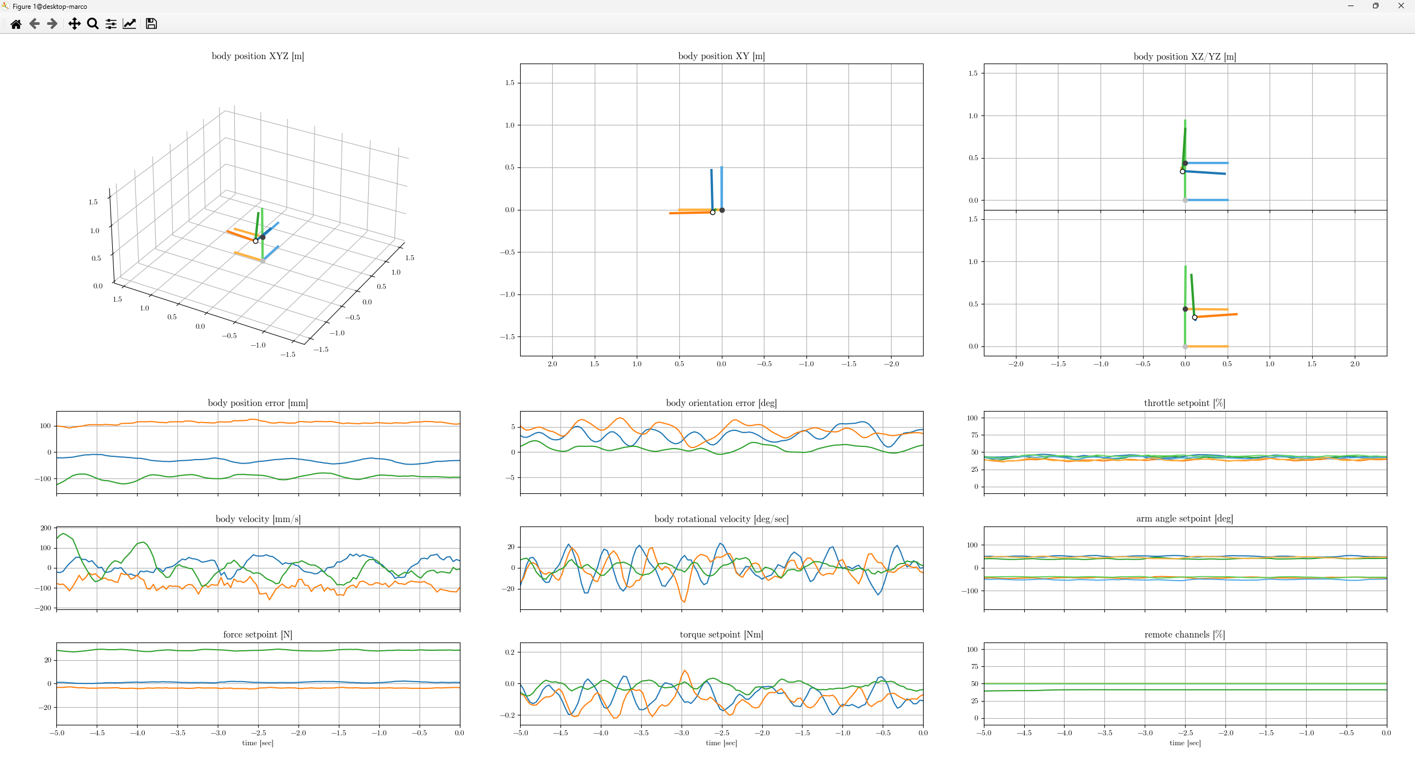
5_test/1_flight/0_other/screenshots/060.png
