mruggia/momav/5_test/2_arms/1_img/IMG_20220218_085932.jpg

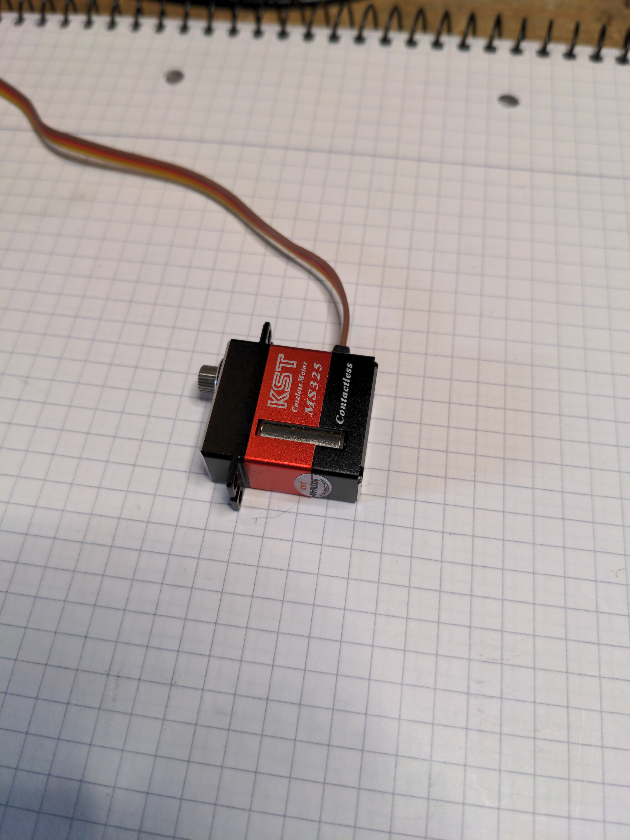
5_test/2_arms/1_img/IMG_20220218_085932.jpg
