mruggia/momav/5_test/2_arms/1_img/IMG_20220218_090834.jpg

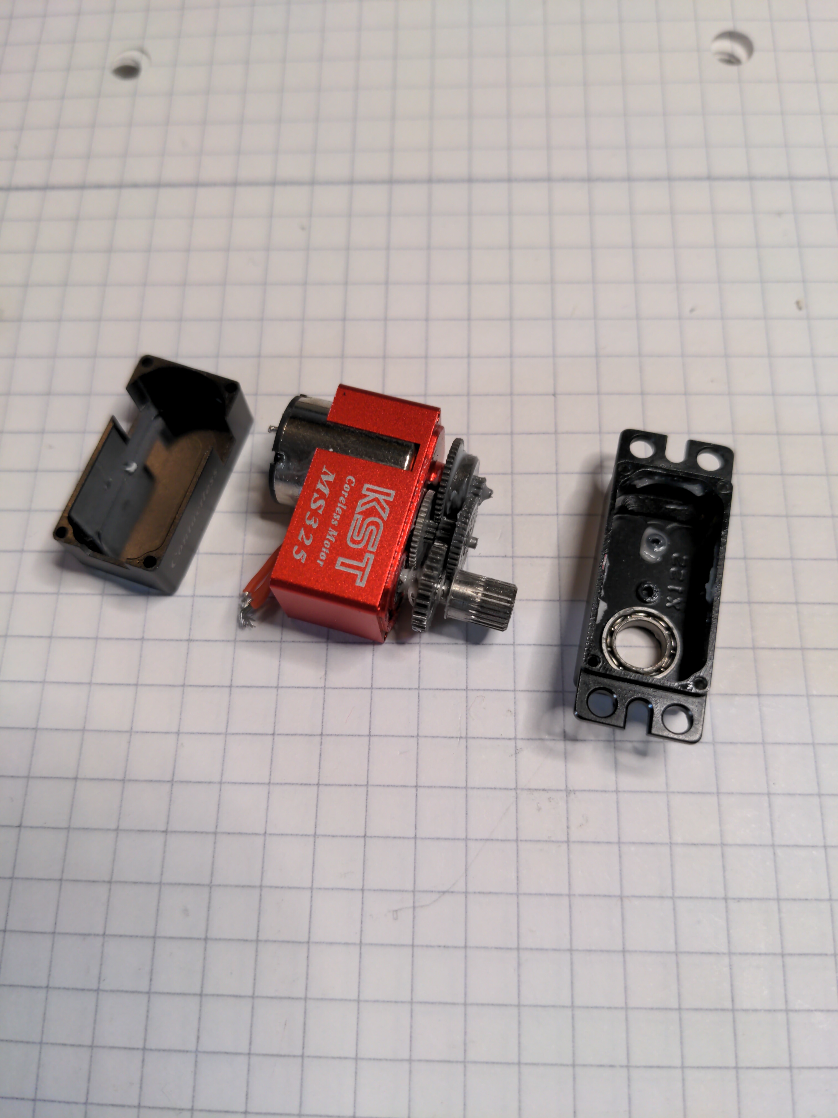
5_test/2_arms/1_img/IMG_20220218_090834.jpg
