mruggia/momav/5_test/2_arms/1_img/IMG_20220218_091554.jpg

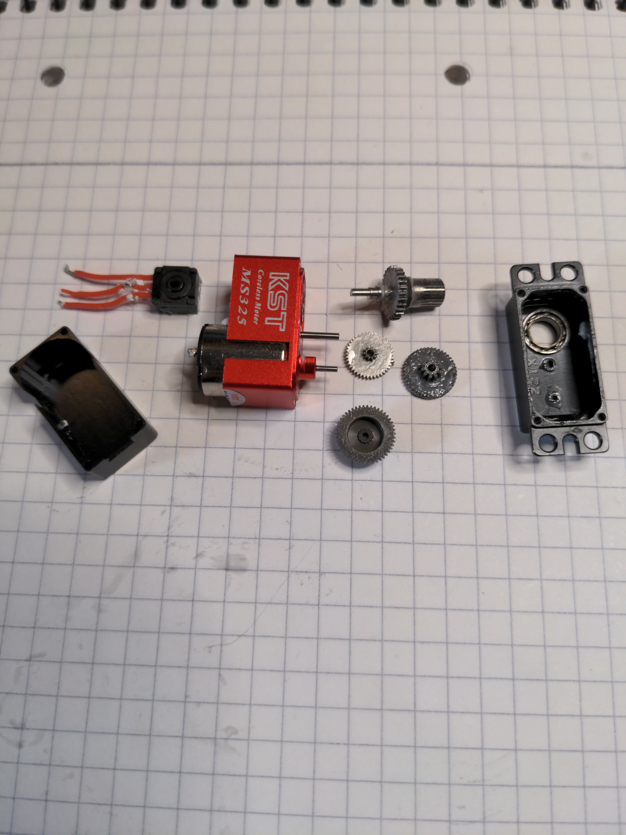
5_test/2_arms/1_img/IMG_20220218_091554.jpg
