mruggia/momav/5_test/5_geometry/geometry/octahedron_lengths.png

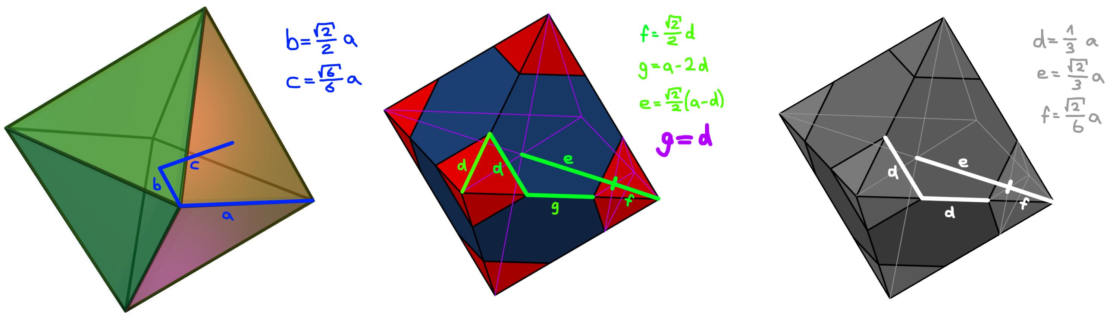
5_test/5_geometry/geometry/octahedron_lengths.png
