mruggia/momav/9_docs/0_report/img/1_geometry_analysis1-eps-converted-to.pdf

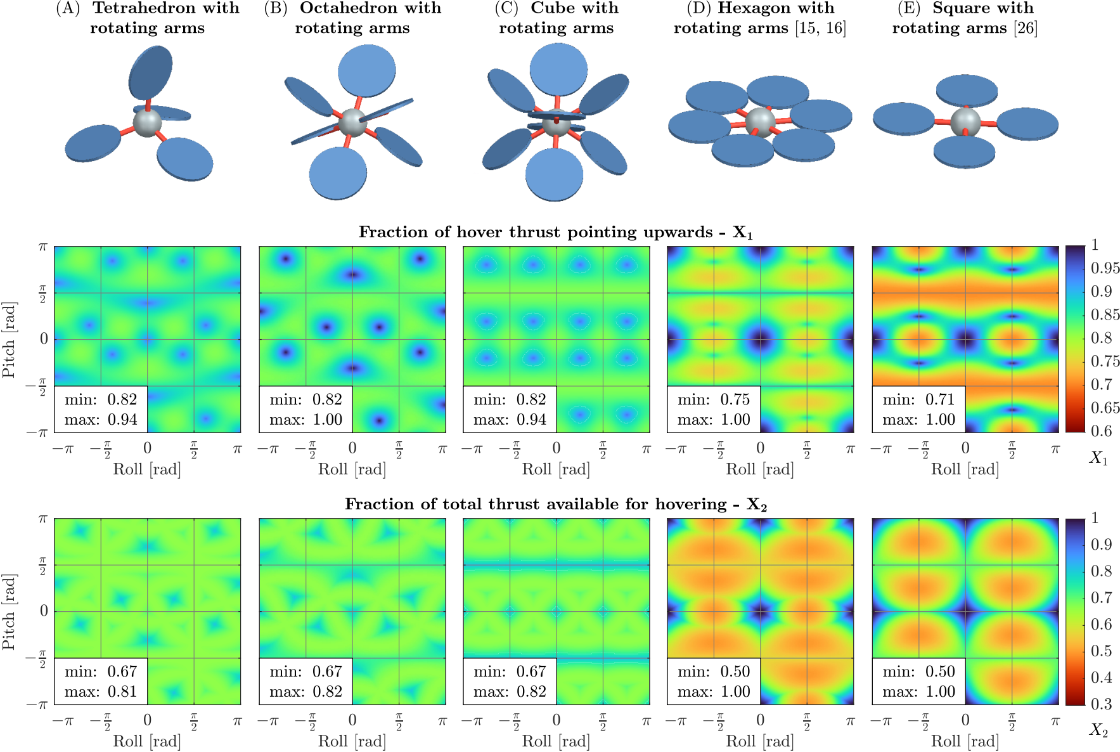
[picture p103: page 1]
