mruggia/momav/9_docs/0_report/img/1_geometry_analysis2-eps-converted-to.pdf

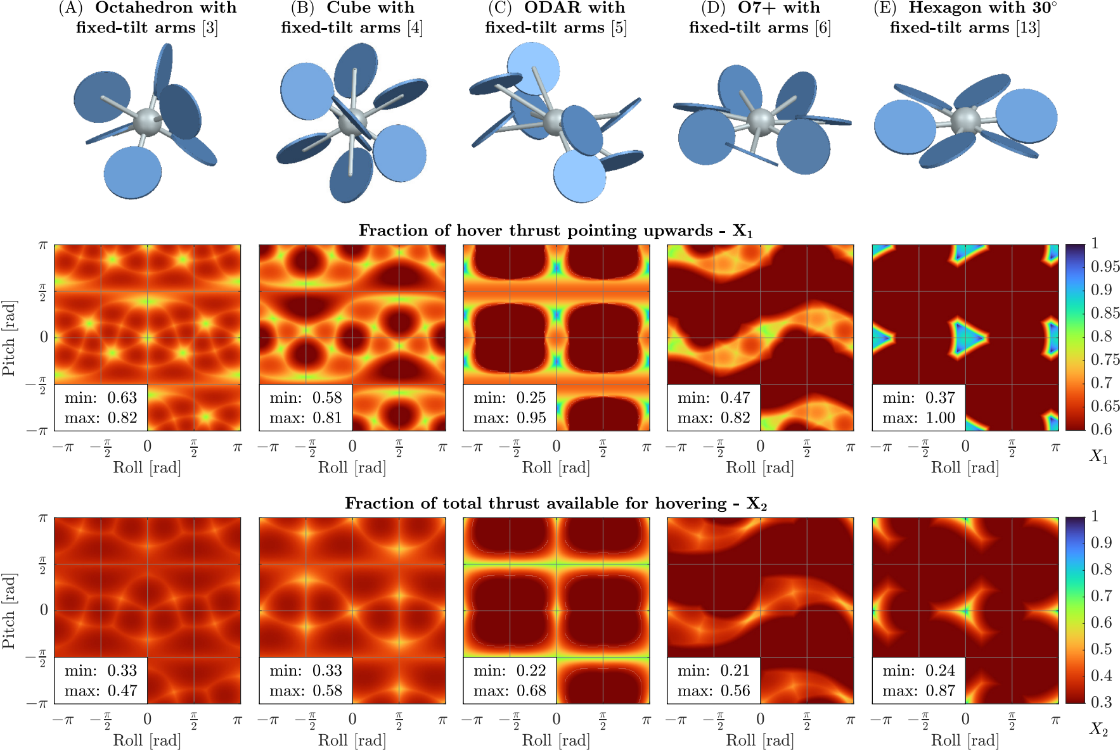
[picture p104: page 1]
