mruggia/momav/9_docs/0_report/img/2_servo_dynamics-eps-converted-to.pdf

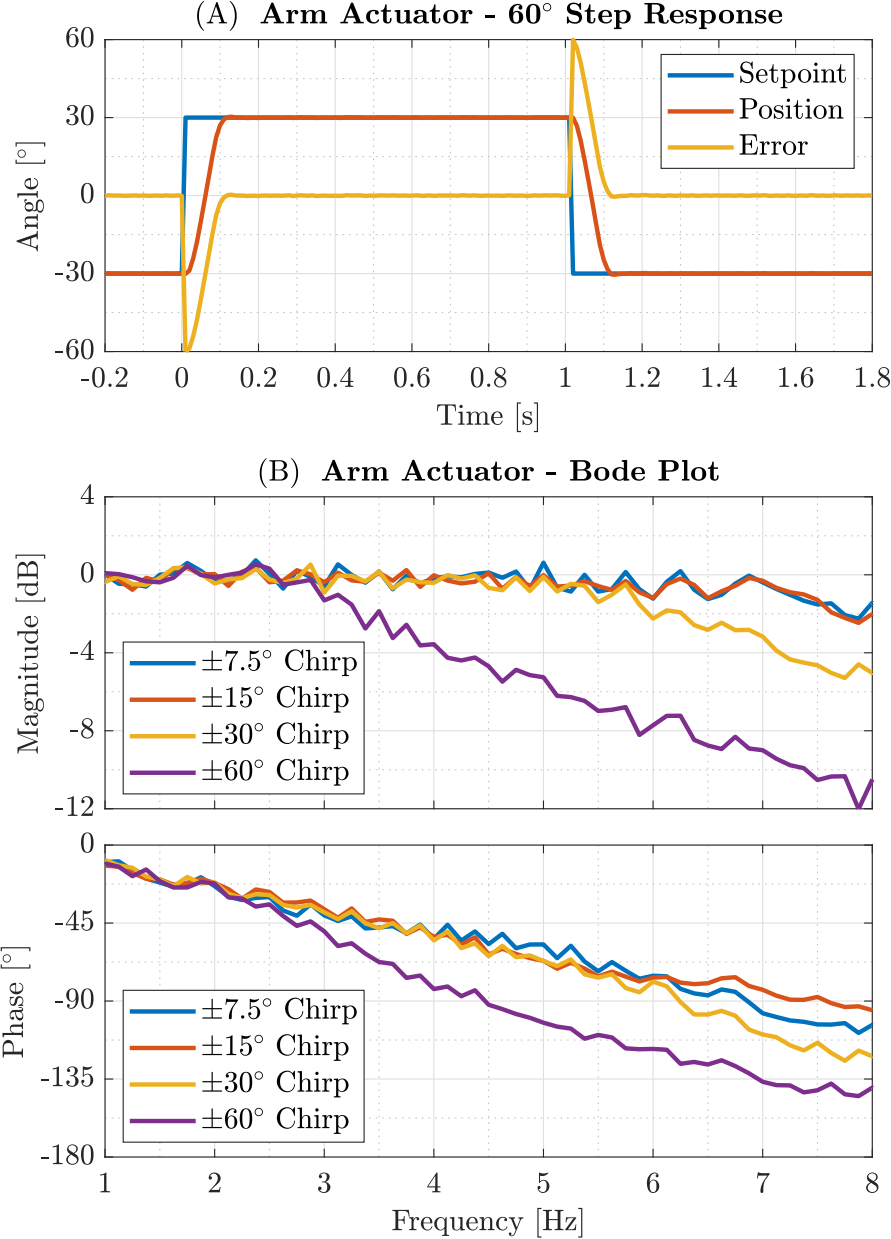
[picture p105: page 1]
