mruggia/momav/9_docs/0_report/img/2_slipring_loss-eps-converted-to.pdf

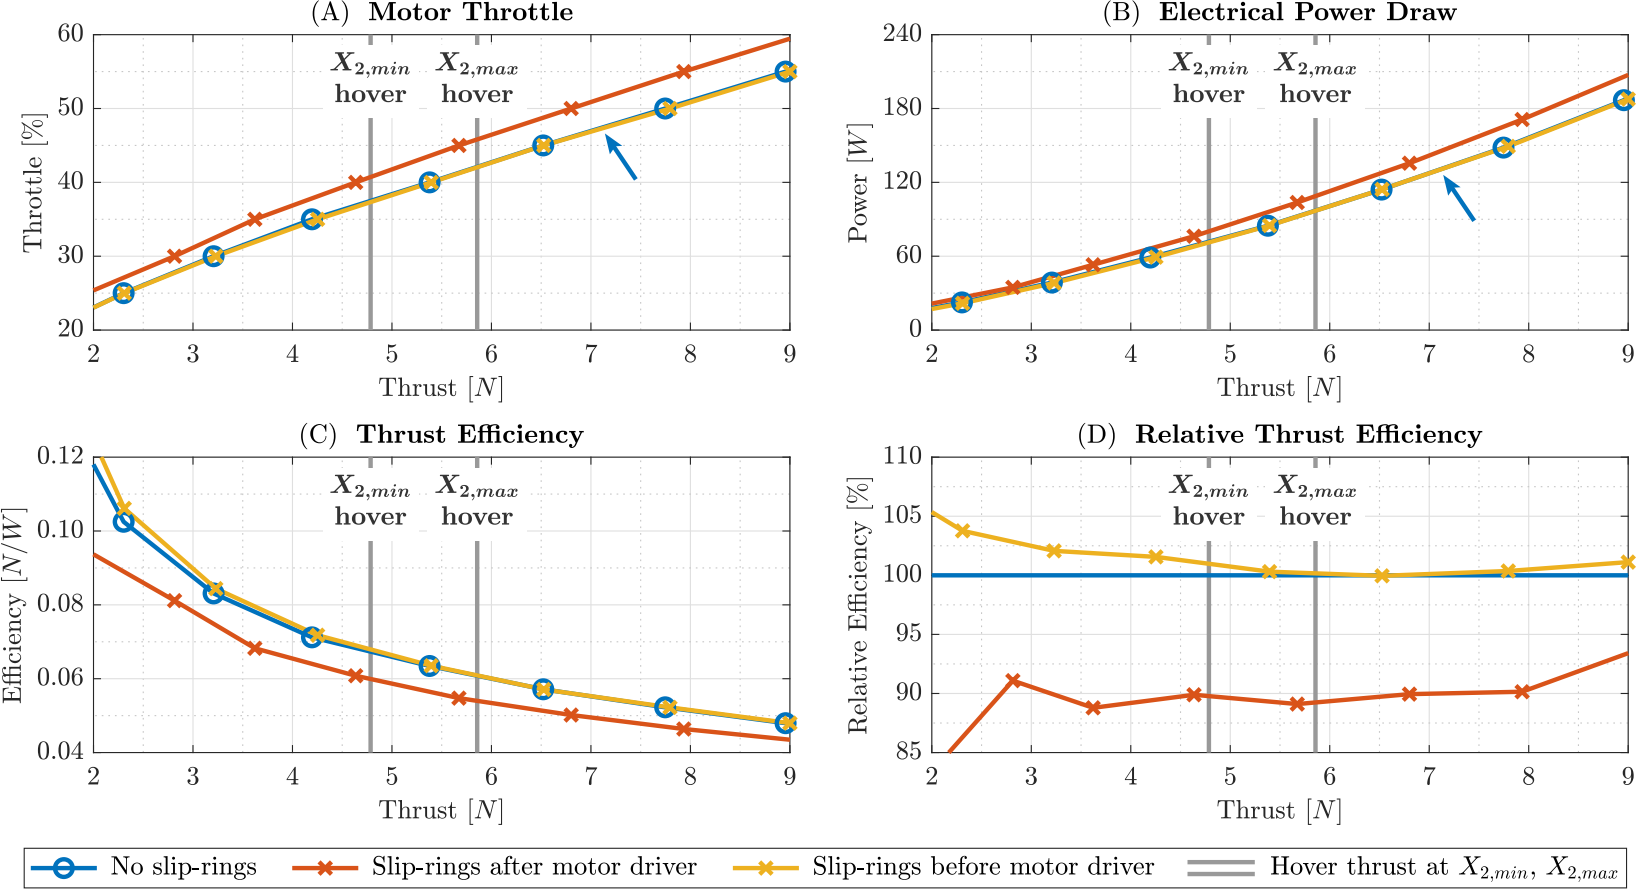
[picture p106: page 1]
