mruggia/momav/9_docs/0_report/img/3_sqp_penalty-eps-converted-to.pdf

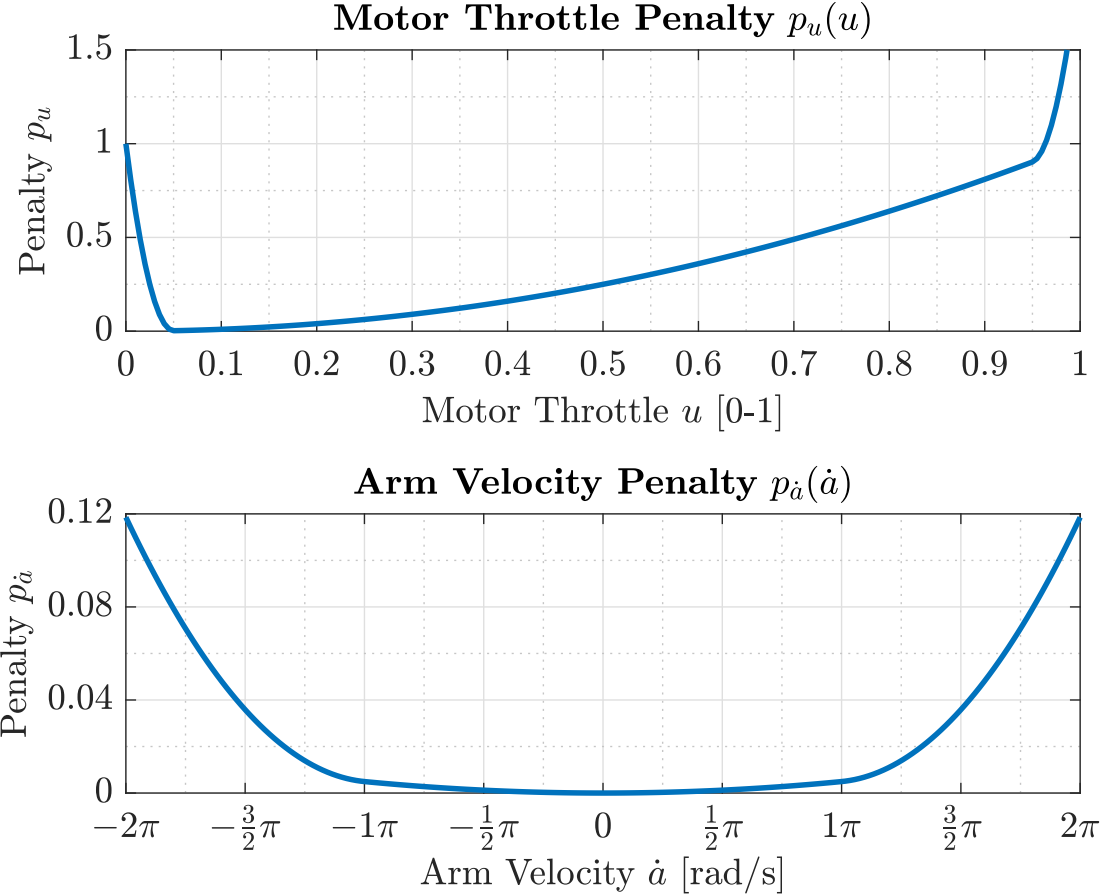
[picture p107: page 1]
