mruggia/momav/9_docs/0_report/img/4_flight_cont_rot-eps-converted-to.pdf

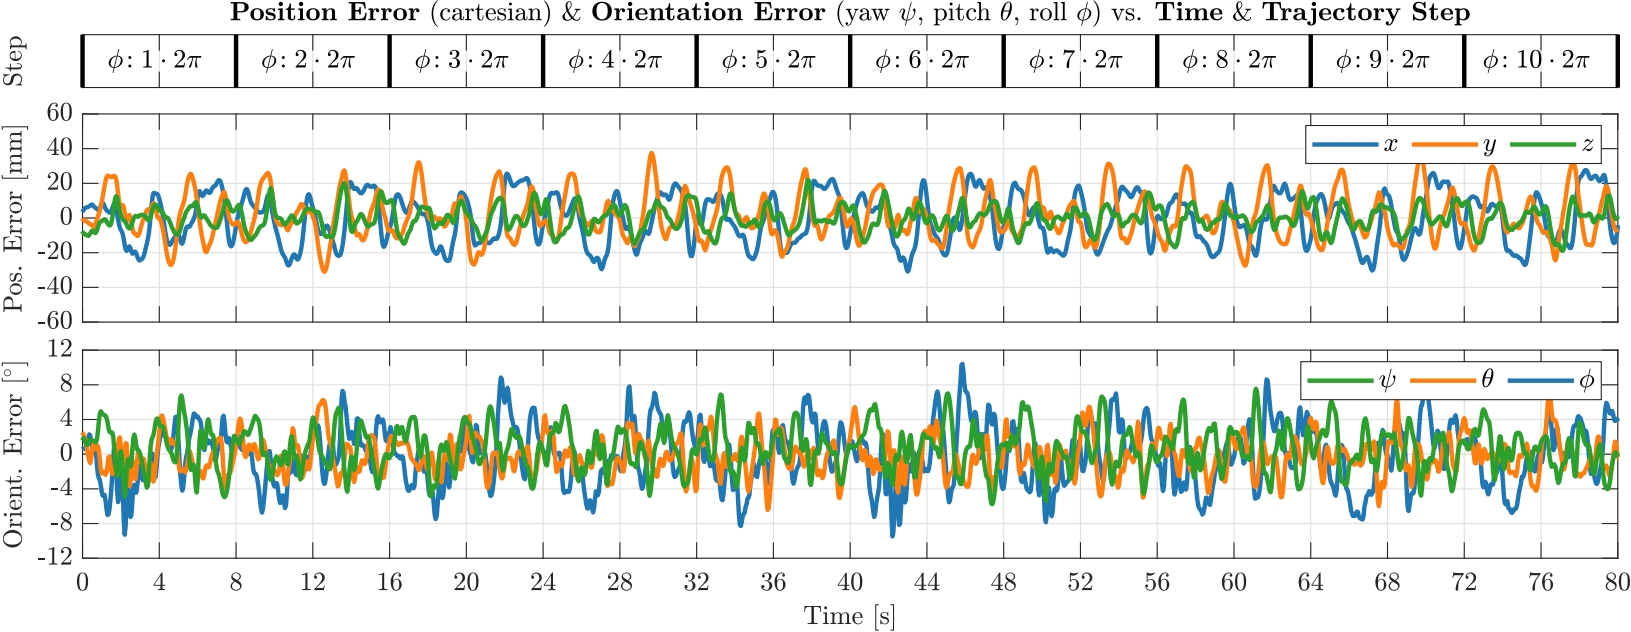
[picture p108: page 1]
