mruggia/momav/9_docs/0_report/img/4_flight_no_sqp-eps-converted-to.pdf

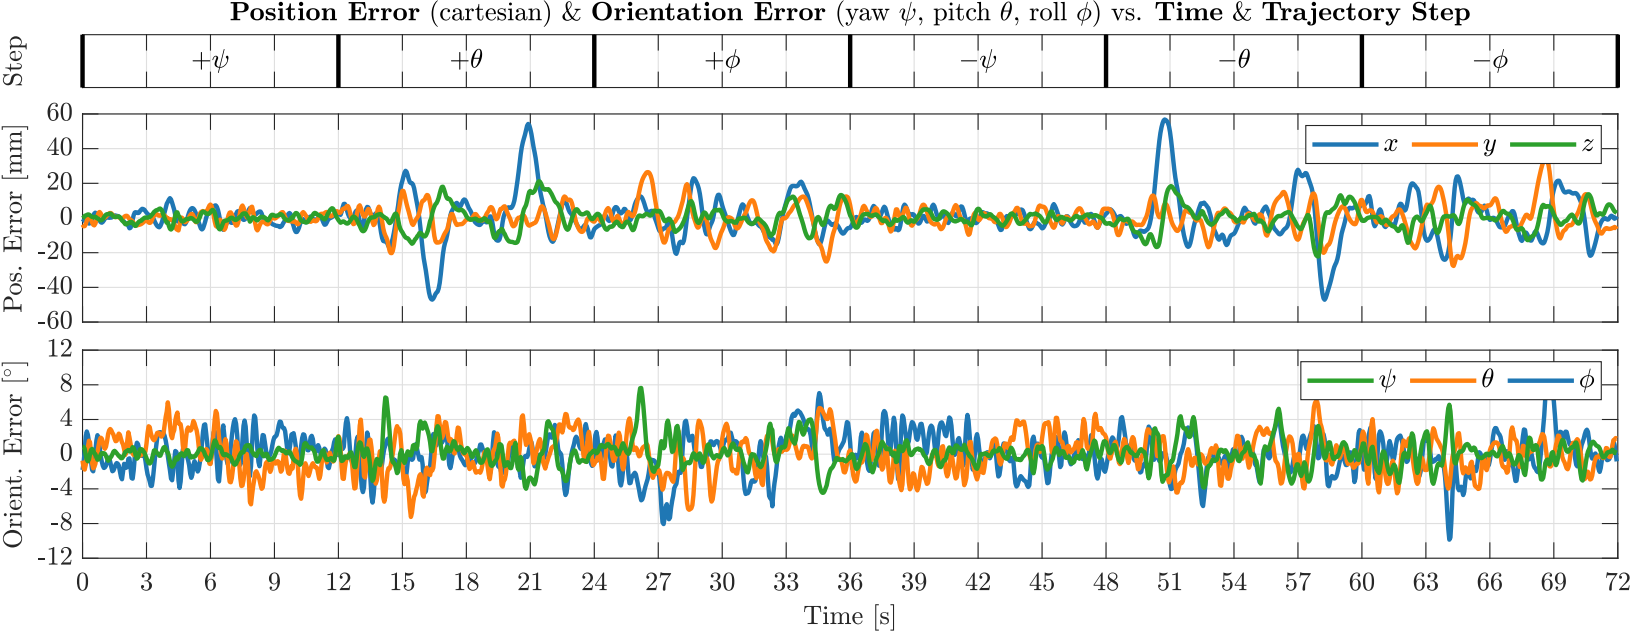
[picture p109: page 1]
