mruggia/momav/9_docs/0_report/img/4_flight_pos_sweep-eps-converted-to.pdf

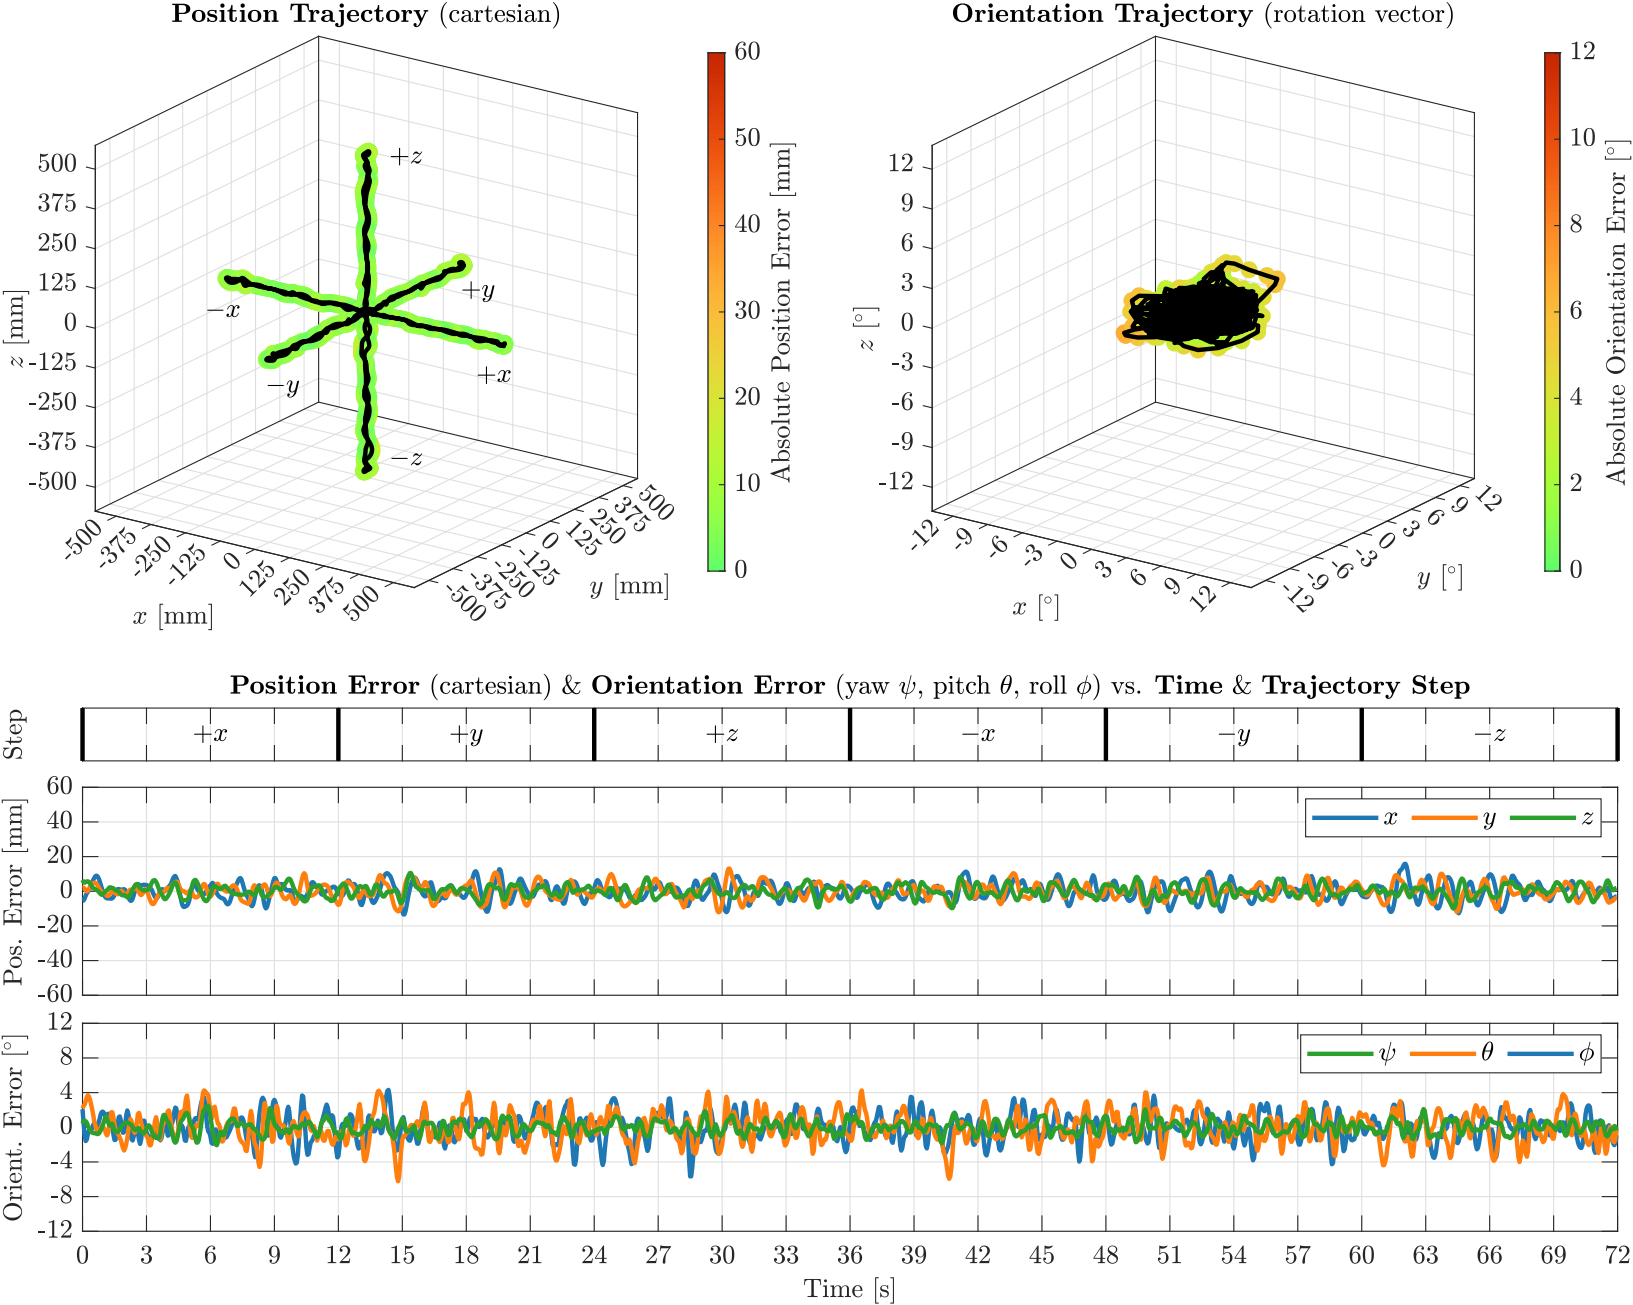
[picture p110: page 1]
