mruggia/momav/9_docs/0_report/img/4_flight_rot_sweep-eps-converted-to.pdf

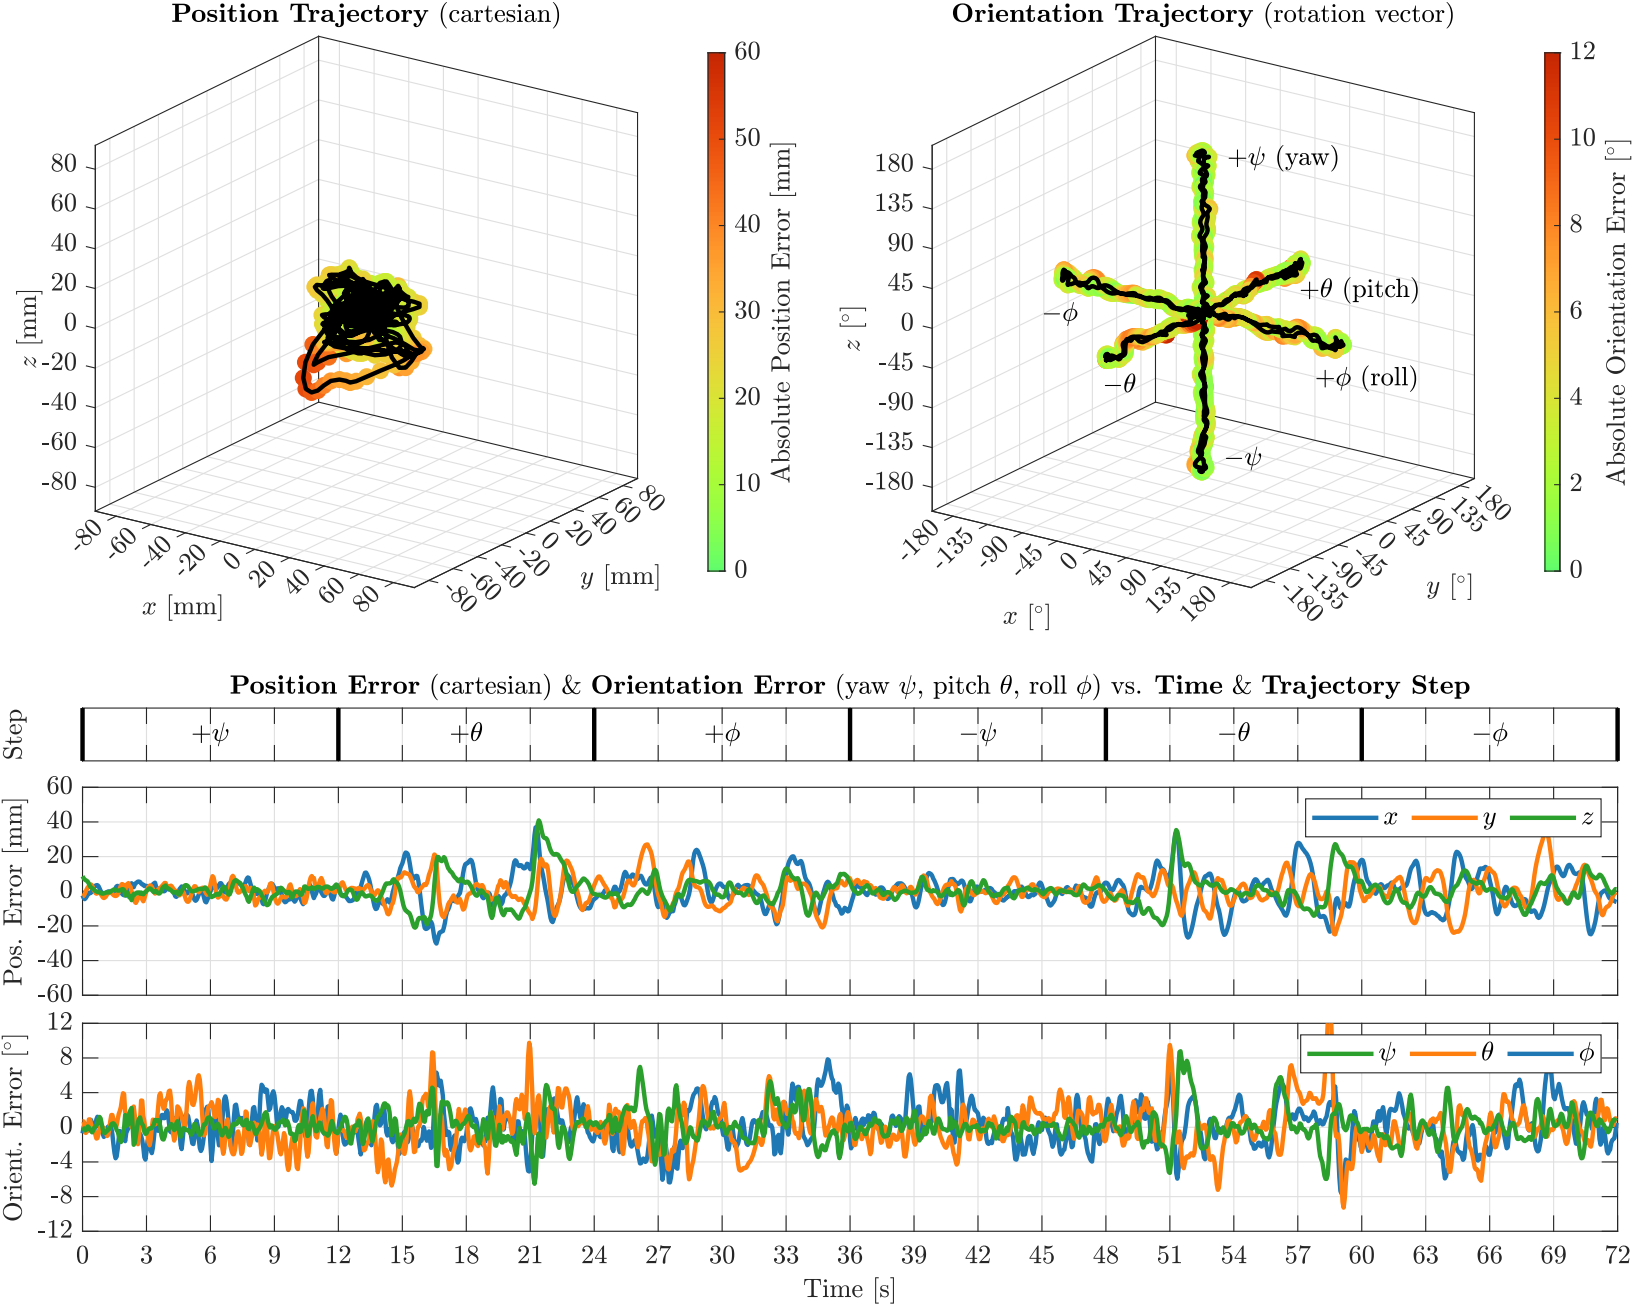
[picture p111: page 1]
