mruggia/momav/2_pcb/servo/momav_servo.brd

## EAGLE design 2_pcb/servo/momav_servo.brd (2024-05-27)

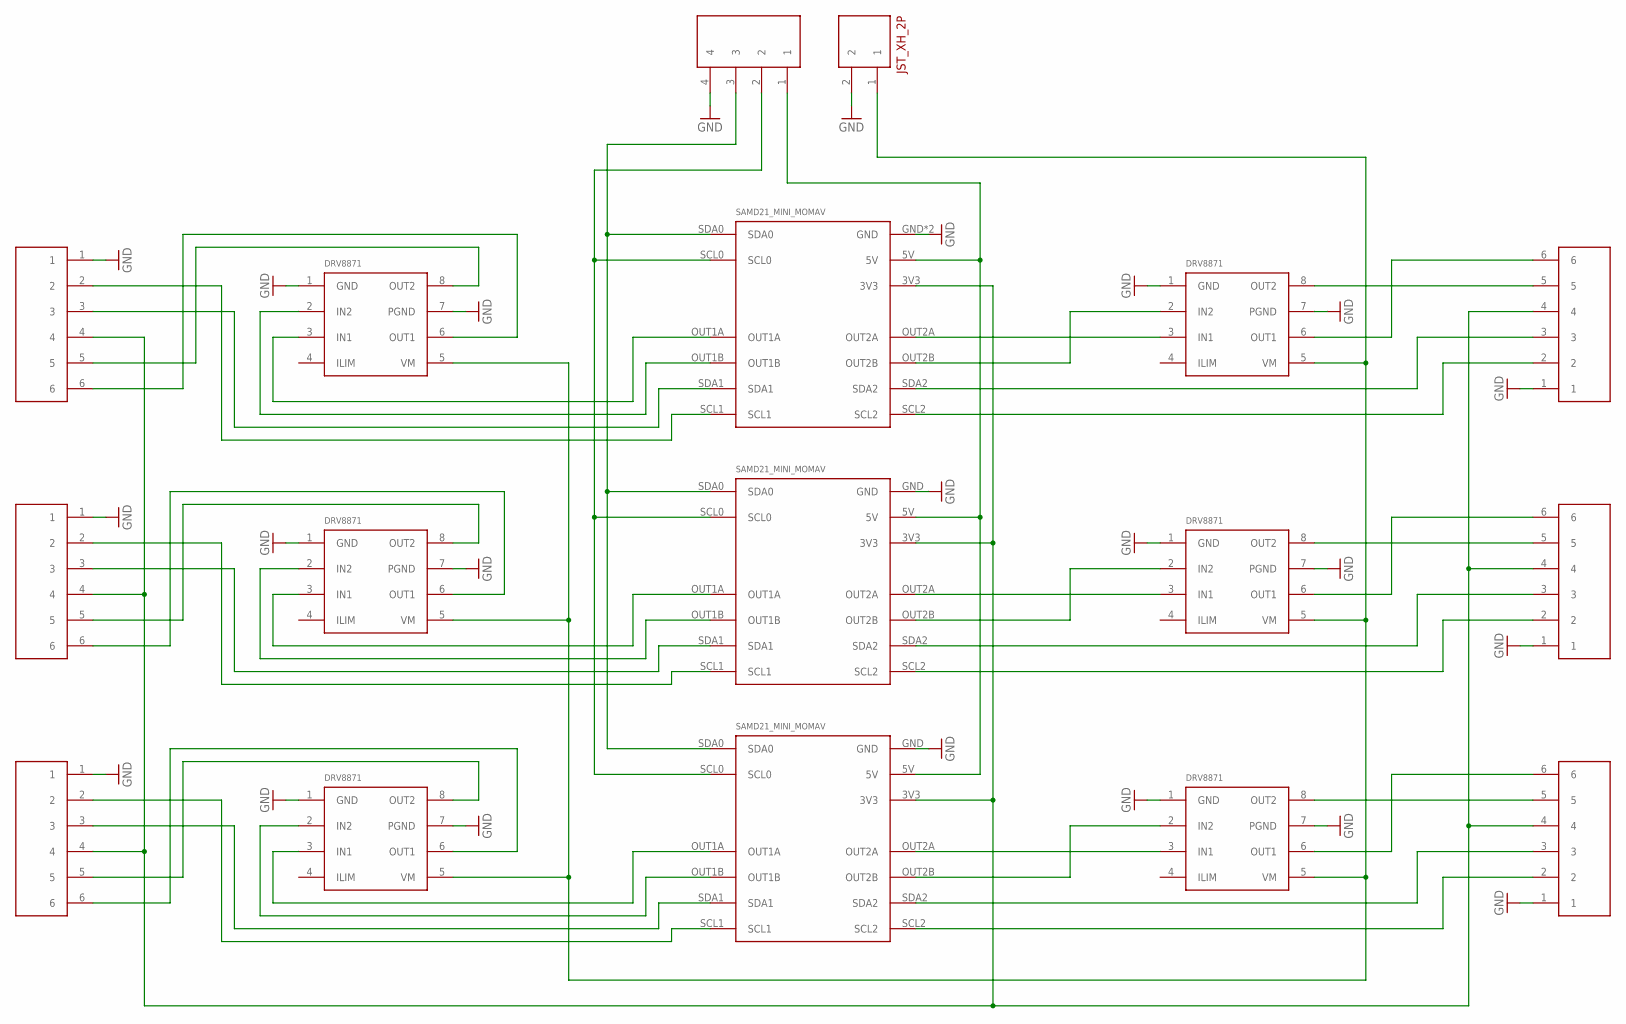
[picture p116: schematic momav_servo.sch]

Parts:
U$1, U$2, U$3, U$4, U$5, U$6: DRV8871BOB
U$7: SAMD21_MINI_MOMAV1
U$8, U$9: SAMD21_MINI_MOMAV
U$10: JST_XH_2P
U$11: JST_ZH_4P
U$12, U$13, U$14, U$15, U$16, U$17: JST_ZH_6P

Connections:
GND: U$1.1 (GND), U$1.7 (PGND), U$2.1 (GND), U$2.7 (PGND), U$3.1 (GND), U$3.7 (PGND), U$4.1 (GND), U$4.7 (PGND), U$5.1 (GND), U$5.7 (PGND), U$6.1 (GND), U$6.7 (PGND), U$7.GND, U$7.GND2 (GND), U$8.GND, U$9.GND, U$10.2, U$11.4, U$12.1, U$13.1, U$14.1, U$15.1, U$16.1, U$17.1
unnamed: U$7.SCL1, U$12.2
unnamed: U$1.3 (IN1), U$7.OUT1A
unnamed: U$1.2 (IN2), U$7.OUT1B
unnamed: U$2.3 (IN1), U$8.OUT1A
unnamed: U$2.2 (IN2), U$8.OUT1B
unnamed: U$3.3 (IN1), U$9.OUT1A
unnamed: U$3.2 (IN2), U$9.OUT1B
unnamed: U$4.3 (IN1), U$7.OUT2A
unnamed: U$7.5V, U$8.5V, U$9.5V, U$11.1
unnamed: U$5.3 (IN1), U$8.OUT2A
unnamed: U$5.2 (IN2), U$8.OUT2B
unnamed: U$6.3 (IN1), U$9.OUT2A
unnamed: U$6.2 (IN2), U$9.OUT2B
unnamed: U$7.SDA0, U$8.SDA0, U$9.SDA0, U$11.3
unnamed: U$7.SCL0, U$8.SCL0, U$9.SCL0, U$11.2
unnamed: U$4.2 (IN2), U$7.OUT2B
unnamed: U$9.SCL2, U$15.2
unnamed: U$1.5 (VM), U$2.5 (VM), U$3.5 (VM), U$4.5 (VM), U$5.5 (VM), U$6.5 (VM), U$10.1
unnamed: U$7.SDA1, U$12.3
unnamed: U$8.SDA1, U$13.3
unnamed: U$8.SCL1, U$13.2
unnamed: U$9.SDA1, U$14.3
unnamed: U$9.SCL1, U$14.2
unnamed: U$7.3V3, U$8.3V3, U$9.3V3, U$12.4, U$13.4, U$14.4, U$15.4, U$16.4, U$17.4
unnamed: U$9.SDA2, U$15.3
unnamed: U$8.SCL2, U$16.2
unnamed: U$8.SDA2, U$16.3
unnamed: U$7.SCL2, U$17.2
unnamed: U$7.SDA2, U$17.3
unnamed: U$4.6 (OUT1), U$17.6
unnamed: U$4.8 (OUT2), U$17.5
unnamed: U$5.8 (OUT2), U$16.5
unnamed: U$6.6 (OUT1), U$15.6
unnamed: U$6.8 (OUT2), U$15.5
unnamed: U$1.8 (OUT2), U$12.5
unnamed: U$1.6 (OUT1), U$12.6
unnamed: U$2.8 (OUT2), U$13.5
unnamed: U$2.6 (OUT1), U$13.6
unnamed: U$5.6 (OUT1), U$16.6
unnamed: U$3.6 (OUT1), U$14.6
unnamed: U$3.8 (OUT2), U$14.5

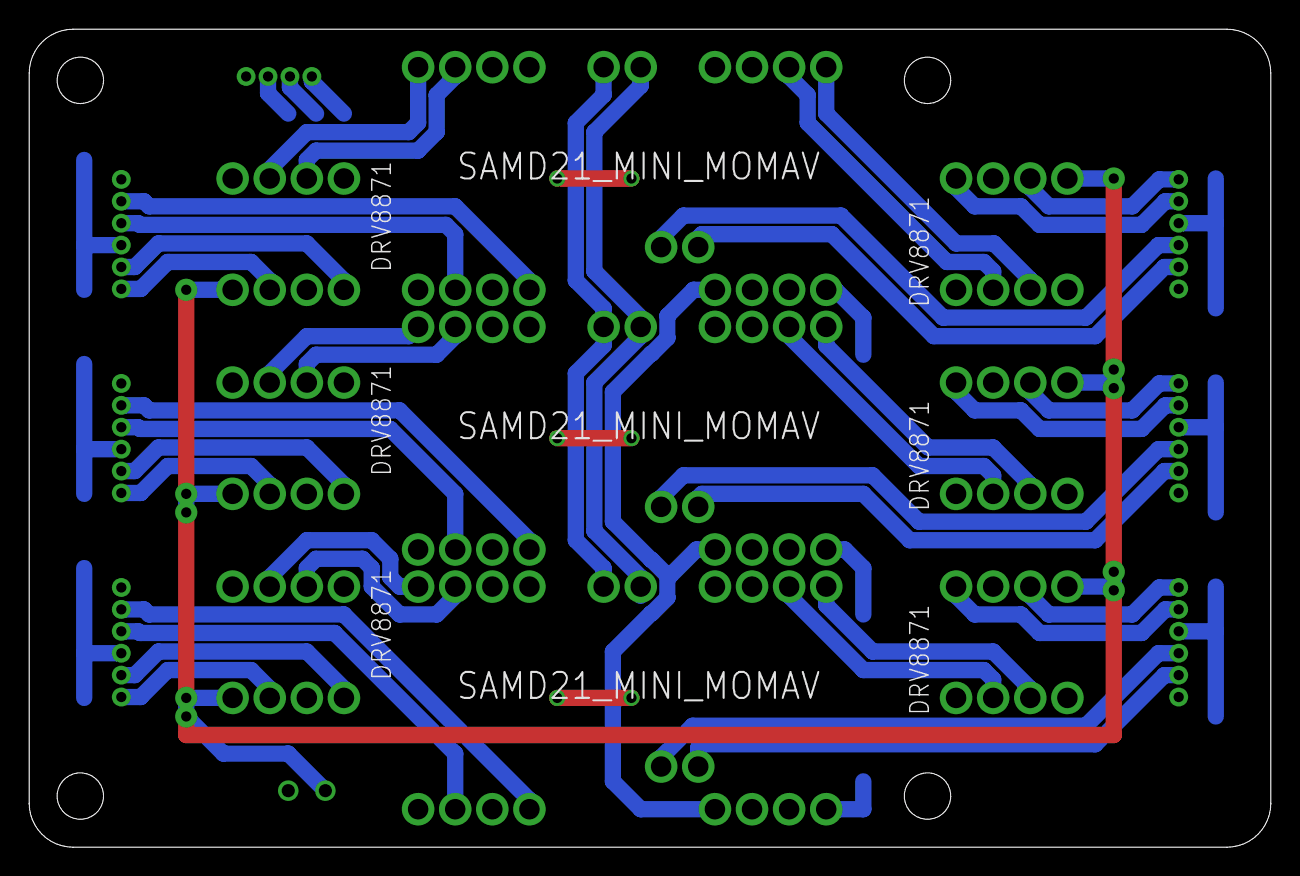
[picture p117: board momav_servo.brd from above]

Board: 2 copper layers, 85.0 x 56.0 mm, 17 parts (0 on the bottom side), 42 nets.
