mruggia/momav/2_pcb/power/momav_power.brd

## EAGLE design 2_pcb/power/momav_power.brd (2024-05-27)

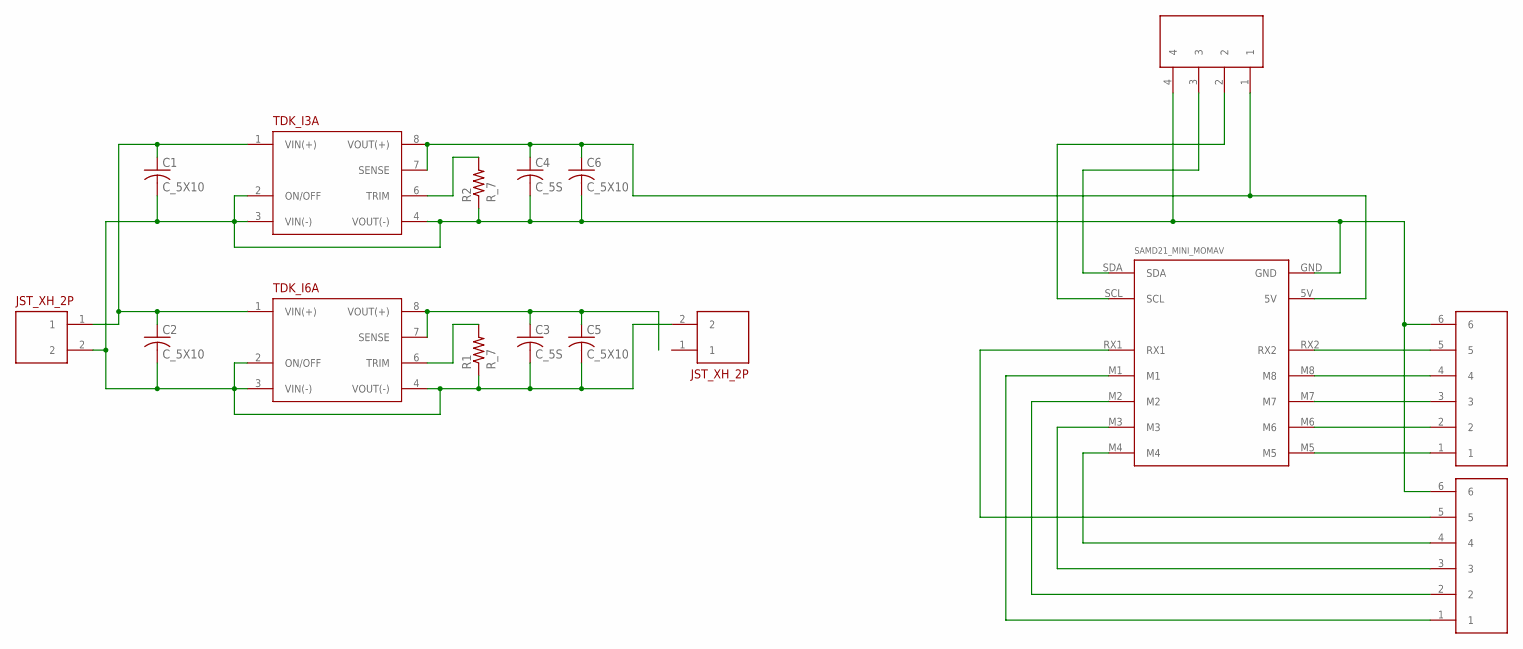
[picture p118: schematic momav_power.sch]

Parts:
C1, C2, C5, C6: C_5X10
C3, C4: C_5S
R1, R2: R_7
U$1, U$5: JST_XH_2P
U$2: TDK_I3A
U$3: TDK_I6A
U$4, U$6: JST_ZH_6P
U$7: JST_ZH_4P
U$8: SAMD21_MINI_MOMAV2

Connections:
GND: C1.2, C2.2, C3.2, C4.2, C5.2, C6.2, R1.1, R2.1, U$1.2, U$2.2 (ON/OFF), U$2.3 (VIN(-)), U$2.4 (VOUT(-)), U$3.2 (ON/OFF), U$3.3 (VIN(-)), U$3.4 (VOUT(-)), U$4.6, U$5.2, U$6.6, U$7.4, U$8.GND
unnamed: C4.1, C6.1, U$2.7 (SENSE), U$2.8 (VOUT(+)), U$7.1, U$8.5V
unnamed: C3.1, C5.1, U$3.7 (SENSE), U$3.8 (VOUT(+))
unnamed: C1.1, C2.1, U$2.1 (VIN(+)), U$3.1 (VIN(+)), U$5.1
unnamed: U$7.3, U$8.SDA
unnamed: U$7.2, U$8.SCL
unnamed: U$4.4, U$8.M4
unnamed: R2.2, U$2.6 (TRIM)
unnamed: R1.2, U$3.6 (TRIM)
unnamed: U$4.3, U$8.M3
unnamed: U$4.2, U$8.M2
unnamed: U$4.1, U$8.M1
unnamed: U$6.1, U$8.M5
unnamed: U$6.2, U$8.M6
unnamed: U$6.3, U$8.M7
unnamed: U$6.4, U$8.M8
unnamed: U$6.5, U$8.RX2
unnamed: U$4.5, U$8.RX1

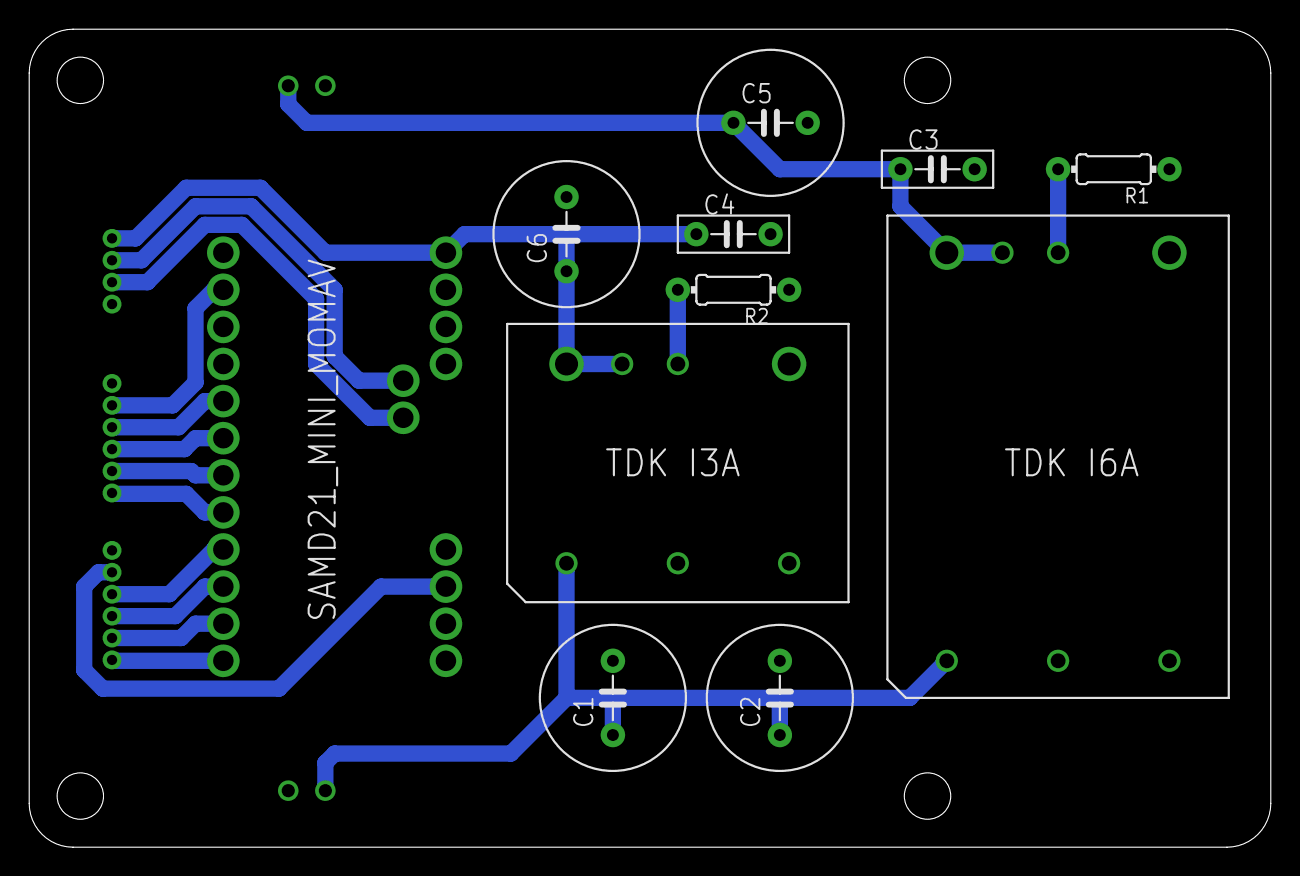
[picture p119: board momav_power.brd from above]

Board: 2 copper layers, 85.0 x 56.0 mm, 16 parts (0 on the bottom side), 18 nets.
