mruggia/momav/2_pcb/esc/momav_esc.brd

## EAGLE design 2_pcb/esc/momav_esc.brd (2024-05-27)

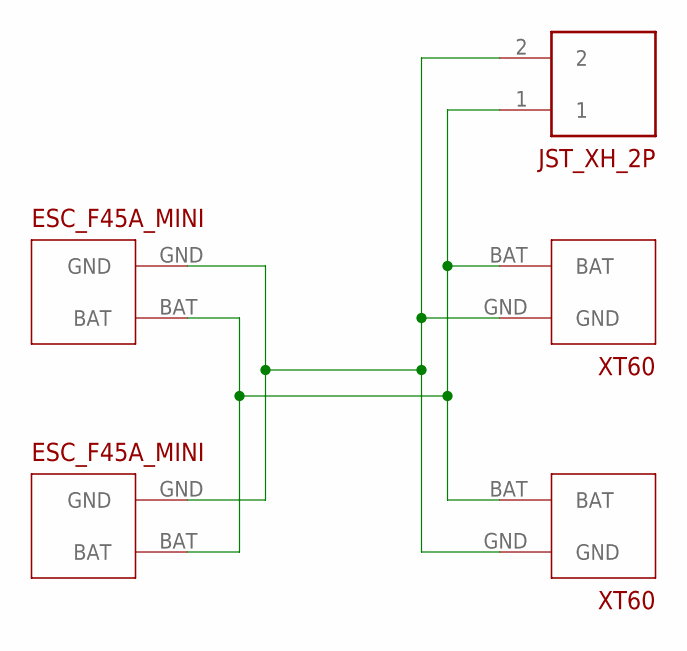
[picture p120: schematic momav_esc.sch]

Parts:
U$1, U$2: ESC_F45A_MINI
U$3, U$4: CONN_XT60
U$5: JST_XH_2P

Connections:
unnamed: U$1.GND, U$2.GND, U$3.GND, U$4.GND, U$5.2
unnamed: U$1.BAT, U$2.BAT, U$3.BAT, U$4.BAT, U$5.1

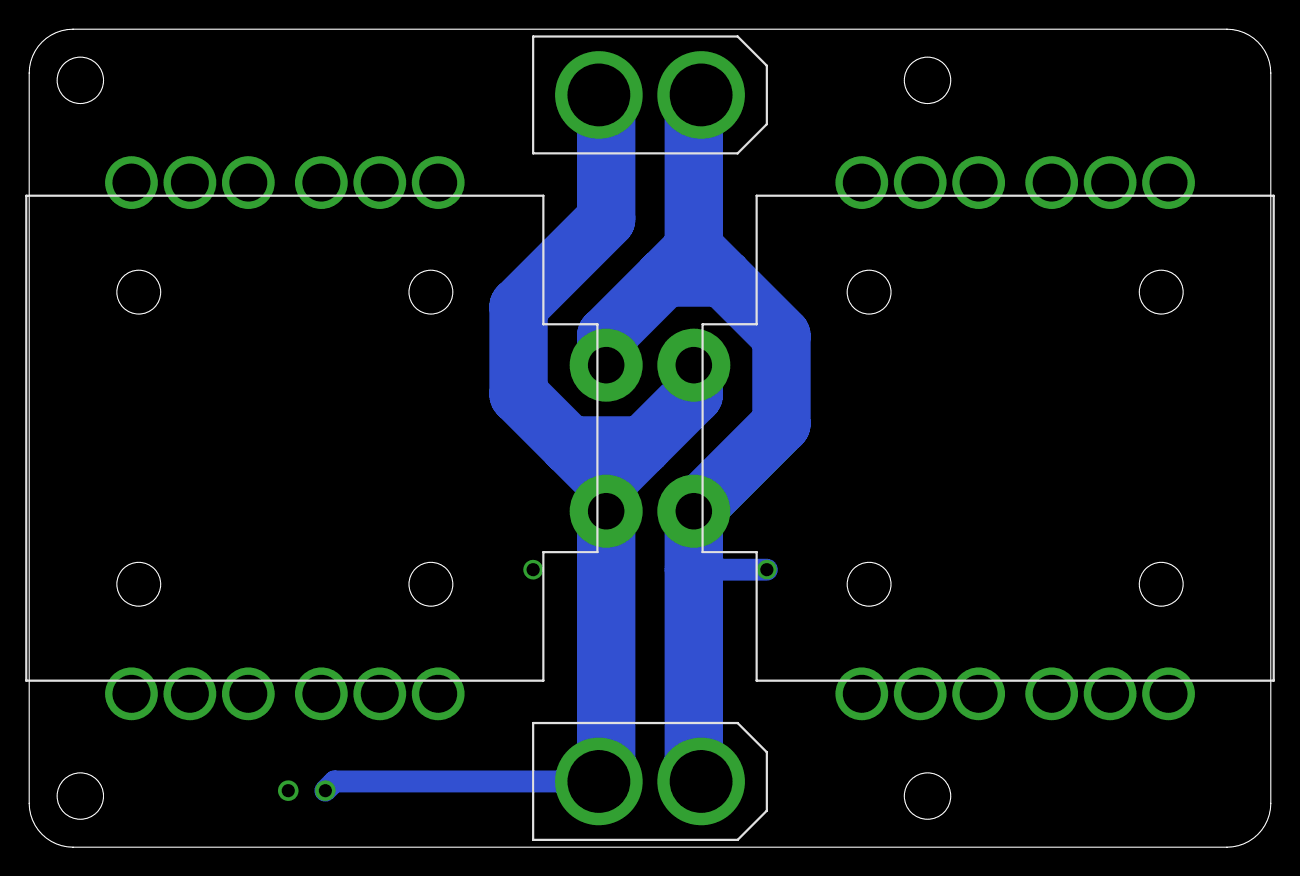
[picture p121: board momav_esc.brd from above]

Board: 2 copper layers, 85.0 x 56.0 mm, 5 parts (0 on the bottom side), 2 nets.
