mruggia/momav/2_pcb/imu/momav_imu.brd

## EAGLE design 2_pcb/imu/momav_imu.brd (2024-05-27)

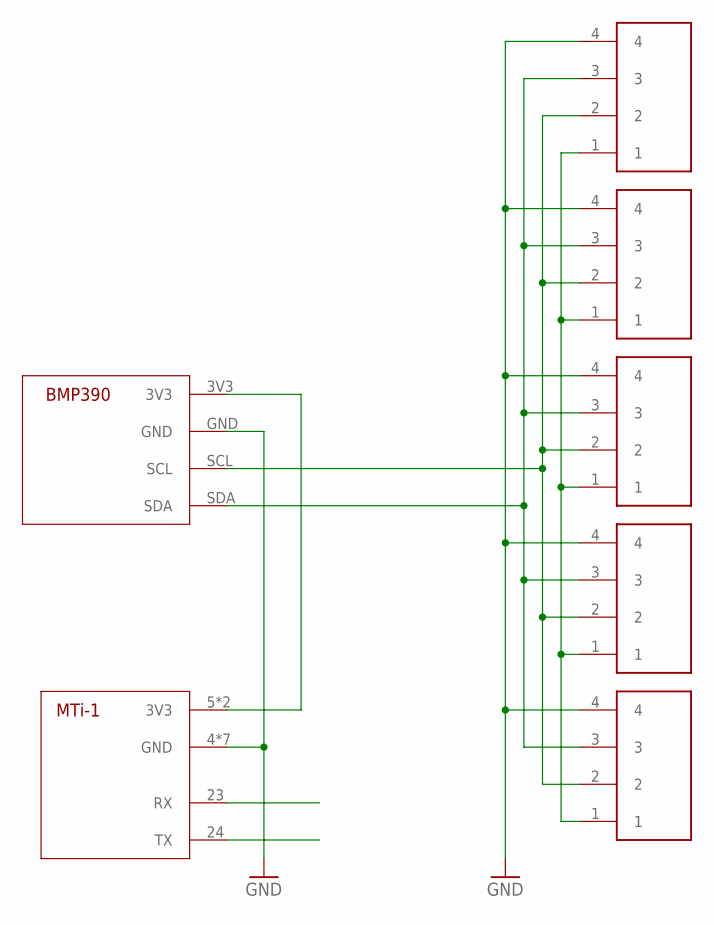
[picture p122: schematic momav_imu.sch]

Parts:
U$1, U$2, U$3, U$4, U$5: JST_ZH_4P
U$6: XSENS_MTI_1
U$7: BMP390

Connections:
3V3: U$6.5 (3V3), U$6.7 (3V3), U$7.3V3
5V: U$1.1, U$2.1, U$3.1, U$4.1, U$5.1
GND: U$1.4, U$2.4, U$3.4, U$4.4, U$5.4, U$6.4 (GND), U$6.8 (GND), U$6.13 (GND), U$6.14 (GND), U$6.15 (GND), U$6.22 (GND), U$6.25 (GND), U$7.GND
RX: U$6.23 (RX)
SCL: U$1.2, U$2.2, U$3.2, U$4.2, U$5.2, U$7.SCL
SDA: U$1.3, U$2.3, U$3.3, U$4.3, U$5.3, U$7.SDA
TX: U$6.24 (TX)

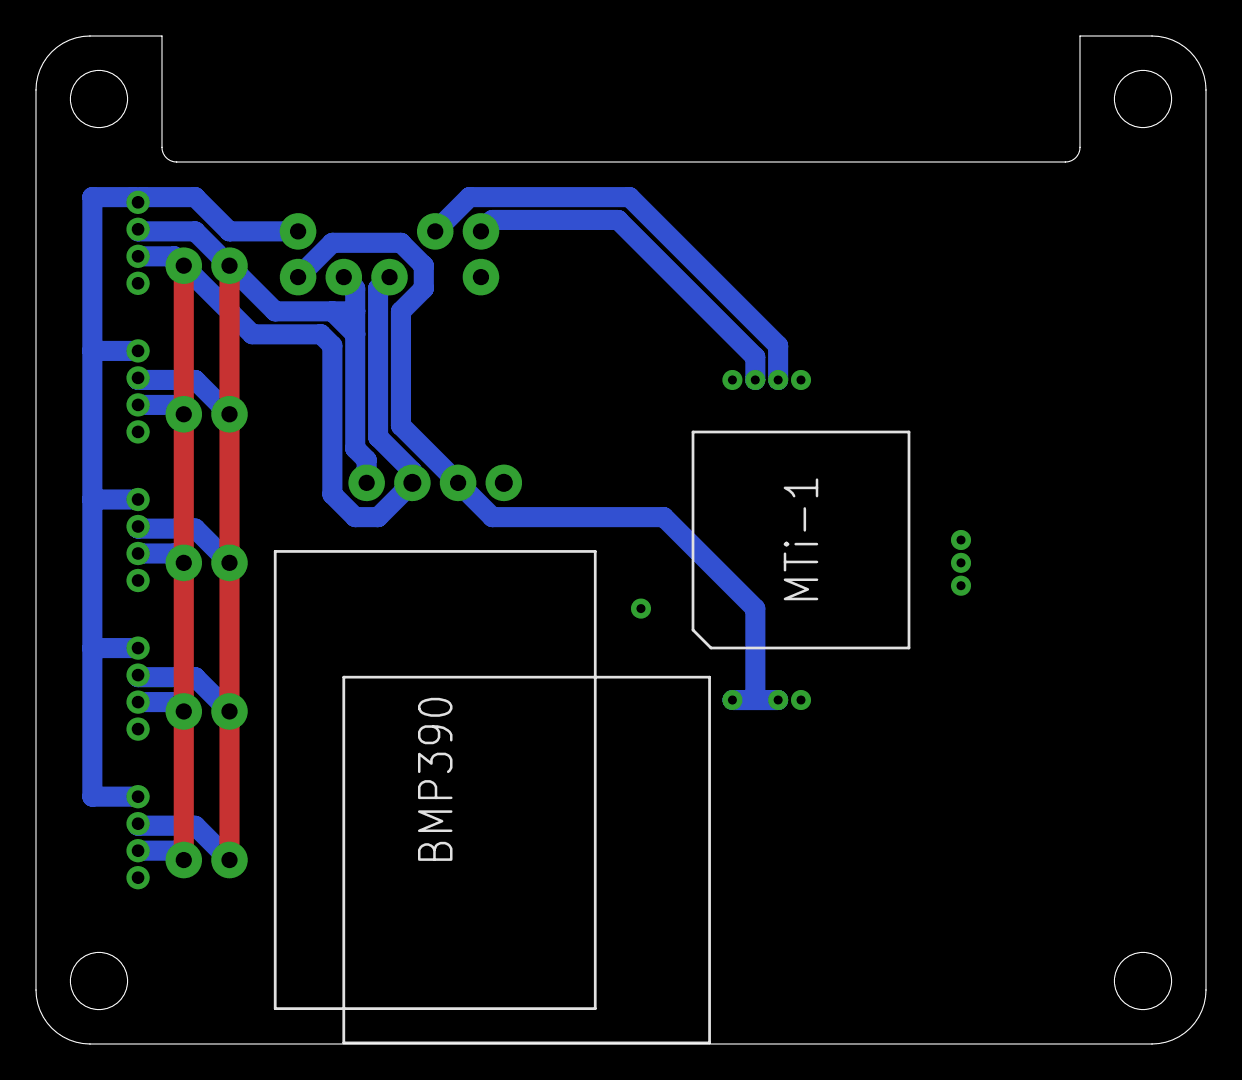
[picture p123: board momav_imu.brd from above]

Board: 2 copper layers, 65.0 x 56.0 mm, 7 parts (0 on the bottom side), 5 nets.
