mruggia/momav/5_test/2_arms/2_code/testarm_interface/BotaSerialSensor.py

import sys
import struct
import time
import threading

from collections import namedtuple

import serial
from crc import Calculator, Configuration


class BotaSerialSensor:
    
    BAUDERATE = 460800
    SINC_LENGTH = 512
    CHOP_ENABLE = 0
    FAST_ENABLE = 1
    FIR_DISABLE = 0
    TEMP_COMPENSATION = 0 # 0: Disabled (recommended), 1: Enabled
    USE_CALIBRATION = 1 # 1: calibration matrix active, 0: raw measurements
    DATA_FORMAT = 0 # 0: binary, 1: CSV
    BAUDERATE_CONFIG = 4 # 0: 9600, 1: 57600, 2: 115200, 3: 230400, 4: 460800
    FRAME_HEADER = b'\xAA'
    # Note that the time step is set according to the sinc filter size!
    time_step = 0.01;

    def __init__(self, port):
        self._port = port
        self._ser = serial.Serial()
        self._pd_thread_stop_event = threading.Event()
        self._status = None;
        self._fx = 0.0;
        self._fy = 0.0;
        self._fz = 0.0;
        self._mx = 0.0;
        self._my = 0.0;
        self._mz = 0.0;
        self._timestamp = 0.0;
        self._temperature = 0.0;


    def bota_sensor_setup(self):
        # Wait for streaming of data
        out = self._ser.read_until(bytes('App Init', 'ascii'))
        if not self.contains_bytes(bytes('App Init', 'ascii'), out):
            print("Sensor not streaming, check if correct port selected!")
            return False
        time.sleep(0.5)
        self._ser.reset_input_buffer()
        self._ser.reset_output_buffer()

        # Go to CONFIG mode
        cmd = bytes('C', 'ascii')
        self._ser.write(cmd)
        out = self._ser.read_until(bytes('r,0,C,0', 'ascii'))
        if not self.contains_bytes(bytes('r,0,C,0', 'ascii'), out):
            print("Failed to go to CONFIG mode.")
            return False

        # Communication setup
        comm_setup = f"c,{self.TEMP_COMPENSATION},{self.USE_CALIBRATION},{self.DATA_FORMAT},{self.BAUDERATE_CONFIG}"
        #print(comm_setup)
        cmd = bytes(comm_setup, 'ascii')
        self._ser.write(cmd)
        out = self._ser.read_until(bytes('r,0,c,0', 'ascii'))
        if not self.contains_bytes(bytes('r,0,c,0', 'ascii'), out):
            print("Failed to set communication setup.")
            return False
        self.time_step = 0.00001953125*self.SINC_LENGTH

        # Filter setup
        filter_setup = f"f,{self.SINC_LENGTH},{self.CHOP_ENABLE},{self.FAST_ENABLE},{self.FIR_DISABLE}"
        #print(filter_setup)
        cmd = bytes(filter_setup, 'ascii')
        self._ser.write(cmd)
        out = self._ser.read_until(bytes('r,0,f,0', 'ascii'))
        if not self.contains_bytes(bytes('r,0,f,0', 'ascii'), out):
            print("Failed to set filter setup.")
            return False

        # Go to RUN mode
        cmd = bytes('R', 'ascii')
        self._ser.write(cmd)
        out = self._ser.read_until(bytes('r,0,R,0', 'ascii'))
        if not self.contains_bytes(bytes('r,0,R,0', 'ascii'), out):
            print("Failed to go to RUN mode.")
            return False

        return True

    def contains_bytes(self, subsequence, sequence):
        return subsequence in sequence

    def _processdata_thread(self):
        while not self._pd_thread_stop_event.is_set():
            frame_synced = False
            crc16X25Configuration = Configuration(16, 0x1021, 0xFFFF, 0xFFFF, True, True)
            crc_calculator = Calculator(crc16X25Configuration)

            while not frame_synced and not self._pd_thread_stop_event.is_set():
                possible_header = self._ser.read(1)
                if self.FRAME_HEADER == possible_header:
                    #print(possible_header)
                    data_frame = self._ser.read(34)
                    crc16_ccitt_frame = self._ser.read(2)

                    crc16_ccitt = struct.unpack_from('H', crc16_ccitt_frame, 0)[0]
                    checksum = crc_calculator.checksum(data_frame)
                    if checksum == crc16_ccitt:
                        frame_synced = True
                    else:
                        self._ser.read(1)

            while frame_synced and not self._pd_thread_stop_event.is_set():            
                start_time = time.perf_counter()
                frame_header = self._ser.read(1)

                if frame_header != self.FRAME_HEADER:
                    print("Lost sync")
                    frame_synced = False
                    break

                data_frame = self._ser.read(34)
                crc16_ccitt_frame = self._ser.read(2)

                crc16_ccitt = struct.unpack_from('H', crc16_ccitt_frame, 0)[0]
                checksum = crc_calculator.checksum(data_frame)
                if checksum != crc16_ccitt:
                    print("CRC mismatch received")
                    break

                self._status = struct.unpack_from('H', data_frame, 0)[0]

                self._fx = struct.unpack_from('f', data_frame, 2)[0]
                self._fy = struct.unpack_from('f', data_frame, 6)[0]
                self._fz = struct.unpack_from('f', data_frame, 10)[0]
                self._mx = struct.unpack_from('f', data_frame, 14)[0]
                self._my = struct.unpack_from('f', data_frame, 18)[0]
                self._mz = struct.unpack_from('f', data_frame, 22)[0]

                self._timestamp = struct.unpack_from('I', data_frame, 26)[0]

                self._temperature = struct.unpack_from('f', data_frame, 30)[0]
                
                time_diff = time.perf_counter() - start_time

                self._callback(self._timestamp,self._fx,self._fy,self._fz,self._mx,self._my,self._mz,self._temperature)


    def run(self, callback):

        self._ser.baudrate = self.BAUDERATE
        self._ser.port = self._port
        self._ser.timeout = 10

        try:
            self._ser.open()
        except:
            raise BotaSerialSensorError('Could not open port')

        if not self._ser.is_open:
            raise BotaSerialSensorError('Could not open port')

        if not self.bota_sensor_setup():
            print('Could not setup sensor!')
            return

        self._callback = callback

        self._proc_thread = threading.Thread(target=self._processdata_thread)
        self._proc_thread.start()

        
    def stop(self):

        self._pd_thread_stop_event.set()
        self._proc_thread.join()

        self._ser.close()


class BotaSerialSensorError(Exception):
    def __init__(self, message):
        super(BotaSerialSensorError, self).__init__(message)
        self.message = message
